bhoreal/bhoreal/software/Processing/bhorealEmulator/data/Wood Black top.jpg

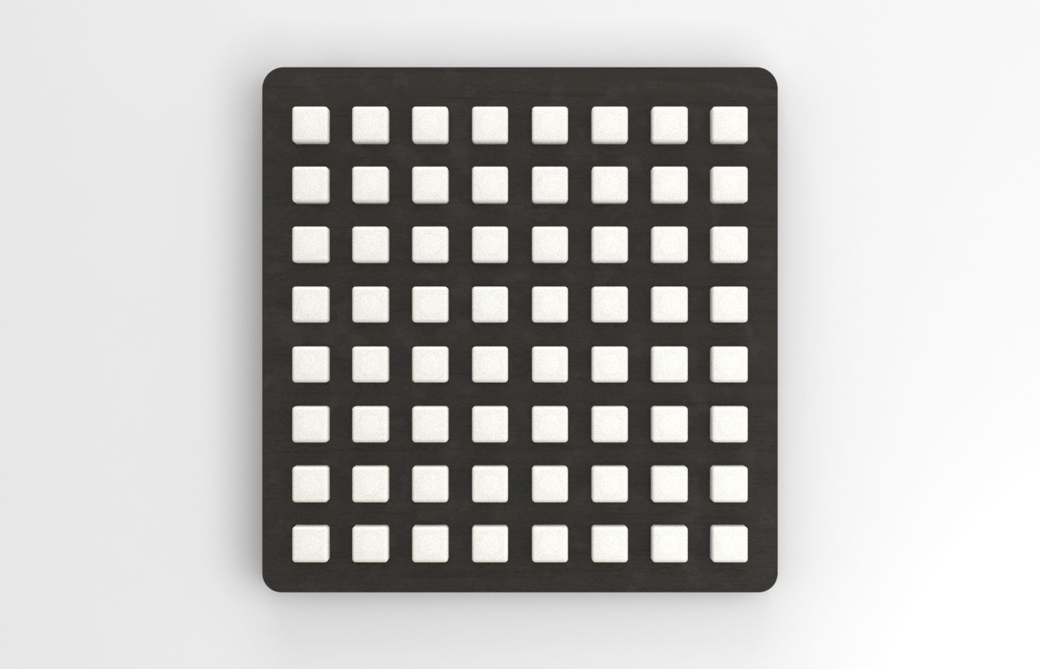
software/Processing/bhorealEmulator/data/Wood Black top.jpg
