bhoreal/bhoreal/software/Processing/bhorealEmulator/data/back_iPad.jpg

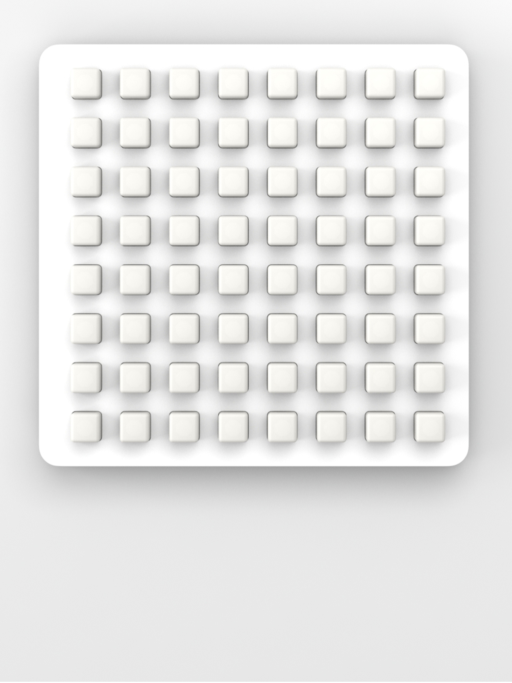
software/Processing/bhorealEmulator/data/back_iPad.jpg
