bhoreal/bhoreal/software/Processing/bhorealEmulator/data/fondo.png

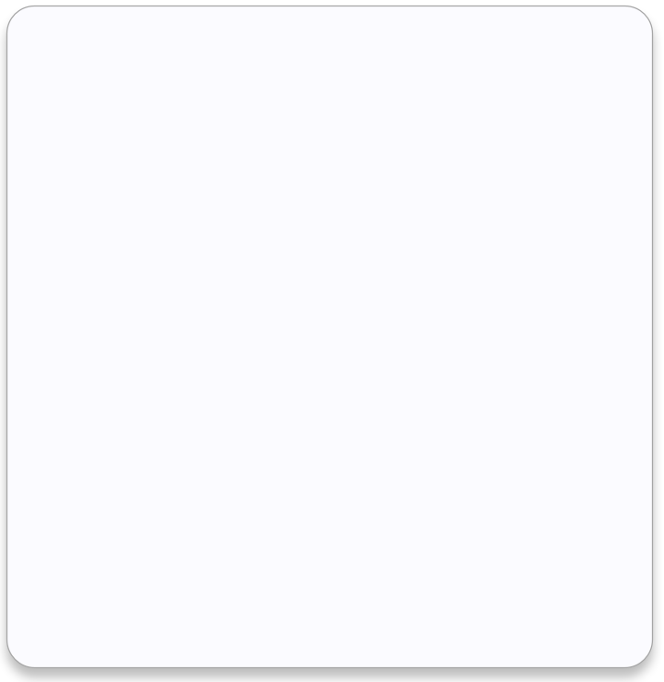
software/Processing/bhorealEmulator/data/fondo.png
