bhoreal/bhoreal/software/Processing/bhorealEmulator/data/fondoBlack.png

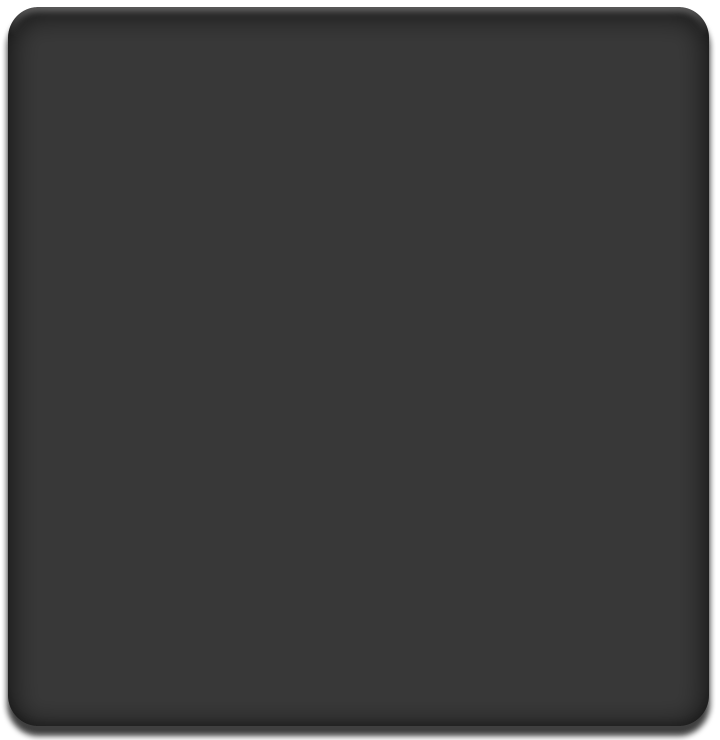
software/Processing/bhorealEmulator/data/fondoBlack.png
