bhoreal/bhoreal/hardware/Bhoreal Mini Slim Schematics/bhoreal_mini_bom.png

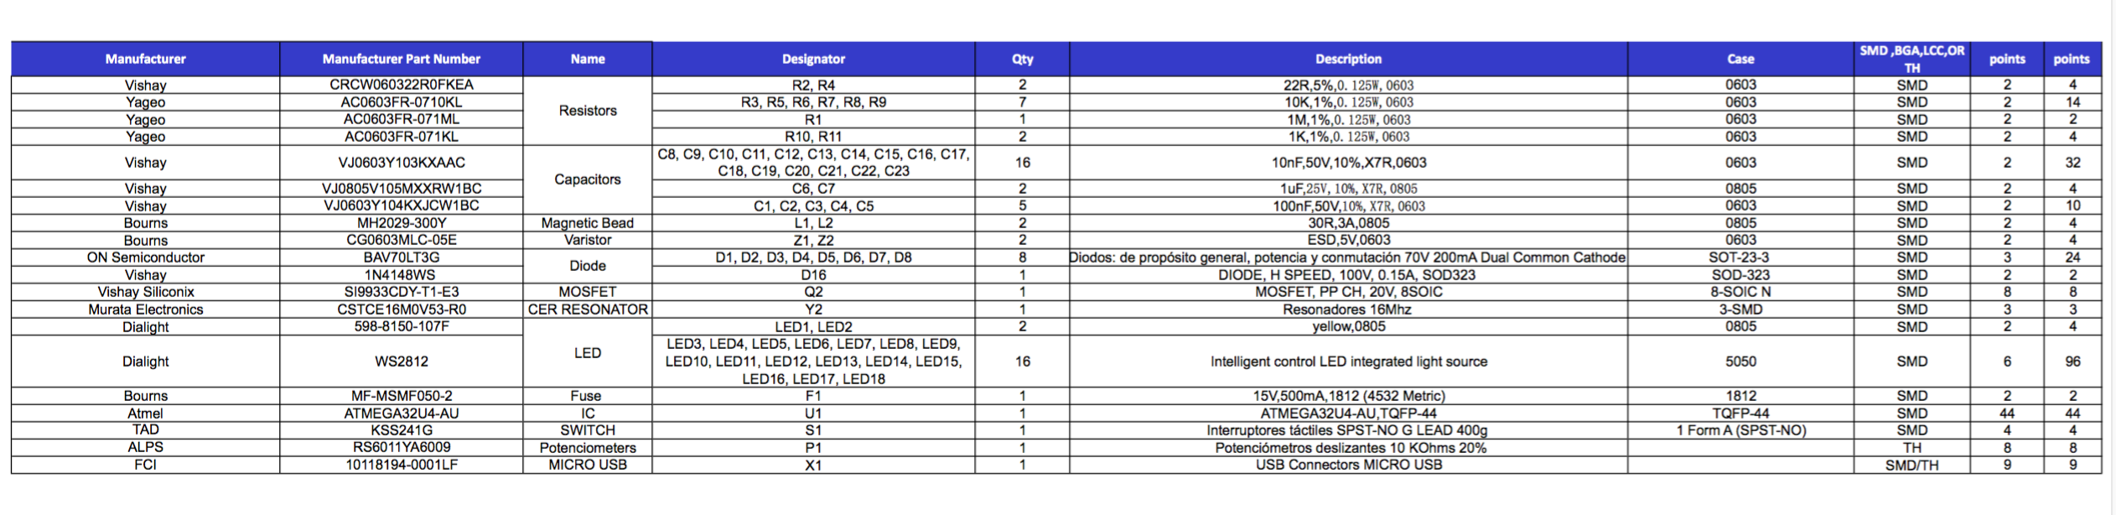
hardware/Bhoreal Mini Slim Schematics/bhoreal_mini_bom.png
