bhoreal/bhoreal/hardware/Bhoreal Slim Pro Schematics/bhoral_slimpro_bom.png

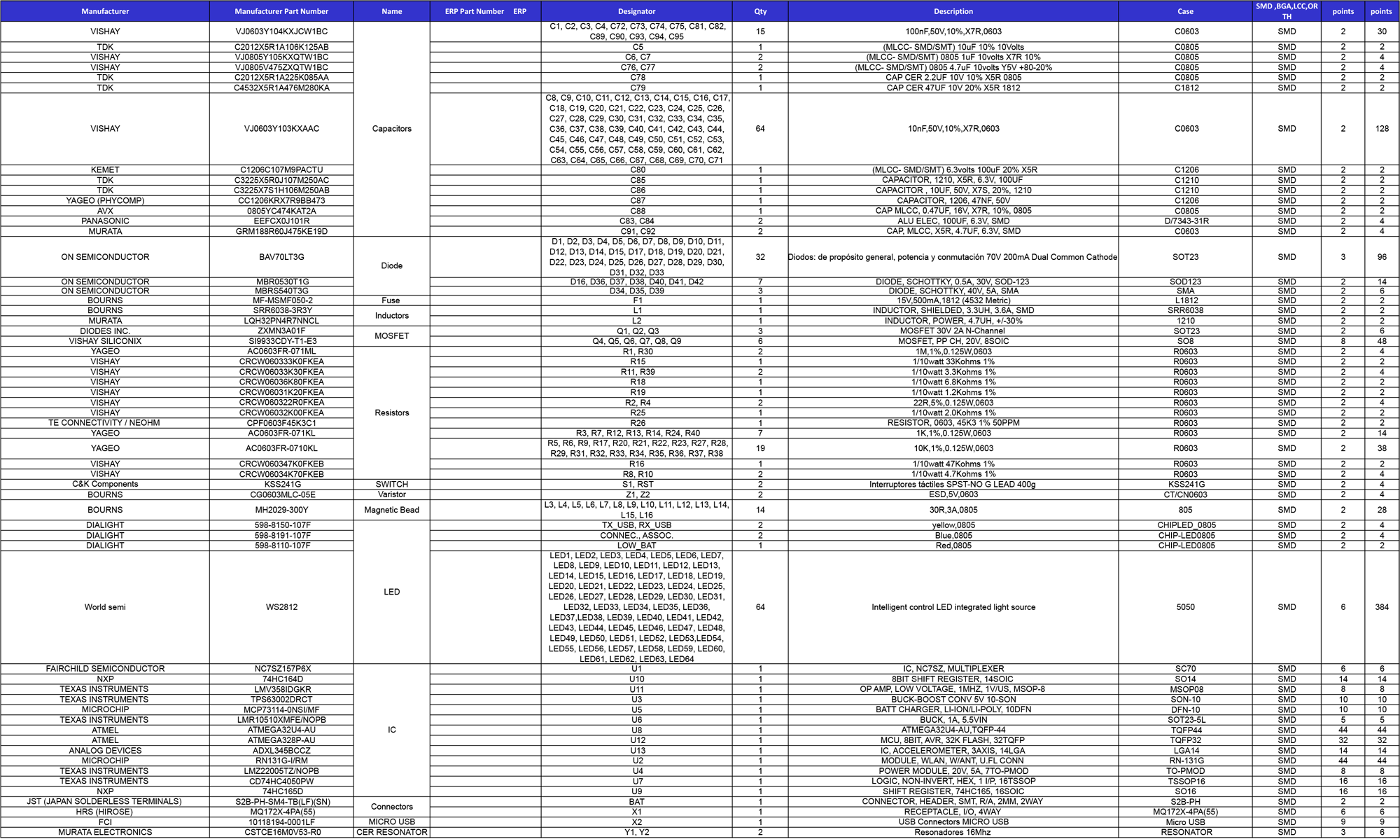
hardware/Bhoreal Slim Pro Schematics/bhoral_slimpro_bom.png
