bhoreal/bhoreal/(threads)

Thread 1 (2016-10-19):

Case-layout

bennigraf, 2016-10-19:
Hey guys,

not sure if there's still some life in here, but I'll give it a try:

I backed the original non-slim bhoreal without a case back then. Is there some basic layout file for a laser-cut case for this available?

Thanks,
Benni.

makegeneve, 2018-02-23:
The original promise for this included hardware design files for the casing.  I'll start drawing up one soon, but if you guys have them lying around and could post them it would save a bunch of music-making time...

bennigraf, 2018-02-23:
@makegeneve Back then, I started to create my own simple laser-cut-case. I never actually finished it, but maybe you could use it as a starting point :-). I just uploaded it here: https://github.com/bennigraf/bhoreal-case

Also let me know if you come up with something, as my bhoreal is still laying around naked ;-).
