bhoreal/bhoreal/hardware/Bhoreal Slim Pro Schematics/Bhoreal Slimpro.pdf

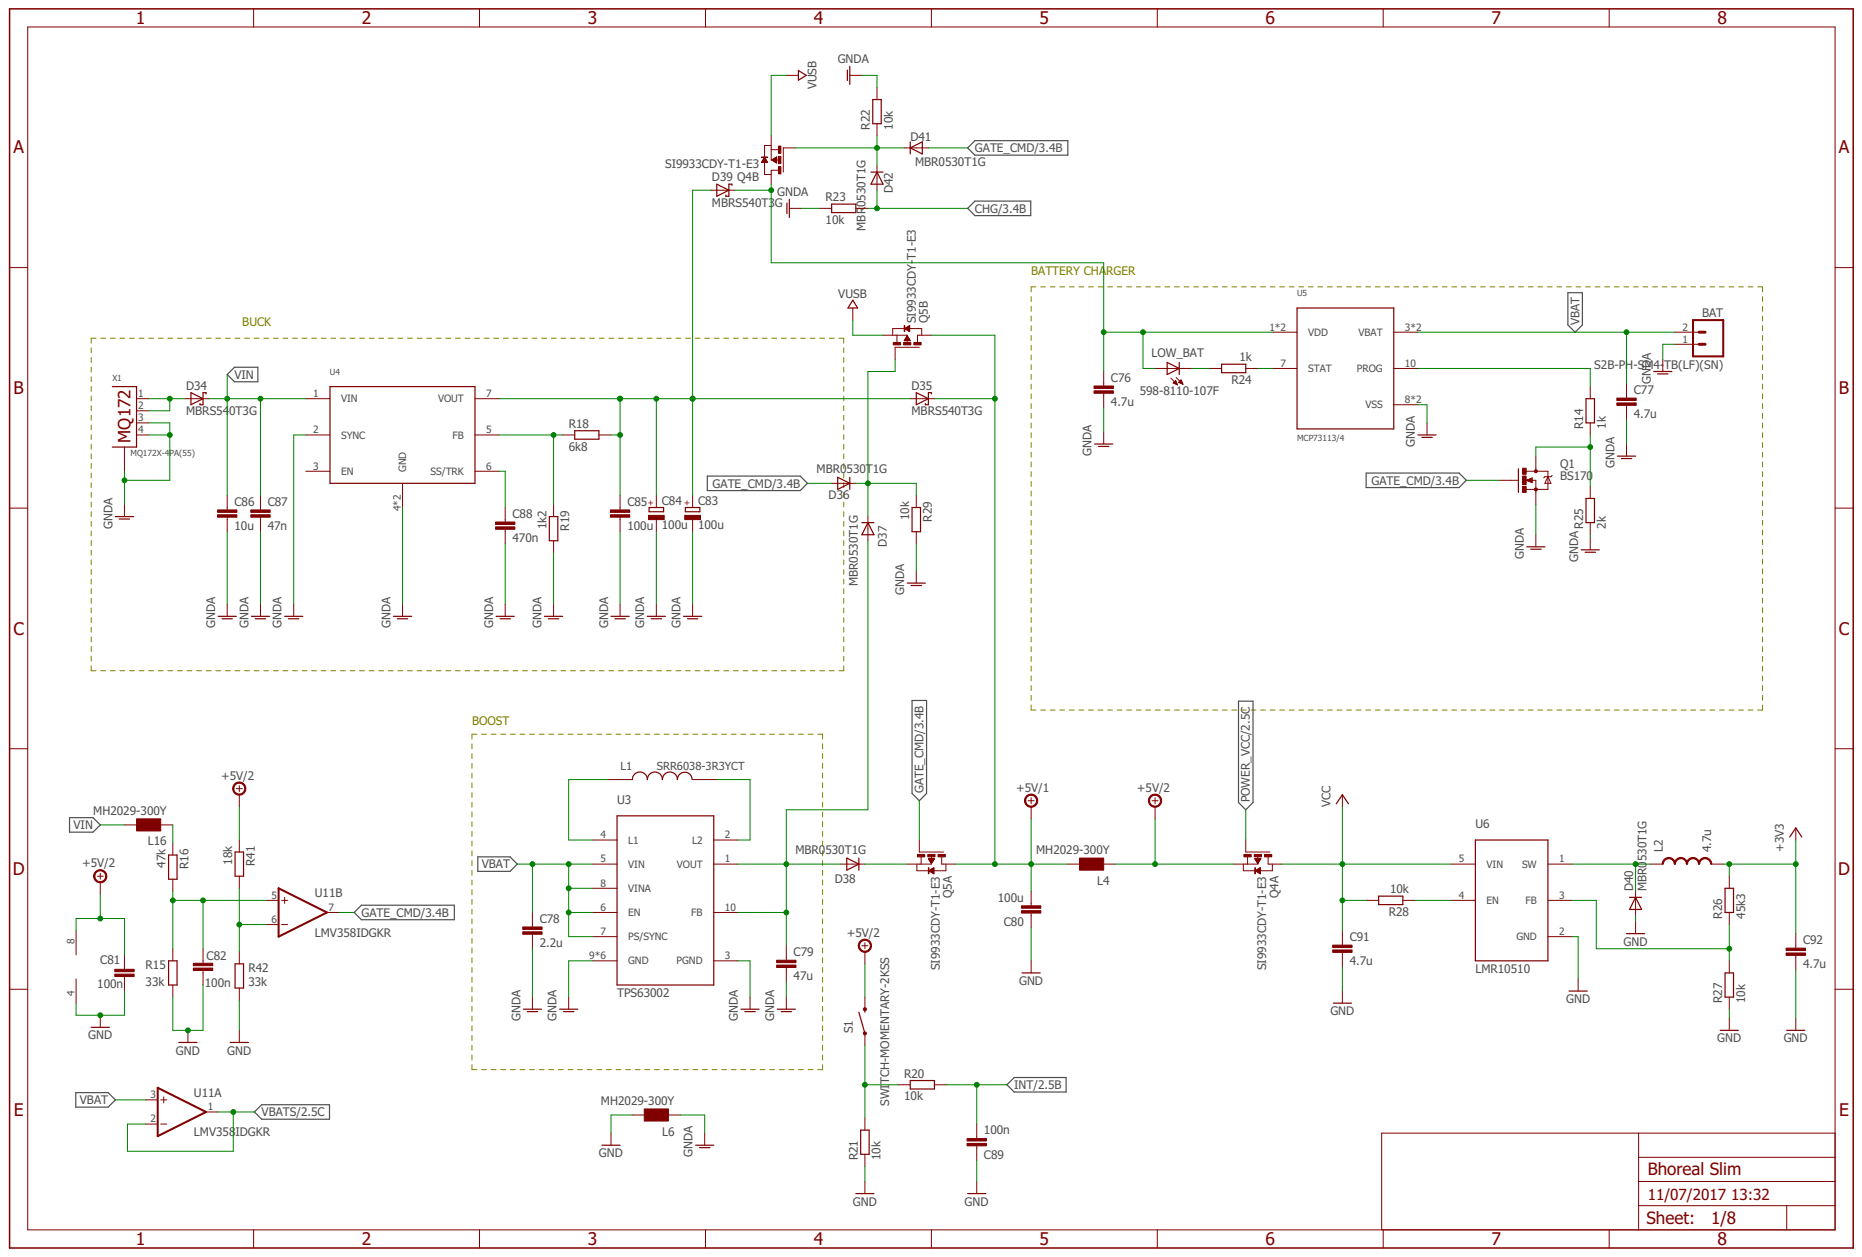
[picture p7: page 1]

GNDA GNDA

GNDA GNDA GNDA GNDA GNDA

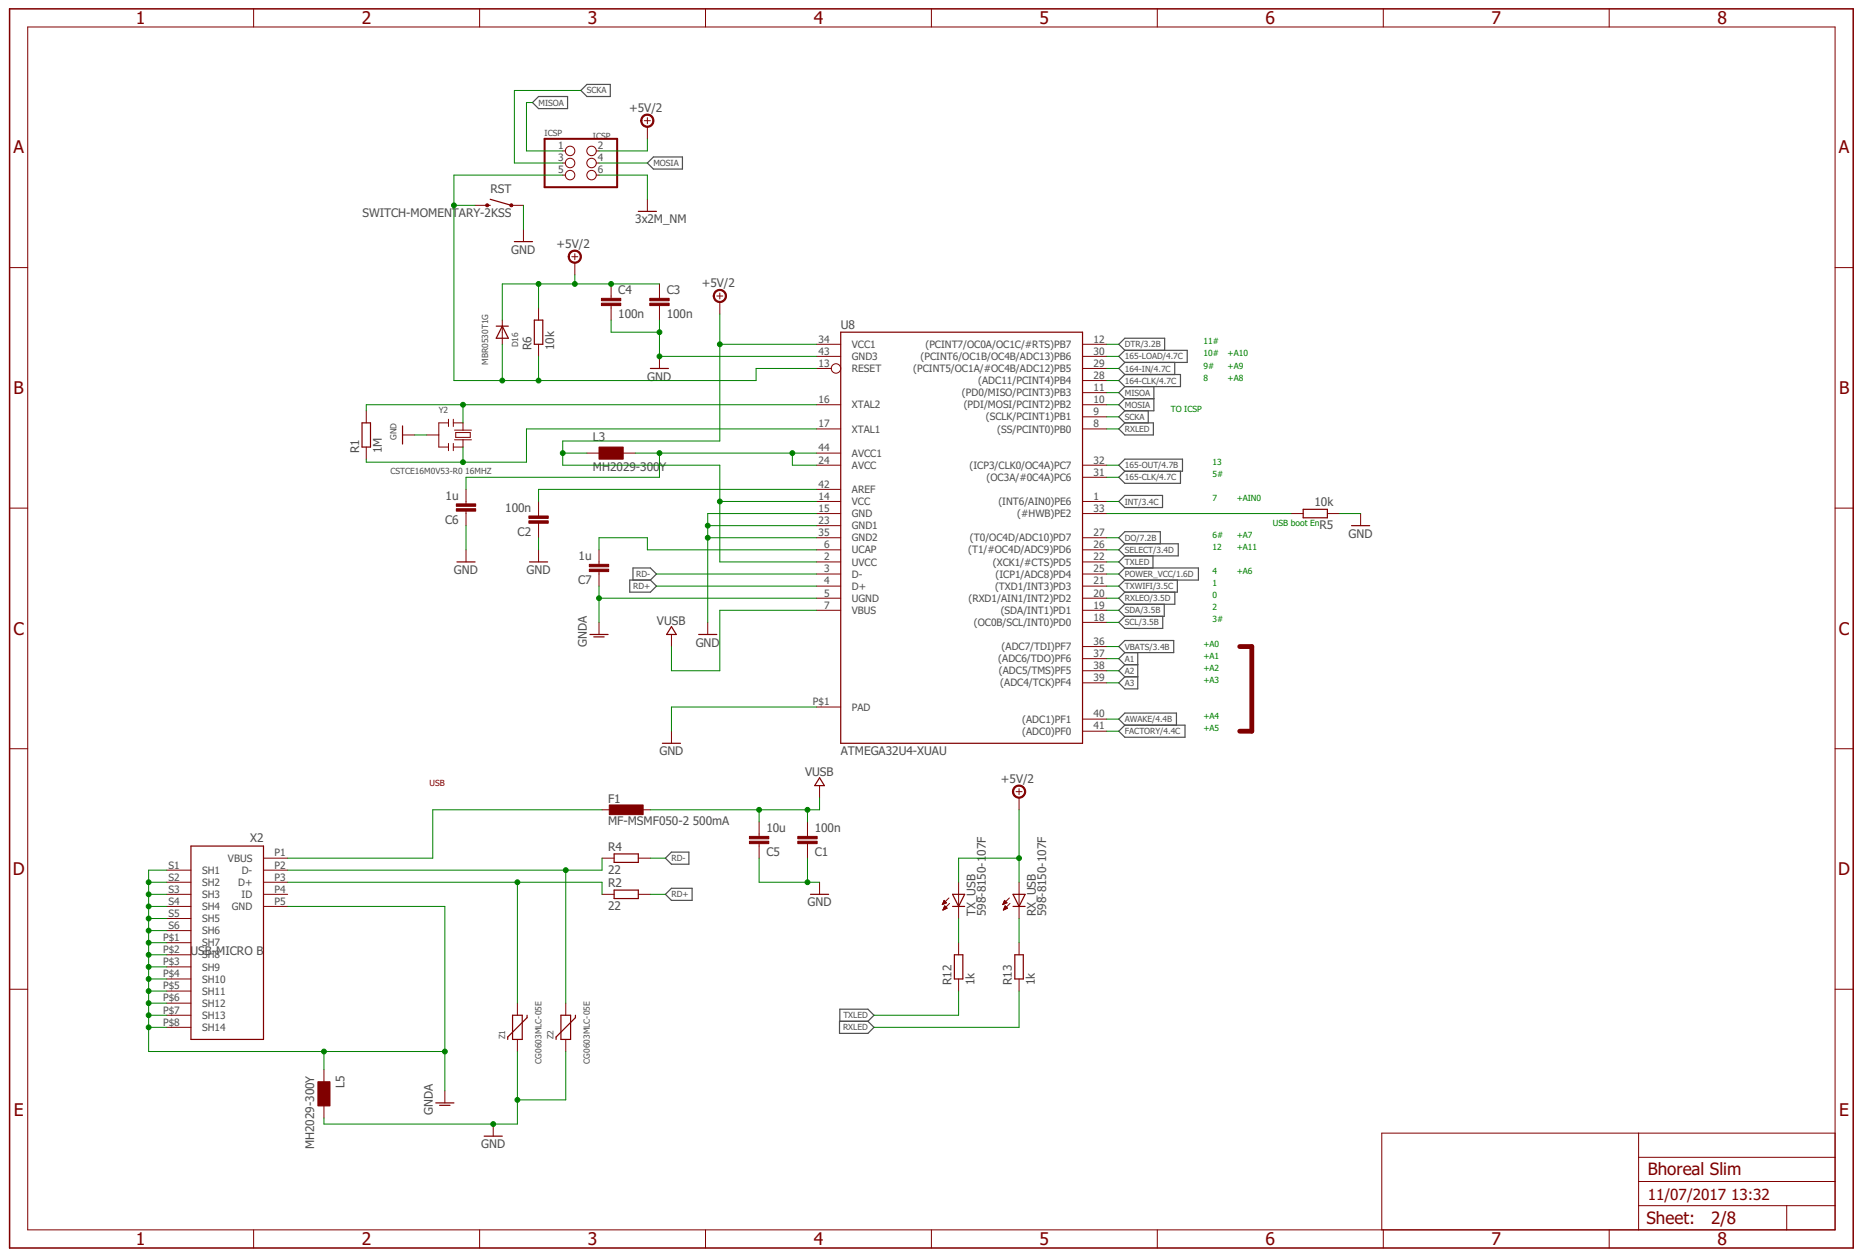
[picture p8: page 2]

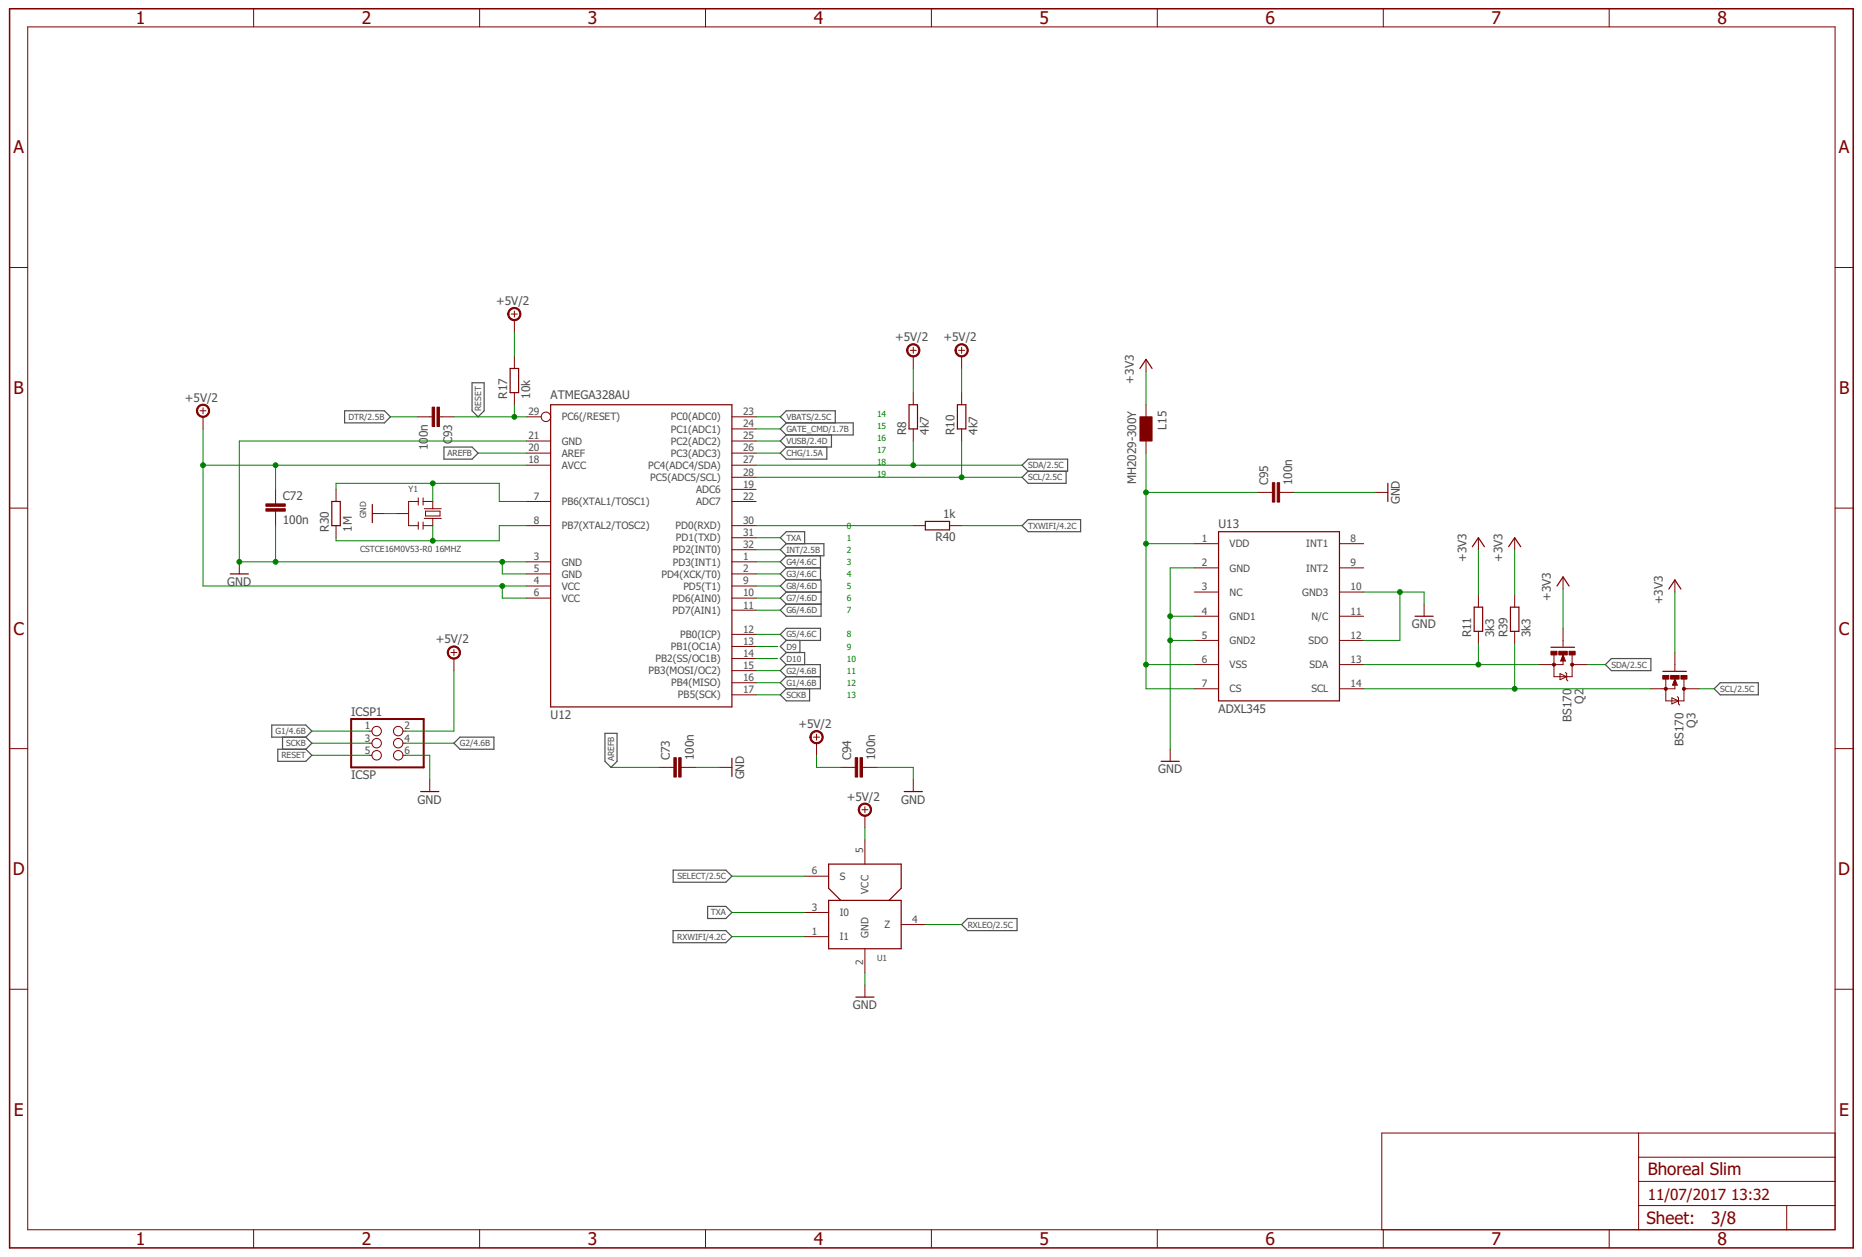
[picture p9: page 3]

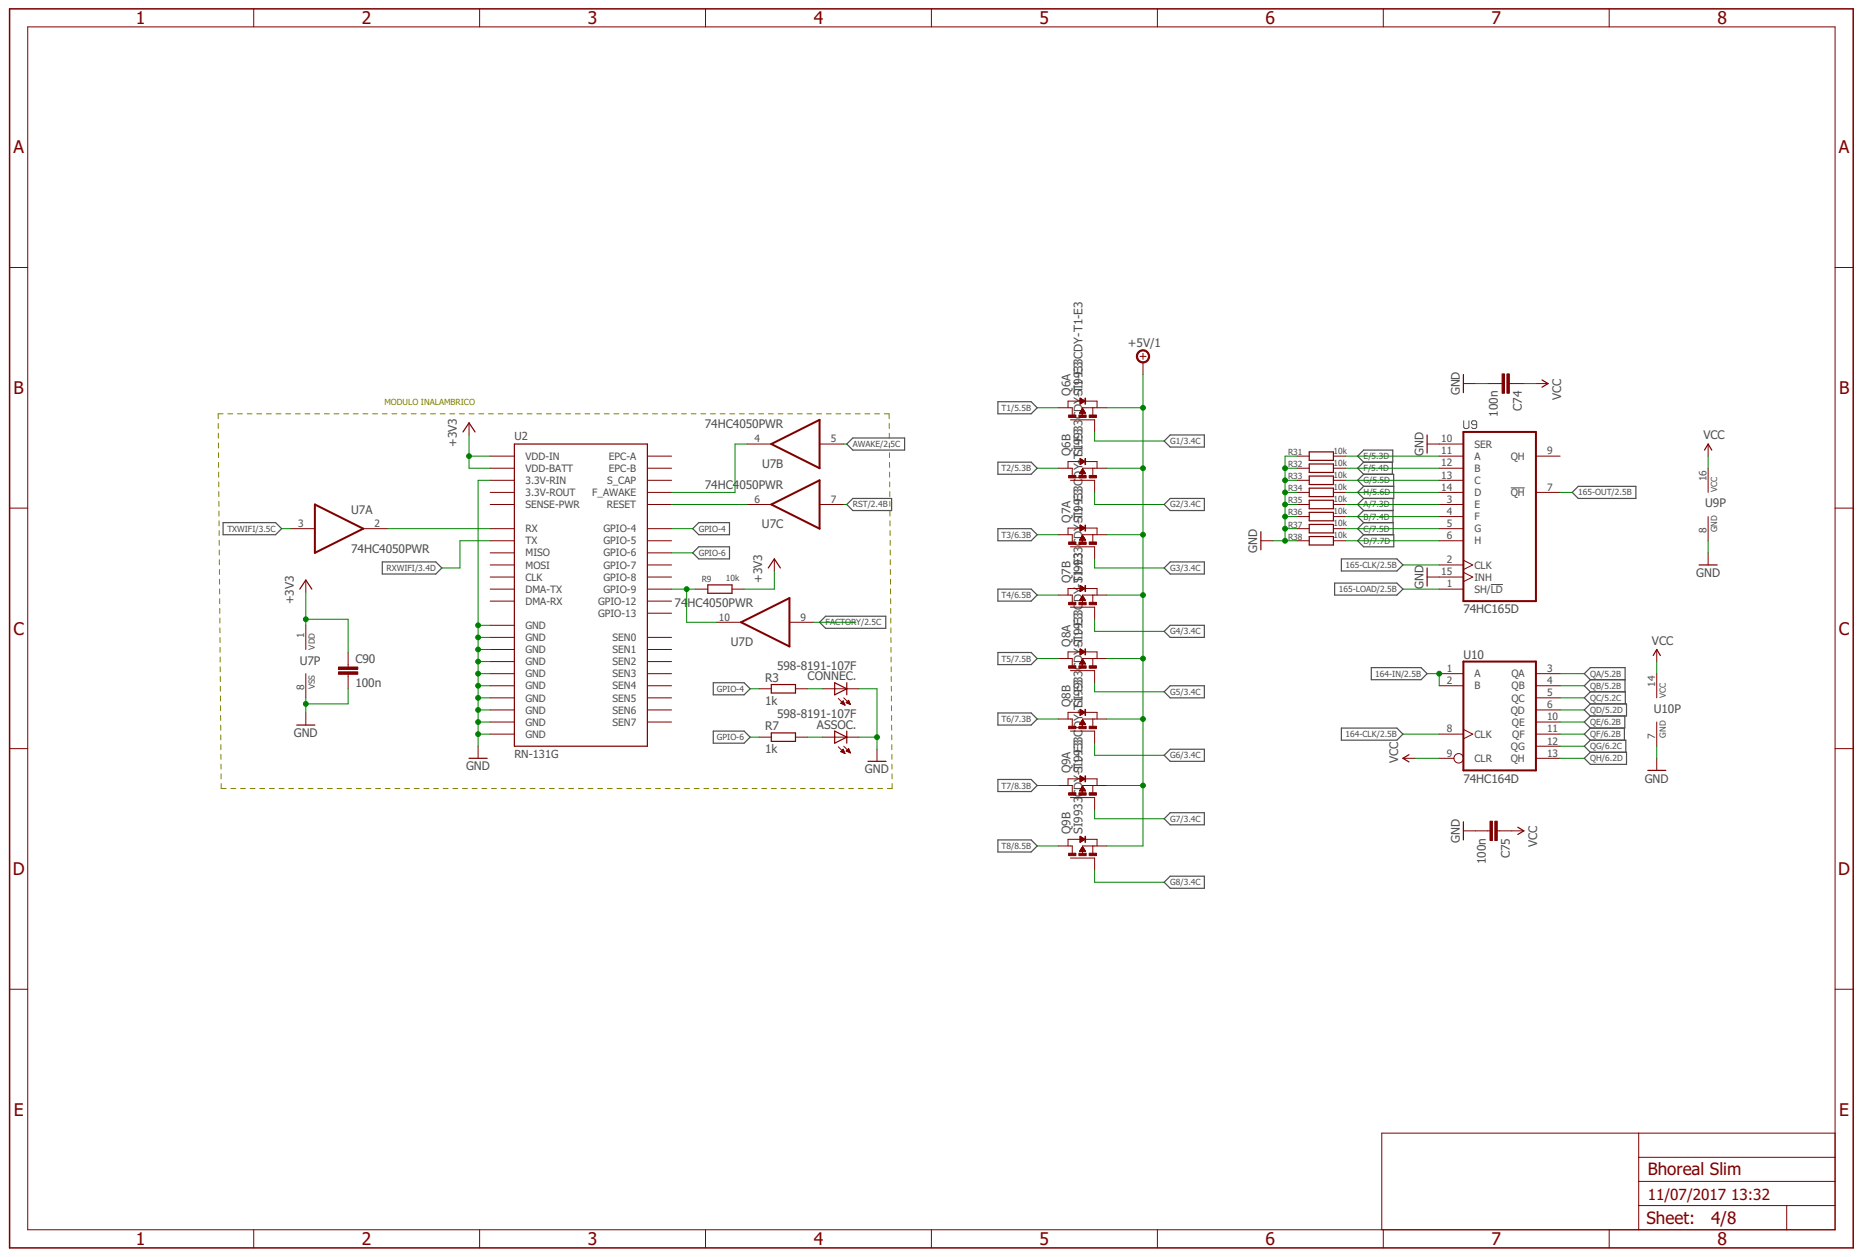
[picture p10: page 4]

VDD-BATT VDD-IN

VCC

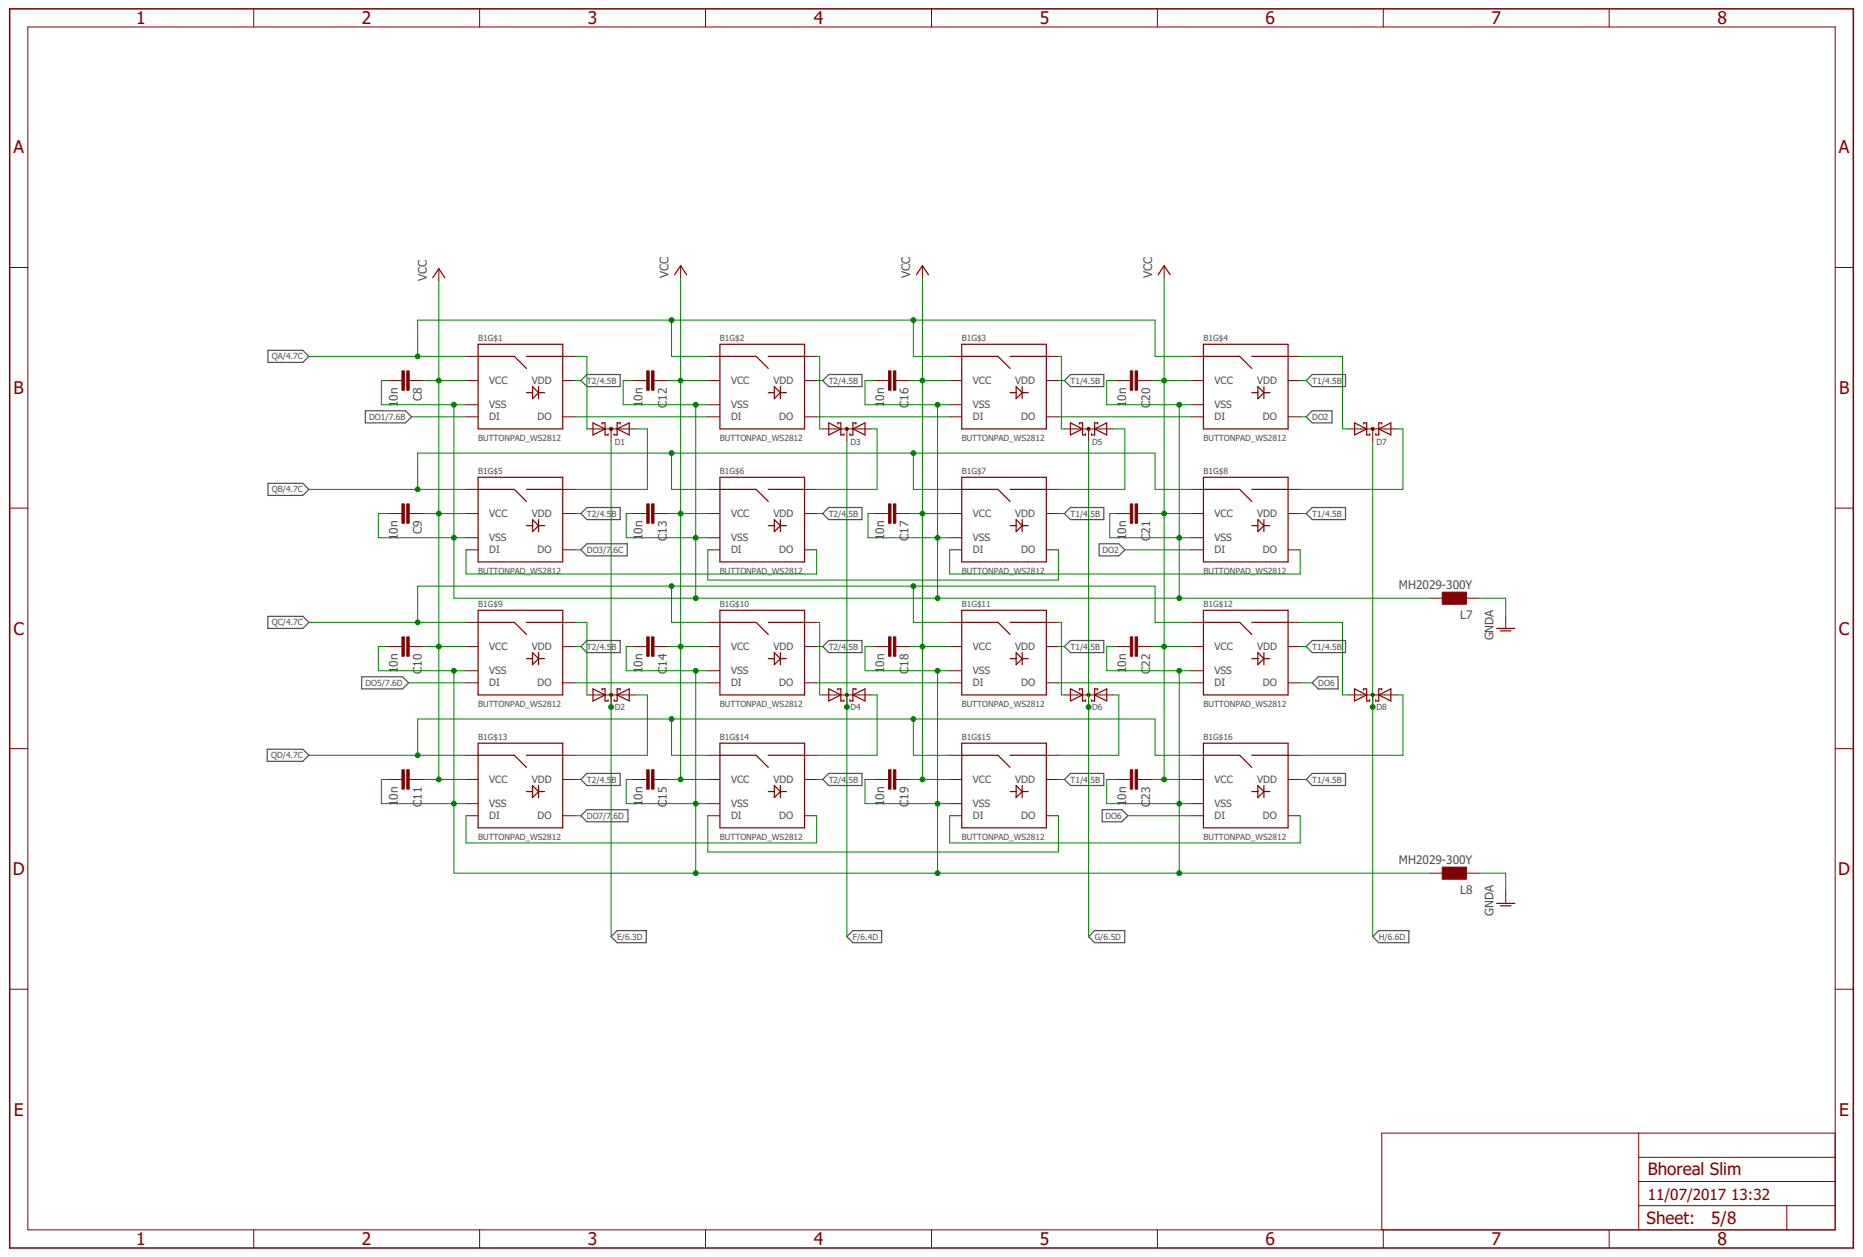
[picture p11: page 5]

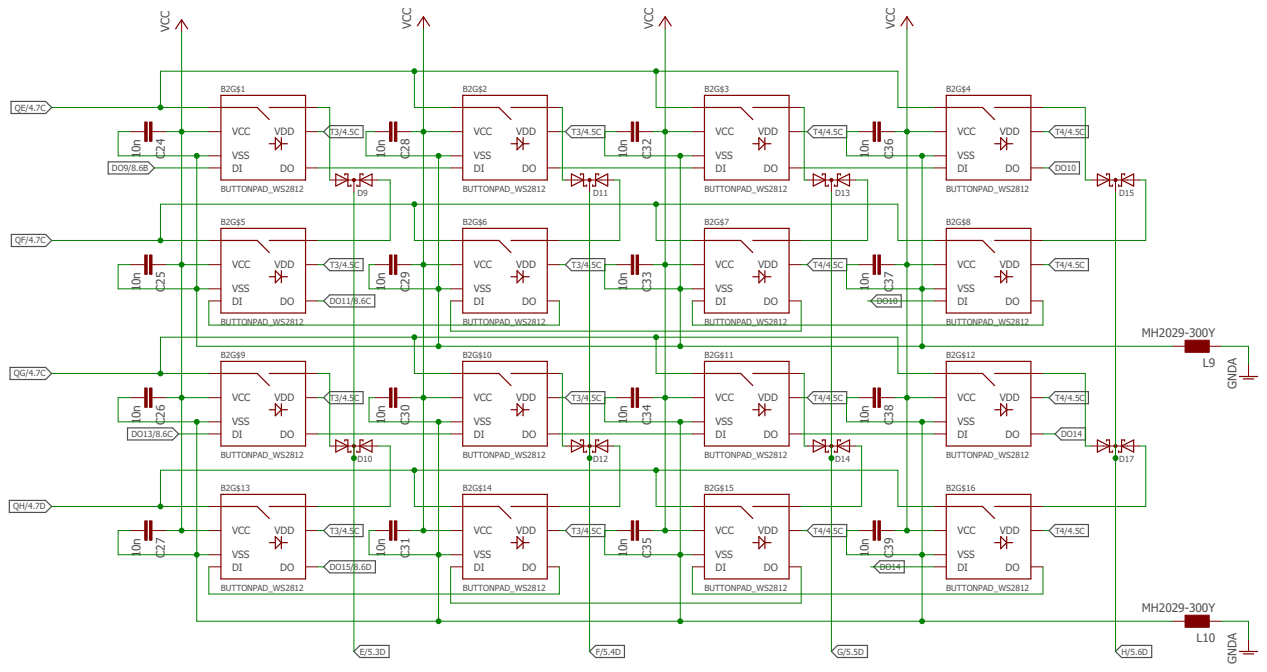
[picture p12: page 6]

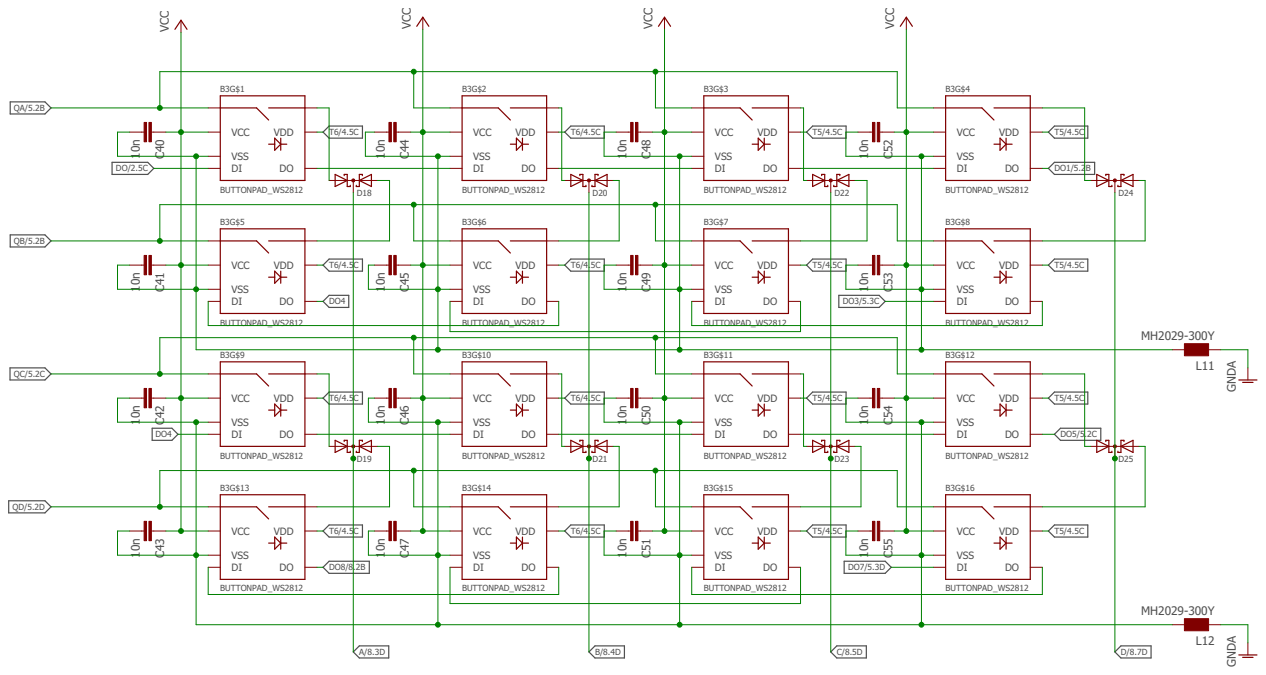
[picture p13: page 7]

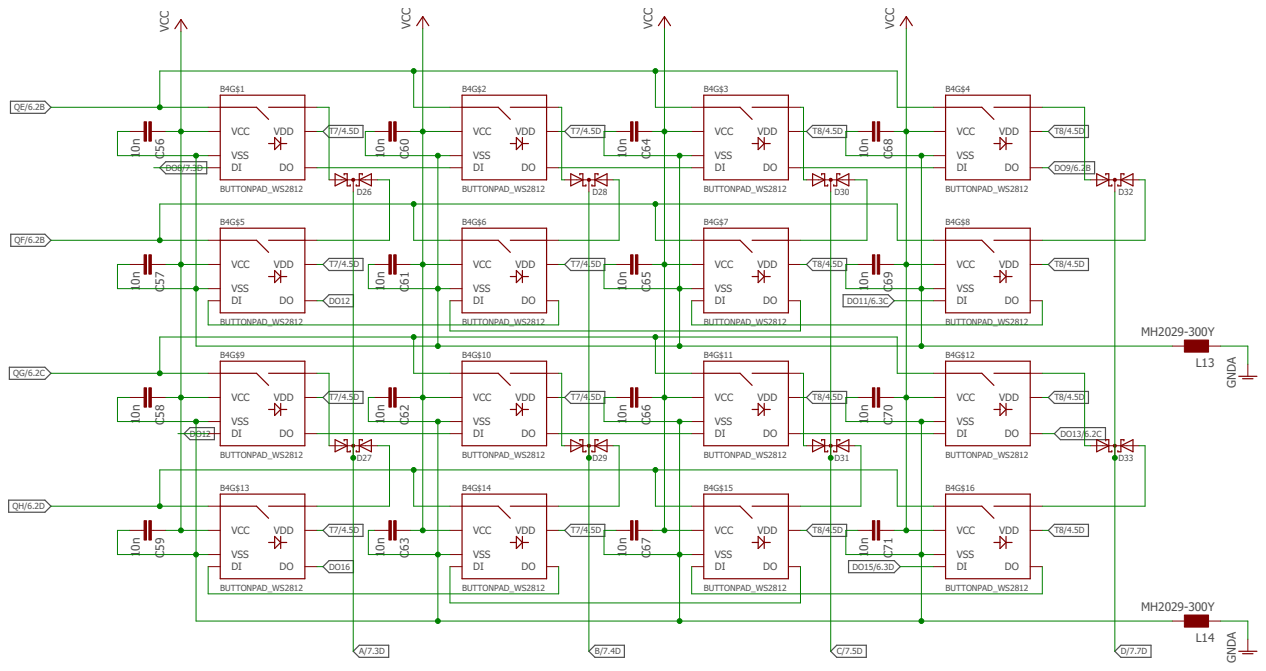
[picture p14: page 8]
