bhoreal/bhoreal/hardware/Bhoreal Mini Slim Schematics/Bhoreal mini.pdf

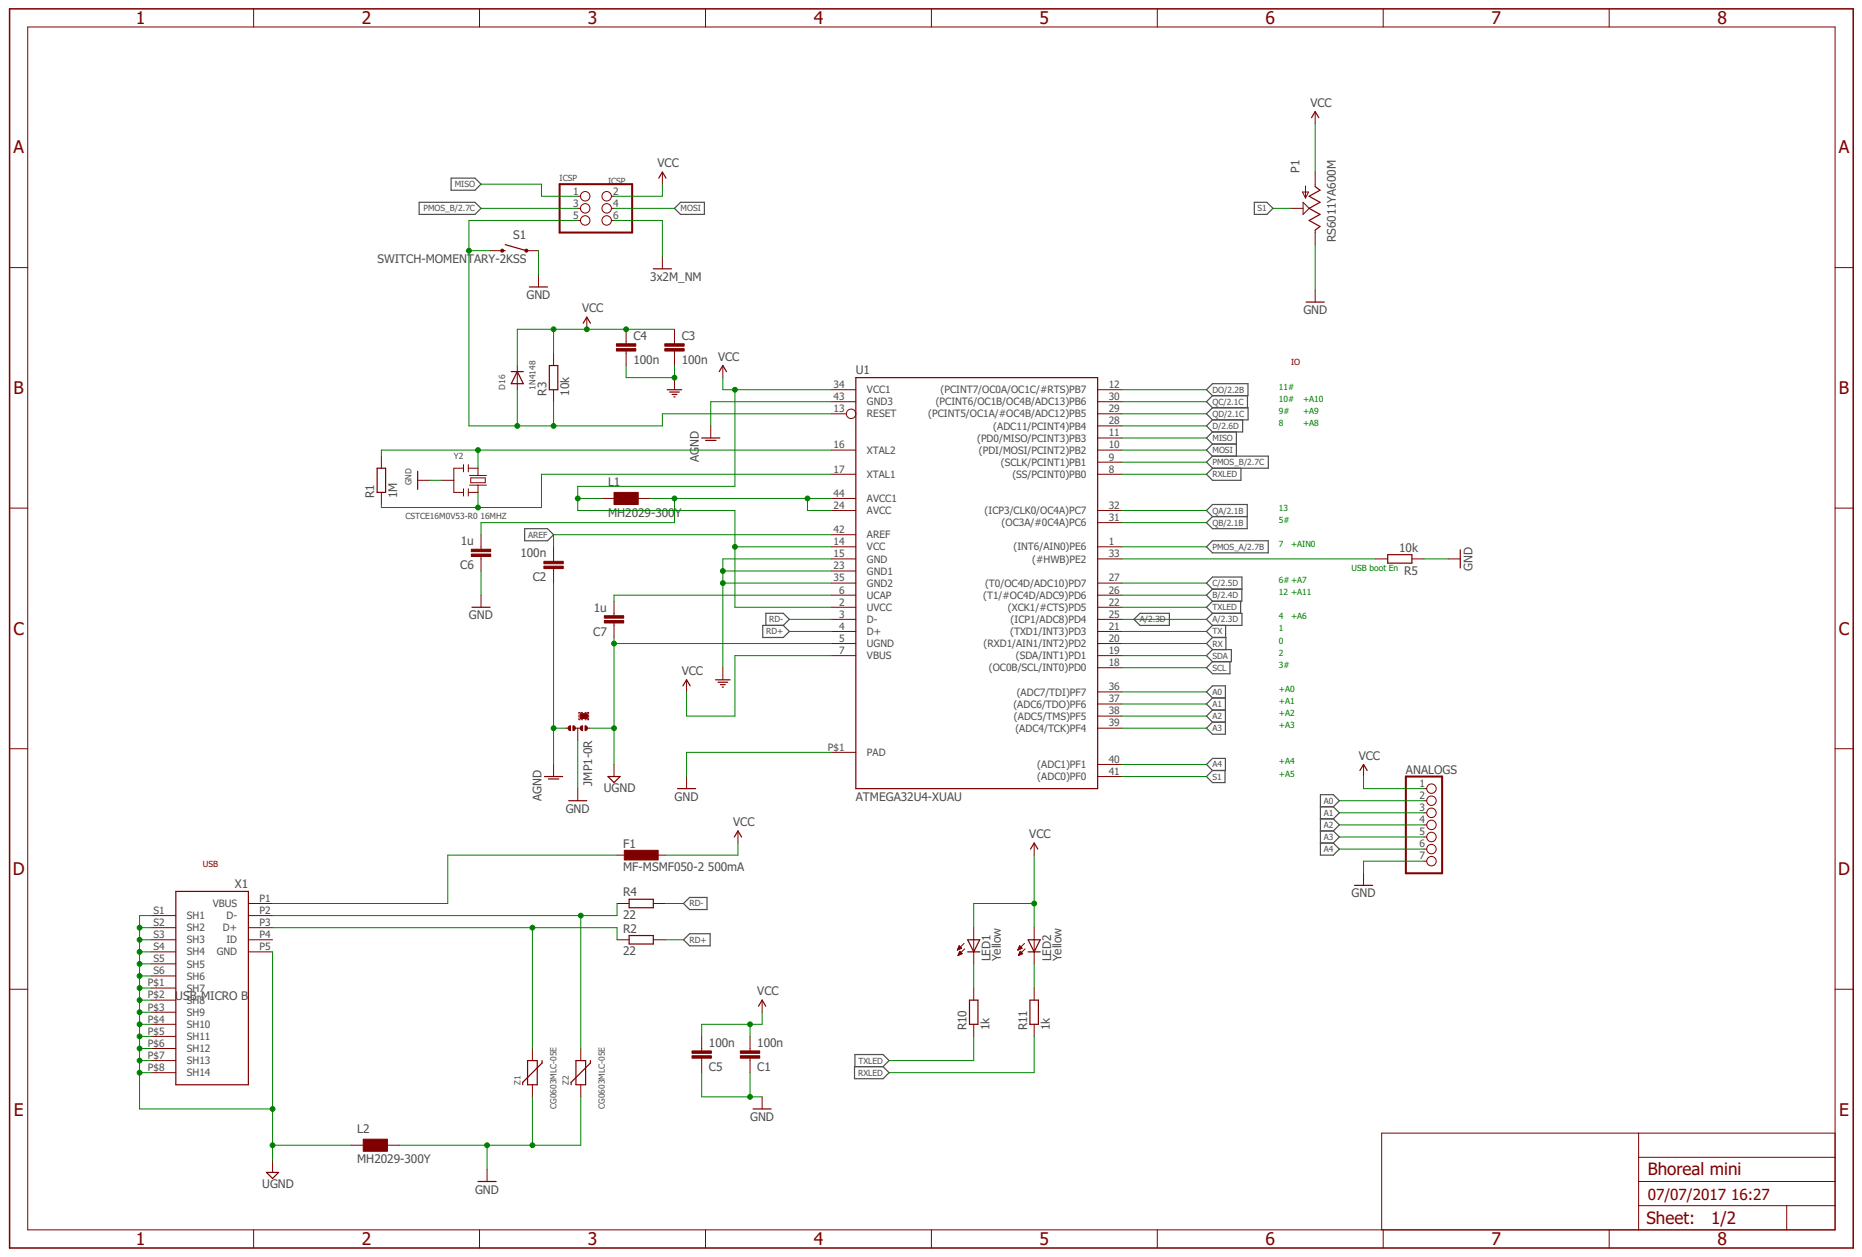
[picture p15: page 1]

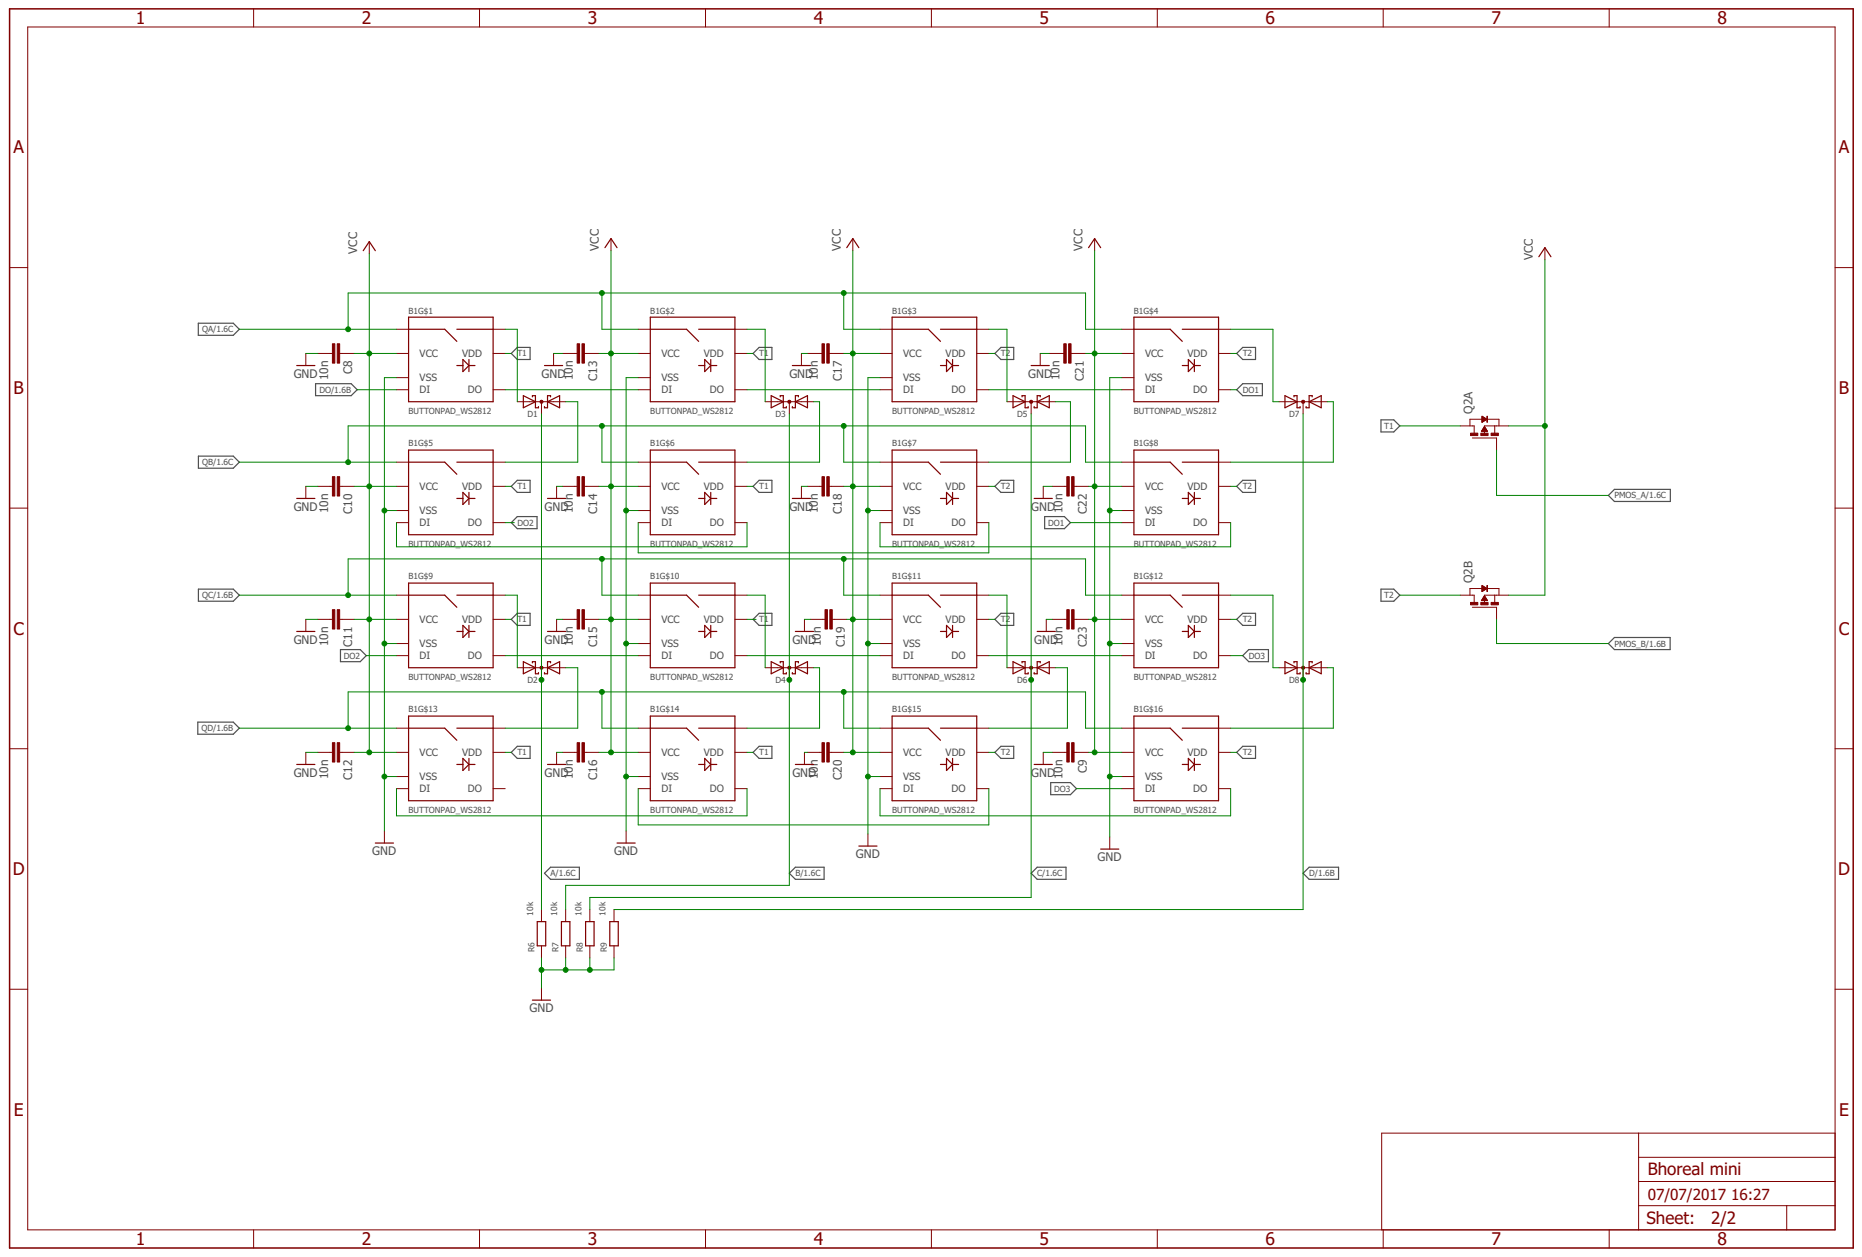
[picture p16: page 2]

B1G$9 | B1G$10 | GND | B1G$11
