bhoreal/bhoreal/hardware/Bhoreal Slim Pro Schematics/Bhoreal Slimpro.brd

## EAGLE design hardware/Bhoreal Slim Pro Schematics/Bhoreal Slimpro.brd (2017-07-11)

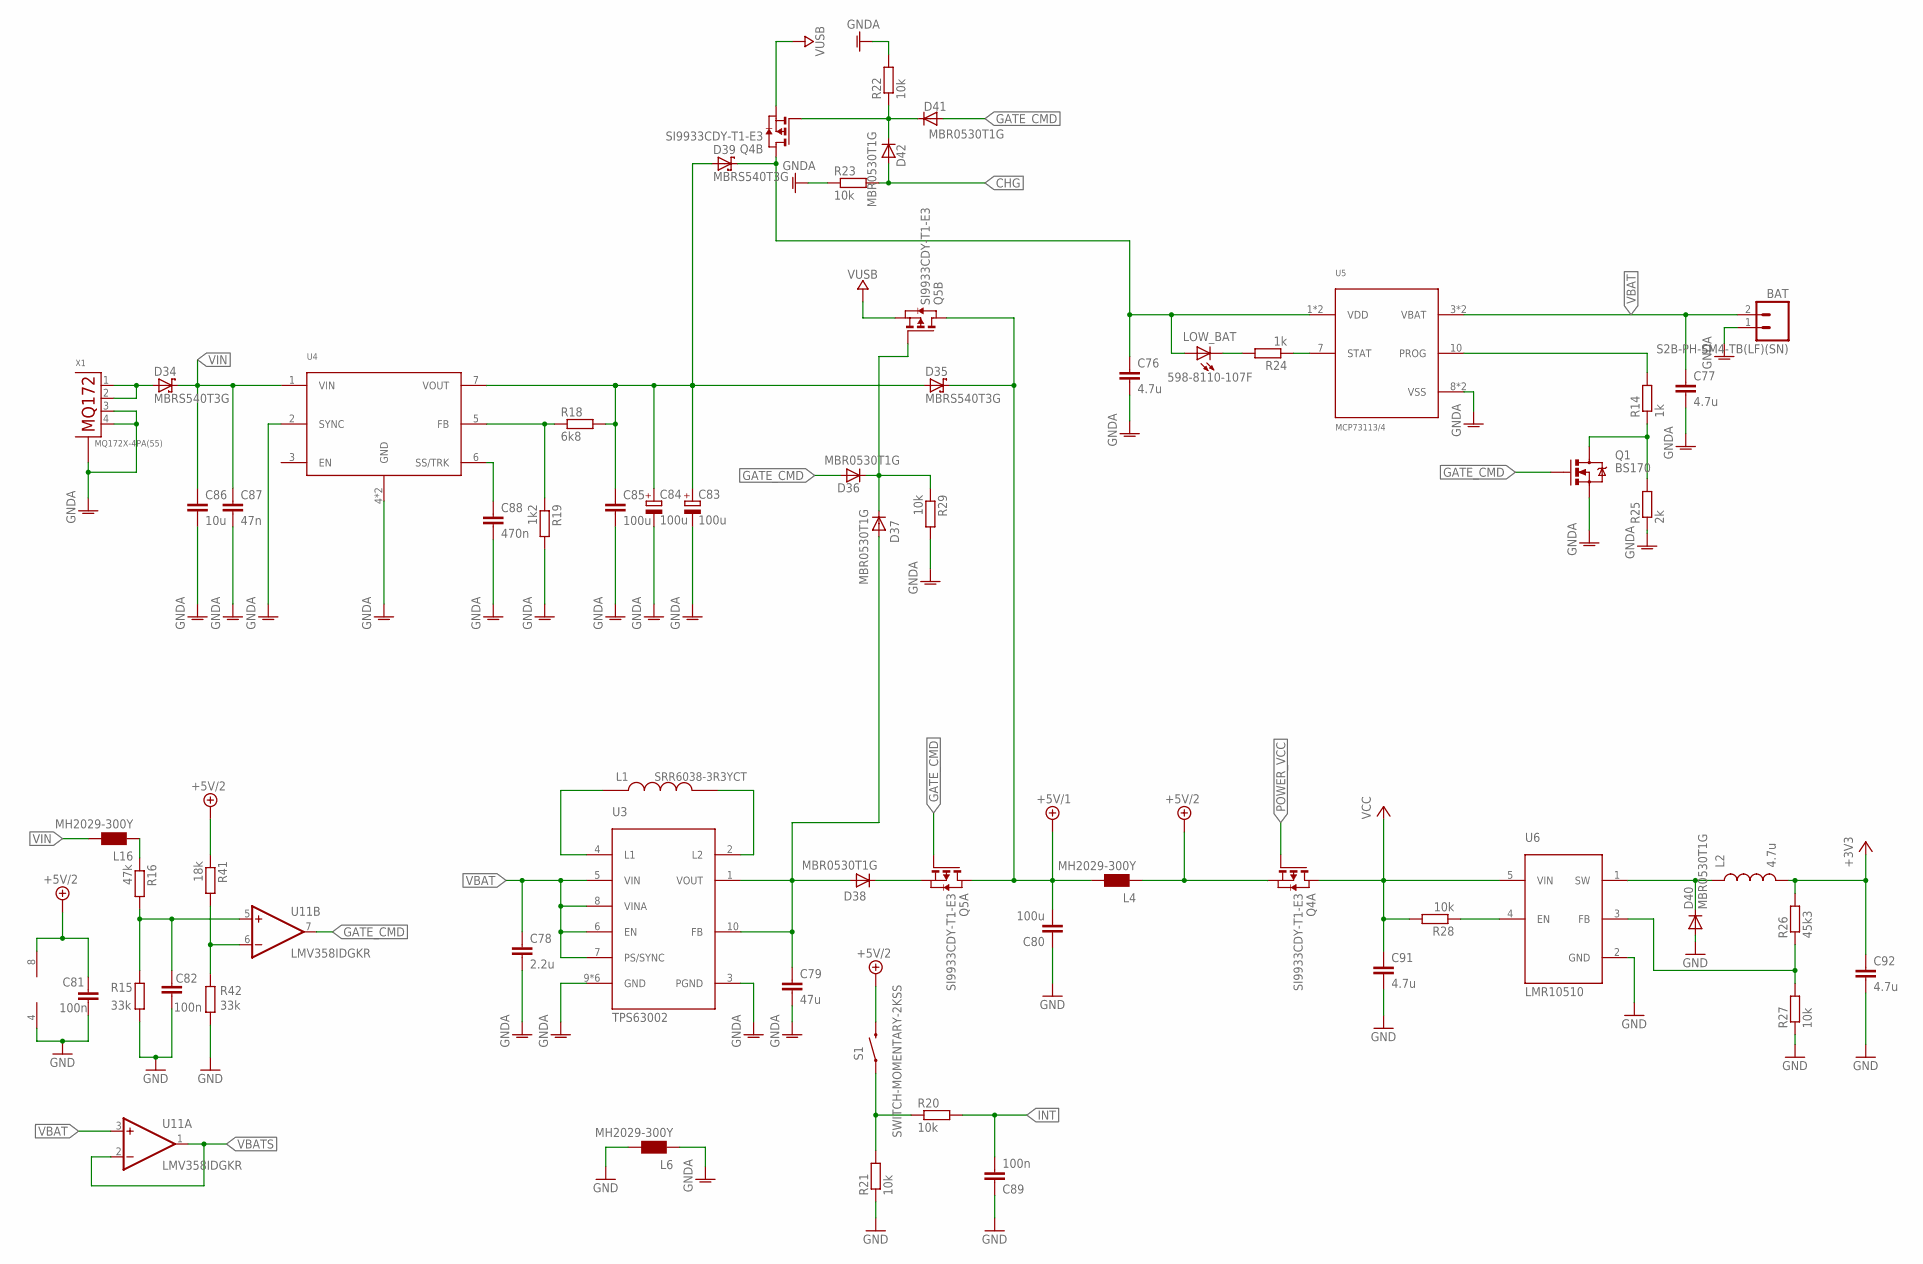
[picture p17: schematic Bhoreal Slimpro.sch, sheet 1]

Parts:
BAT: S2B-PH-SM4-TB(LF)(SN); S2B-PH
C76, C77: 4.7u; C0805
C78: 2.2u; C0805
C79: 47u; C1812
C80: 100u; C1206
C81, C82, C89: 100n; C0603
C83, C84: 100u; D/7343-31R
C85: 100u; C1210
C86: 10u; C1210
C87: 47n; C1206
C88: 470n; C0805
C91, C92: 4.7u; C0603
D34, D35, D39: MBRS540T3G; SMC
D36, D37, D38, D40, D41, D42: MBR0530T1G; SOD123
L1: SRR6038-3R3YCT; SRR6038
L2: 4.7u; 1210
L4, L6, L16: MH2029-300Y; 0805
LOW_BAT: 598-8110-107F; CHIP-LED0805
Q1: BS170; SOT23
Q4, Q5: SI9933CDY-T1-E3; SO8
R14, R24: 1k; R0603
R15, R42: 33k; R0603
R16: 47k; R0603
R18: 6k8; R0603
R19: 1k2; R0603
R20, R21, R22, R23, R27, R28, R29: 10k; R0603
R25: 2k; R0603
R26: 45k3; R0603
R41: 18k; R0603
S1: SWITCH-MOMENTARY-2KSS; KSS241G
U3: TPS63002; QFN-10_PAD
U4: LMZ2200X; TO-PMOD
U5: MCP73113/4; DFN-10
U6: LMR10510; SOT23-5L
U11: LMV358IDGKR; MSOP08
X1: MQ172X-4PA(55)

Connections:
+3V3: C92.1, L2.2, R26.2; also elsewhere on the board
+5V/1: C80.2, D35.C, L4.2, Q5.5 (D), Q5.6 (D), Q5.7 (D), Q5.8 (D); also elsewhere on the board
+5V/2: C81.1, L4.1, Q4.1 (S), R41.1, S1.2, U11.8 (V+); also elsewhere on the board
CHG: D42.A, R23.2; also elsewhere on the board
CMP: C82.2, R15.1, R16.2, U11.5 (+IN)
GATE_CMD: D36.A, D41.A, Q1.1 (G), Q5.2 (G), U11.7 (OUT); also elsewhere on the board
GND: C80.1, C81.2, C82.1, C89.1, C91.2, C92.2, D40.A, L6.2, R15.2, R21.1, R27.1, R42.2, U6.2 (GND), U11.4 (V-); also elsewhere on the board
GNDA: BAT.1, C76.2, C77.2, C78.2, C79.2, C83.-, C84.-, C85.2, C86.2, C87.2, C88.2, L6.1, Q1.2 (S), R19.2, R22.2, R23.1, R25.1, R29.2, U3.3 (PGND), U3.9 (GND), U3.11 (GND), U3.12 (GND), U3.13 (GND), U3.14 (GND), U3.15 (GND), U4.2 (SYNC), U4.4 (GND), U4.8 (GND), U5.8 (VSS), U5.9 (VSS), X1.3, X1.4, X1.P$1, X1.P$2; also elsewhere on the board
INT: C89.2, R20.2; also elsewhere on the board
unnamed: R41.2, R42.1, U11.6 (-IN)
unnamed: D41.C, D42.C, Q4.4 (G), R22.1
unnamed: R14.2, U5.10 (PROG)
unnamed: L1.P$1 (1), U3.4 (L1)
unnamed: L1.P$2 (2), U3.2 (L2)
unnamed: D34.A, X1.1, X1.2
unnamed: C79.1, D37.A, D38.A, U3.1 (VOUT), U3.10 (FB)
unnamed: C76.1, D39.C, LOW_BAT.A, Q4.5 (D), Q4.6 (D), U5.1 (VDD), U5.2 (VDD)
unnamed: C83.+, C84.+, C85.1, D35.A, D39.A, R18.2, U4.7 (VOUT)
unnamed: R18.1, R19.1, U4.5 (FB)
unnamed: C88.1, U4.6 (SS/TRK)
unnamed: R20.1, R21.2, S1.1
unnamed: D36.C, D37.C, Q5.4 (G), R29.1
unnamed: LOW_BAT.C, R24.2
unnamed: R24.1, U5.7 (STAT)
unnamed: Q1.3 (D), R14.1, R25.2
unnamed: D40.C, L2.1, U6.1 (SW)
unnamed: R28.1, U6.4 (EN)
unnamed: R26.1, R27.2, U6.3 (FB)
unnamed: D38.C, Q5.1 (S)
unnamed: L16.1, R16.1
POWER_VCC: Q4.2 (G); also elsewhere on the board
VBAT: BAT.2, C77.1, C78.1, U3.5 (VIN), U3.6 (EN), U3.7 (PS/SYNC), U3.8 (VINA), U5.3 (VBAT), U5.4 (VBAT), U11.3 (+IN)
VBATS: U11.1 (OUT), U11.2 (-IN); also elsewhere on the board
VCC: C91.1, Q4.7 (D), Q4.8 (D), R28.2, U6.5 (VIN); also elsewhere on the board
VIN: C86.1, C87.1, D34.C, L16.2, U4.1 (VIN)
VUSB: Q4.3 (S), Q5.3 (S); also elsewhere on the board

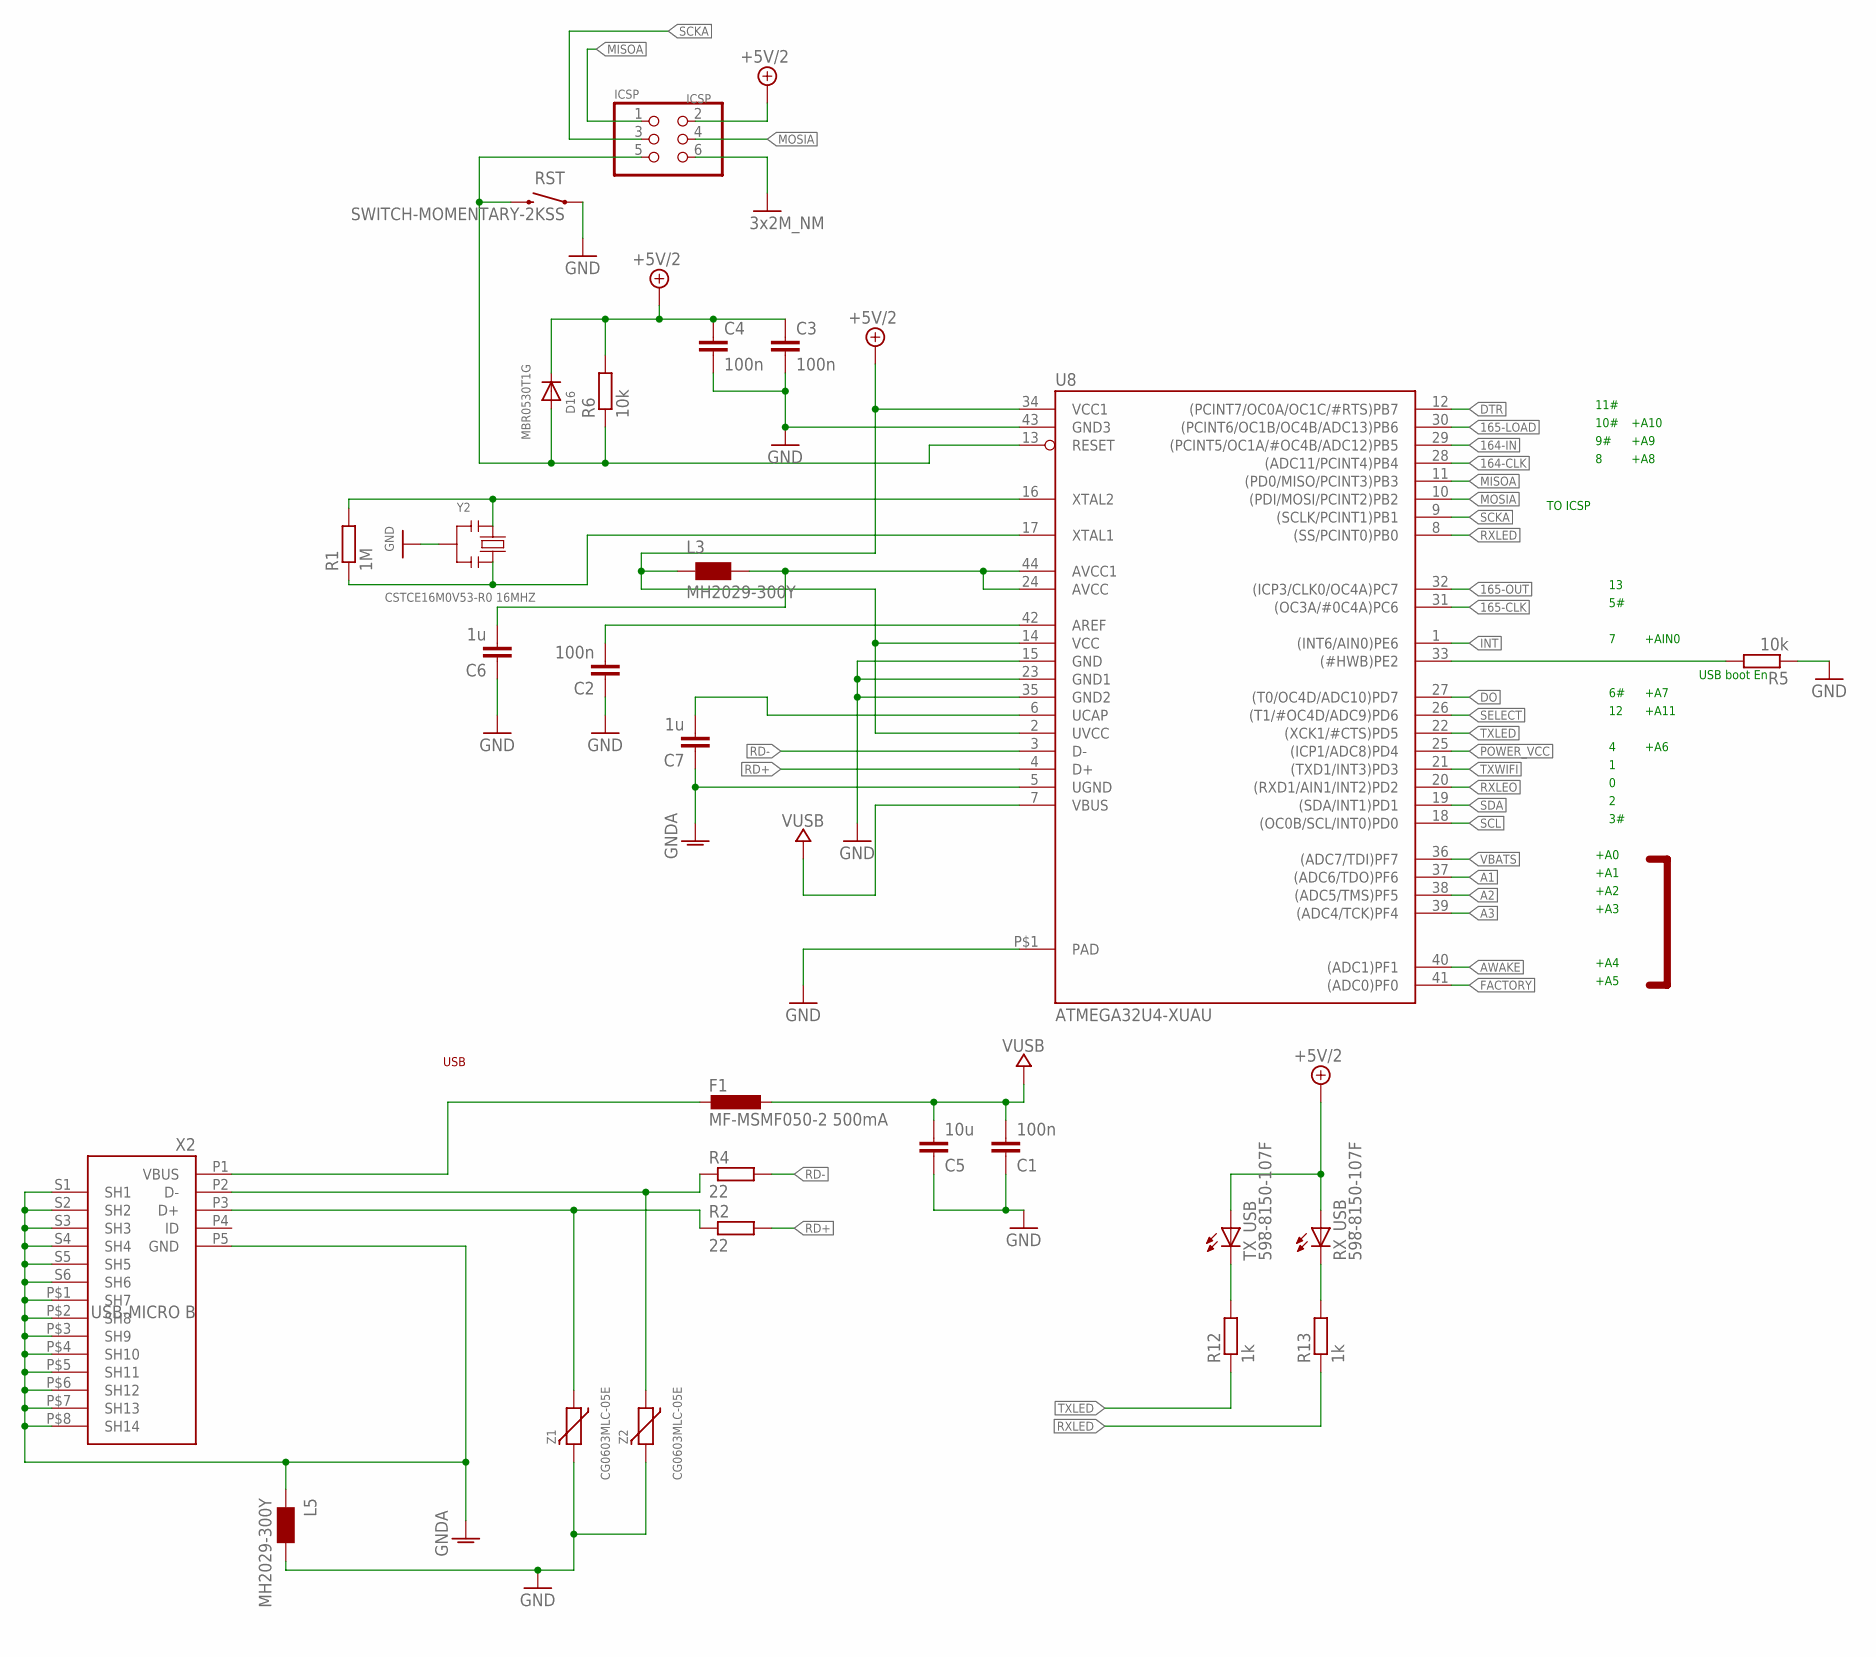
[picture p18: schematic Bhoreal Slimpro.sch, sheet 2]

Parts:
C1, C2, C3, C4: 100n; C0603
C5: 10u; C0805
C6, C7: 1u; C0805
D16: MBR0530T1G; SOD123
F1: MF-MSMF050-2 500mA; L1812
ICSP: ICSP; 2X03
L3, L5: MH2029-300Y; 0805
R1: 1M; R0603
R2, R4: 22; R0603
R5, R6: 10k; R0603
R12, R13: 1k; R0603
RST: SWITCH-MOMENTARY-2KSS; KSS241G
RX_USB: 598-8150-107F; CHIPLED_0805
TX_USB: 598-8150-107F; CHIPLED_0805
U8: ATMEGA32U4-XUAU; TQFP44-PAD
X2: USB-MICRO B; CON2_USB_MICRO_B_AT
Y2: CSTCE16M0V53-R0 16MHZ; RESONATOR
Z1, Z2: CG0603MLC-05E; CT/CN0603

Connections:
164-CLK: U8.28 ((ADC11/PCINT4)PB4); also elsewhere on the board
164-IN: U8.29 ((PCINT5/OC1A/#OC4B/ADC12)PB5); also elsewhere on the board
165-CLK: U8.31 ((OC3A/#0C4A)PC6); also elsewhere on the board
165-LOAD: U8.30 ((PCINT6/OC1B/OC4B/ADC13)PB6); also elsewhere on the board
165-OUT: U8.32 ((ICP3/CLK0/OC4A)PC7); also elsewhere on the board
+5V/2: C3.1, C4.1, D16.C, ICSP.2, L3.1, R6.2, RX_USB.A, TX_USB.A, U8.2 (UVCC), U8.14 (VCC), U8.34 (VCC1); also elsewhere on the board
A1: U8.37 ((ADC6/TDO)PF6)
A2: U8.38 ((ADC5/TMS)PF5)
A3: U8.39 ((ADC4/TCK)PF4)
AREF: C2.2, U8.42 (AREF)
AVCC: C6.2, L3.2, U8.24 (AVCC), U8.44 (AVCC1)
AWAKE: U8.40 ((ADC1)PF1); also elsewhere on the board
D+: R2.1, X2.P3 (D+), Z1.1
D-: R4.1, X2.P2 (D-), Z2.1
DO: U8.27 ((T0/OC4D/ADC10)PD7); also elsewhere on the board
DTR: U8.12 ((PCINT7/OC0A/OC1C/#RTS)PB7); also elsewhere on the board
FACTORY: U8.41 ((ADC0)PF0); also elsewhere on the board
GND: C1.1, C2.1, C3.2, C4.2, C5.1, C6.1, ICSP.6, L5.2, R5.1, RST.1, U8.15 (GND), U8.23 (GND1), U8.35 (GND2), U8.43 (GND3), U8.P$1 (PAD), Y2.2, Z1.2, Z2.2; also elsewhere on the board
GNDA: C7.1, L5.1, U8.5 (UGND), X2.P5 (GND), X2.P$1 (SH7), X2.P$2 (SH8), X2.P$3 (SH9), X2.P$4 (SH10), X2.P$5 (SH11), X2.P$6 (SH12), X2.P$7 (SH13), X2.P$8 (SH14), X2.S1 (SH1), X2.S2 (SH2), X2.S3 (SH3), X2.S4 (SH4), X2.S5 (SH5), X2.S6 (SH6); also elsewhere on the board
HWB: R5.2, U8.33 ((#HWB)PE2)
INT: U8.1 ((INT6/AIN0)PE6); also elsewhere on the board
MISOA: ICSP.1, U8.11 ((PD0/MISO/PCINT3)PB3)
MOSIA: ICSP.4, U8.10 ((PDI/MOSI/PCINT2)PB2)
unnamed: R12.2, TX_USB.C
unnamed: R13.2, RX_USB.C
POWER_VCC: U8.25 ((ICP1/ADC8)PD4); also elsewhere on the board
RD+: R2.2, U8.4 (D+)
RD-: R4.2, U8.3 (D-)
RST: D16.A, ICSP.5, R6.1, RST.2, U8.13 (RESET); also elsewhere on the board
RXLED: R13.1, U8.8 ((SS/PCINT0)PB0)
RXLEO: U8.20 ((RXD1/AIN1/INT2)PD2); also elsewhere on the board
SCKA: ICSP.3, U8.9 ((SCLK/PCINT1)PB1)
SCL: U8.18 ((OC0B/SCL/INT0)PD0); also elsewhere on the board
SDA: U8.19 ((SDA/INT1)PD1); also elsewhere on the board
SELECT: U8.26 ((T1/#OC4D/ADC9)PD6); also elsewhere on the board
TXLED: R12.1, U8.22 ((XCK1/#CTS)PD5)
TXWIFI: U8.21 ((TXD1/INT3)PD3); also elsewhere on the board
UCAP: C7.2, U8.6 (UCAP)
VBATS: U8.36 ((ADC7/TDI)PF7); also elsewhere on the board
VUSB: C1.2, C5.2, F1.1, U8.7 (VBUS); also elsewhere on the board
XTAL3: R1.2, U8.16 (XTAL2), Y2.1
XTAL4: R1.1, U8.17 (XTAL1), Y2.3
XUSB: F1.2, X2.P1 (VBUS)

Notes on the sheet:
USB boot En
USB
TO ICSP
10#
11#
+A6
+A11
+A10
+A9
+A7
+A8
+AIN0
+A0
+A1
+A2
+A3
+A4
+A5

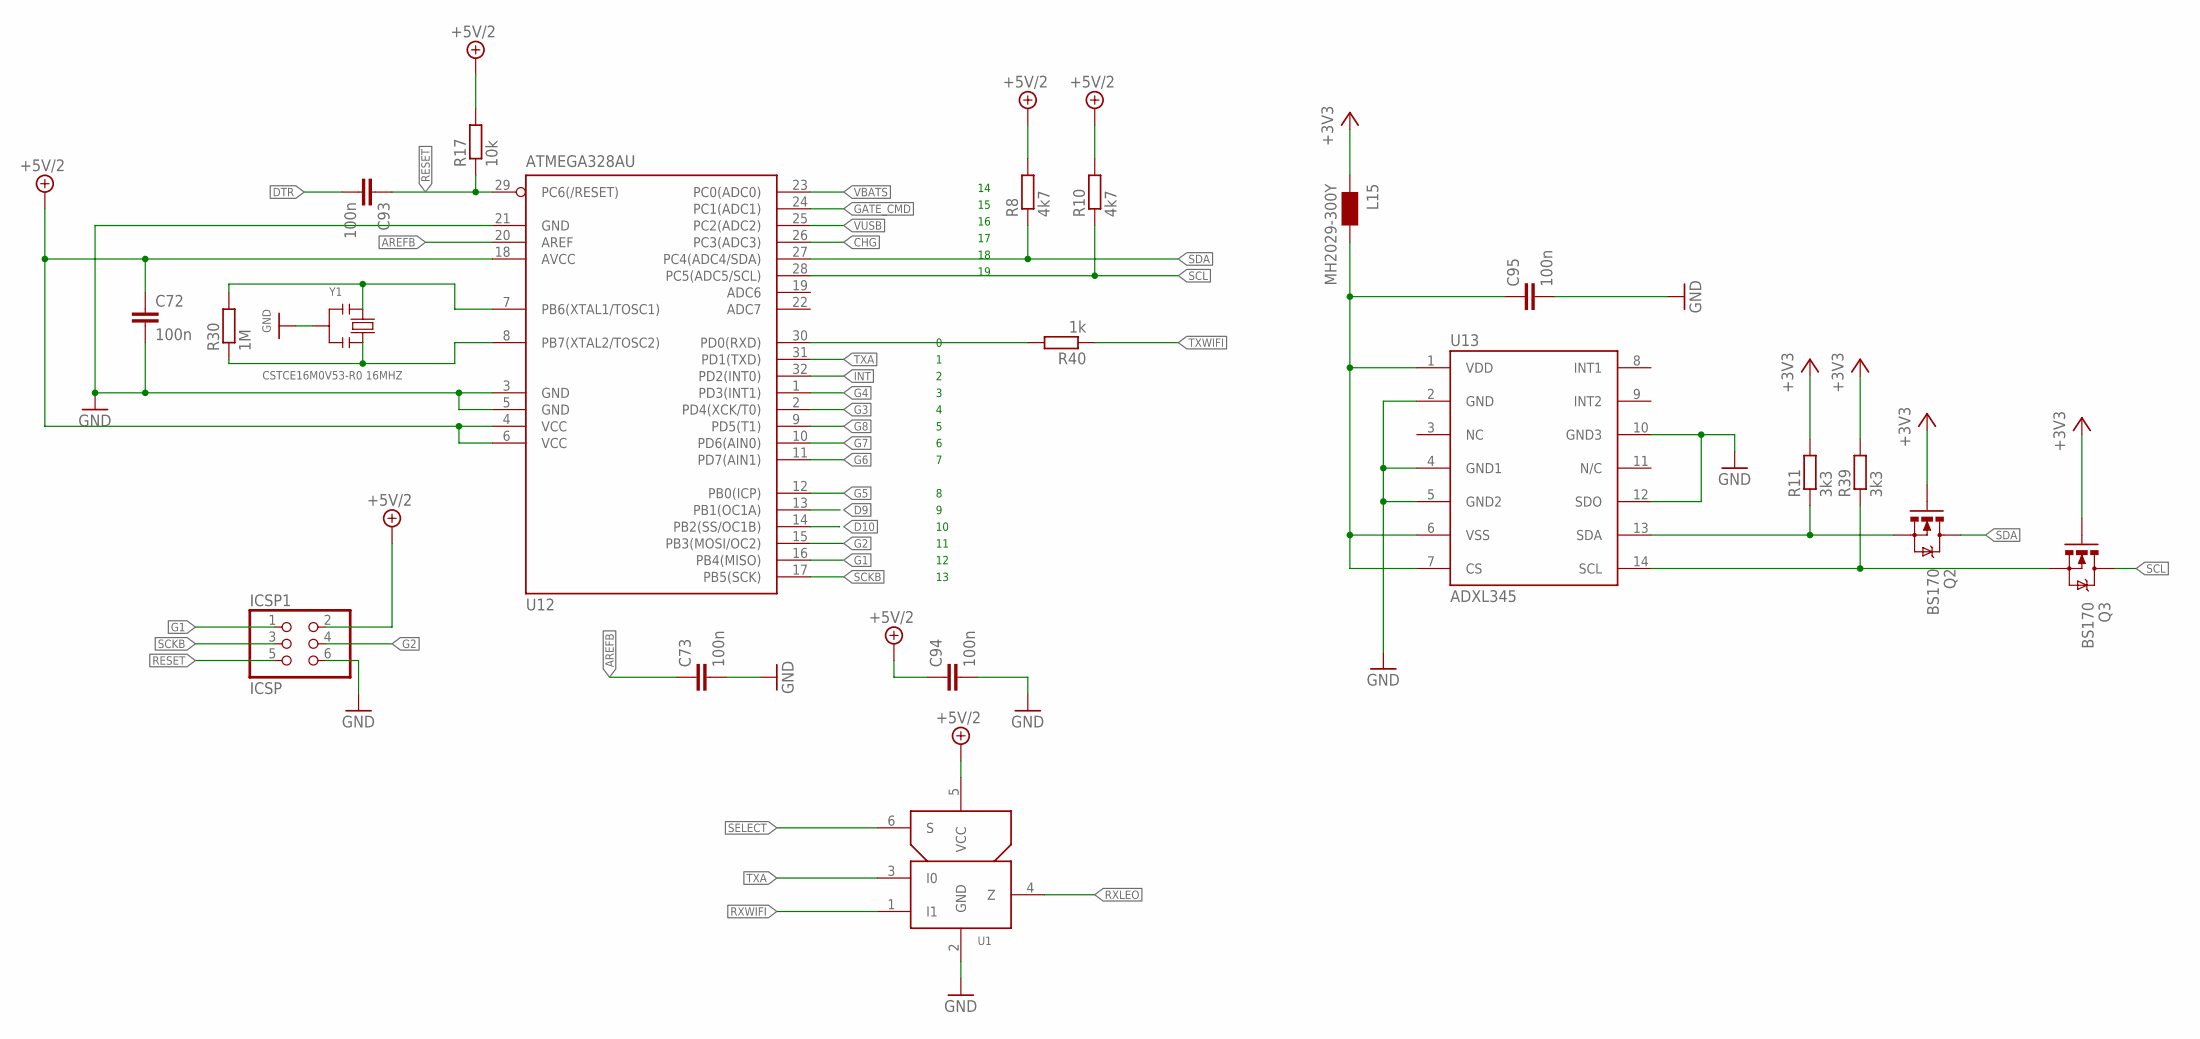
[picture p19: schematic Bhoreal Slimpro.sch, sheet 3]

Parts:
C72, C73, C93, C94, C95: 100n; C0603
ICSP1: ICSP; 2X03
L15: MH2029-300Y; 0805
Q2, Q3: BS170; SOT23
R8, R10: 4k7; R0603
R11, R39: 3k3; R0603
R17: 10k; R0603
R30: 1M; R0603
R40: 1k; R0603
U1: NC7SZ157P6X; SC70
U12: ATMEGA328AU; TQFP32-08
U13: ADXL345; LGA14
Y1: CSTCE16M0V53-R0 16MHZ; RESONATOR

Connections:
+3V3: L15.1, Q2.1 (G), Q3.1 (G), R11.2, R39.2; also elsewhere on the board
+5V/2: C72.1, C94.1, ICSP1.2, R8.2, R10.2, R17.2, U1.5 (VCC), U12.4 (VCC), U12.6 (VCC), U12.18 (AVCC); also elsewhere on the board
AREFB: C73.1, U12.20 (AREF)
CHG: U12.26 (PC3(ADC3)); also elsewhere on the board
D9: U12.13 (PB1(OC1A))
D10: U12.14 (PB2(SS/OC1B))
DTR: C93.2; also elsewhere on the board
G1: ICSP1.1, U12.16 (PB4(MISO)); also elsewhere on the board
G2: ICSP1.4, U12.15 (PB3(MOSI/OC2)); also elsewhere on the board
G3: U12.2 (PD4(XCK/T0)); also elsewhere on the board
G4: U12.1 (PD3(INT1)); also elsewhere on the board
G5: U12.12 (PB0(ICP)); also elsewhere on the board
G6: U12.11 (PD7(AIN1)); also elsewhere on the board
G7: U12.10 (PD6(AIN0)); also elsewhere on the board
G8: U12.9 (PD5(T1)); also elsewhere on the board
GATE_CMD: U12.24 (PC1(ADC1)); also elsewhere on the board
GND: C72.2, C73.2, C94.2, C95.2, ICSP1.6, U1.2 (GND), U12.3 (GND), U12.5 (GND), U12.21 (GND), U13.2 (GND), U13.4 (GND1), U13.5 (GND2), U13.10 (GND3), U13.12 (SDO), Y1.2; also elsewhere on the board
INT: U12.32 (PD2(INT0)); also elsewhere on the board
unnamed: C95.1, L15.2, U13.1 (VDD), U13.6 (VSS), U13.7 (CS)
unnamed: Q2.2 (S), R11.1, U13.13 (SDA)
unnamed: Q3.2 (S), R39.1, U13.14 (SCL)
RESET: C93.1, ICSP1.5, R17.1, U12.29 (PC6(/RESET))
RXA: R40.2, U12.30 (PD0(RXD))
RXLEO: U1.4 (Z); also elsewhere on the board
RXWIFI: U1.1 (I1); also elsewhere on the board
SCKB: ICSP1.3, U12.17 (PB5(SCK))
SCL: Q3.3 (D), R10.1, U12.28 (PC5(ADC5/SCL)); also elsewhere on the board
SDA: Q2.3 (D), R8.1, U12.27 (PC4(ADC4/SDA)); also elsewhere on the board
SELECT: U1.6 (S); also elsewhere on the board
TXA: U1.3 (I0), U12.31 (PD1(TXD))
TXWIFI: R40.1; also elsewhere on the board
VBATS: U12.23 (PC0(ADC0)); also elsewhere on the board
VUSB: U12.25 (PC2(ADC2)); also elsewhere on the board
XTAL1: R30.2, U12.7 (PB6(XTAL1/TOSC1)), Y1.1
XTAL2: R30.1, U12.8 (PB7(XTAL2/TOSC2)), Y1.3

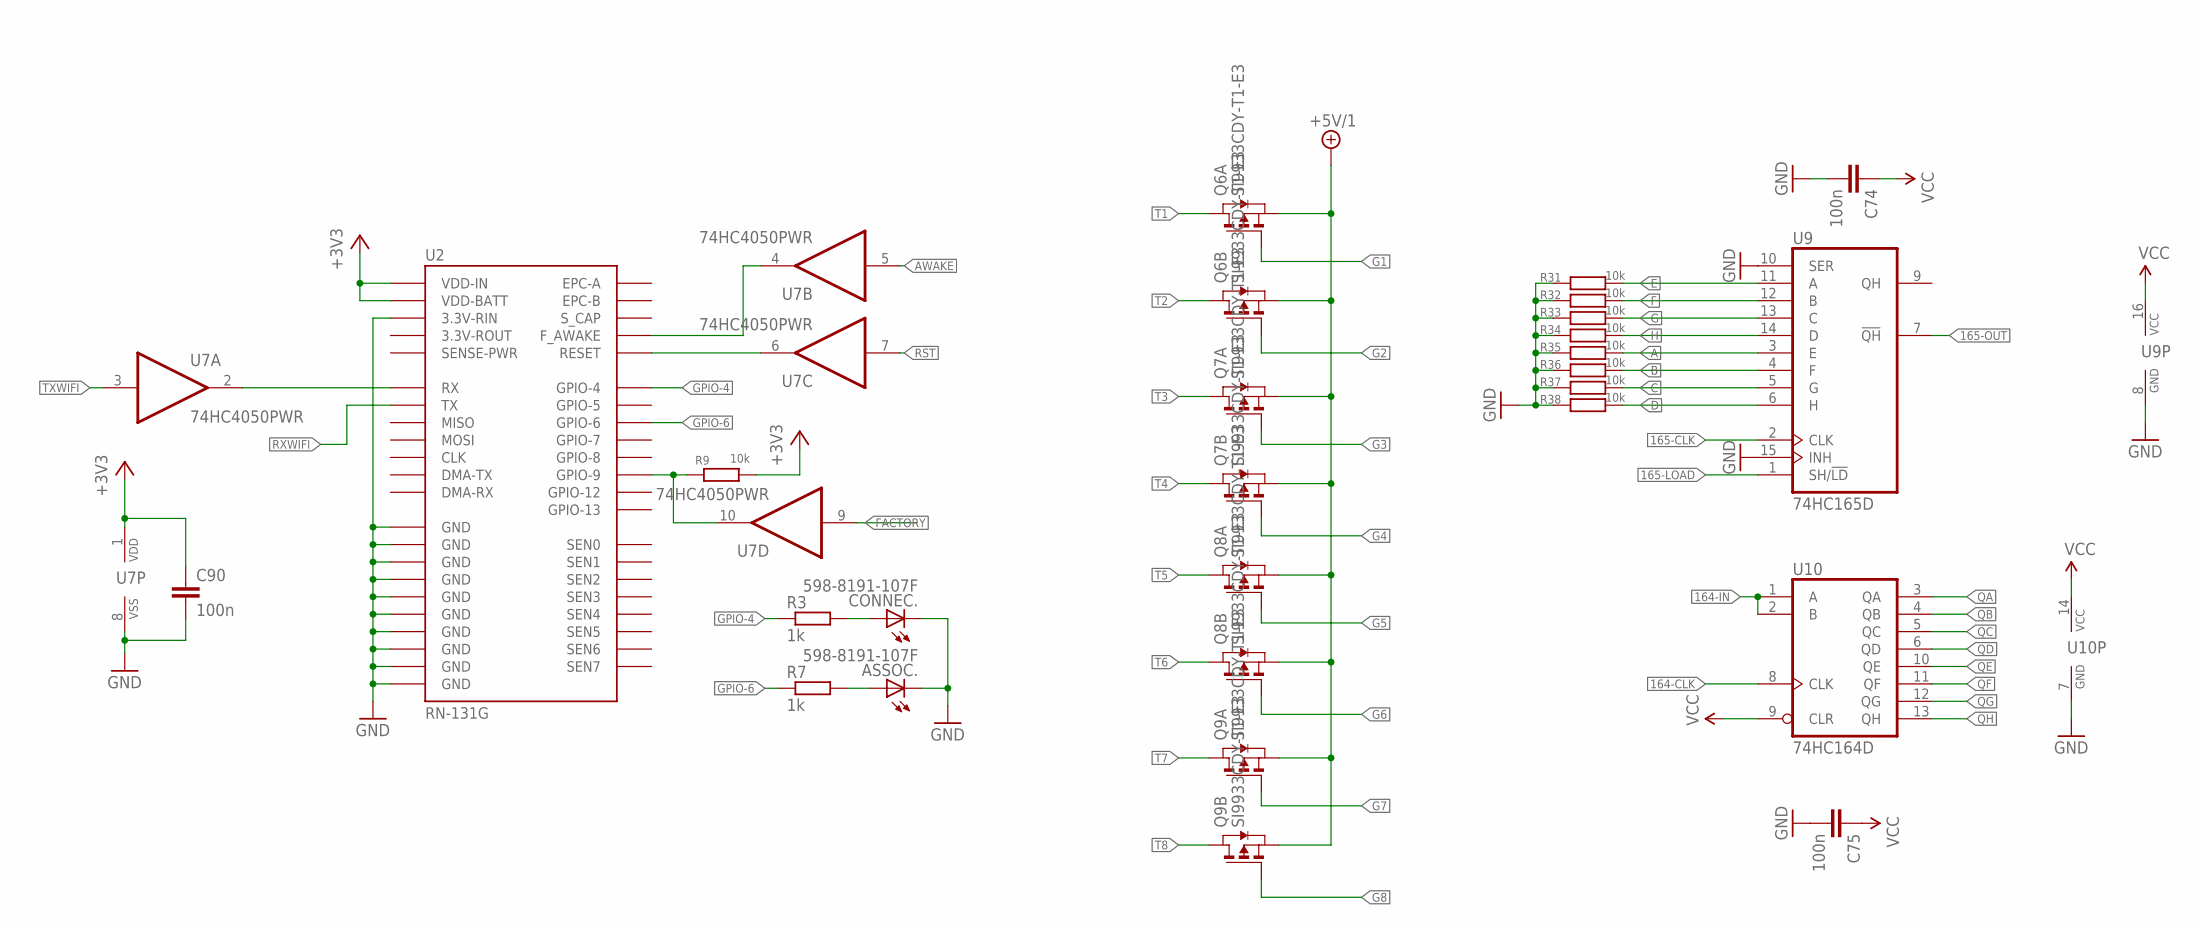
[picture p20: schematic Bhoreal Slimpro.sch, sheet 4]

Parts:
ASSOC.: 598-8191-107F; CHIP-LED0805
C74, C75, C90: 100n; C0603
CONNEC.: 598-8191-107F; CHIP-LED0805
Q6, Q7, Q8, Q9: SI9933CDY-T1-E3; SO8
R3, R7: 1k; R0603
R9, R31, R32, R33, R34, R35, R36, R37, R38: 10k; R0603
U2: RN-131G
U7: 74HC4050PWR; TSSOP16
U9: 74HC165D; SO16
U10: 74HC164D; SO14

Connections:
164-CLK: U10.8 (CLK); also elsewhere on the board
164-IN: U10.1 (A), U10.2 (B); also elsewhere on the board
165-CLK: U9.2 (CLK); also elsewhere on the board
165-LOAD: U9.1 (SH/!LD); also elsewhere on the board
165-OUT: U9.7 (!QH); also elsewhere on the board
+3V3: C90.1, R9.2, U2.P$20 (VDD-BATT), U2.P$21 (VDD-IN), U7.1 (VDD); also elsewhere on the board
+5V/1: Q6.1 (S), Q6.3 (S), Q7.1 (S), Q7.3 (S), Q8.1 (S), Q8.3 (S), Q9.1 (S), Q9.3 (S); also elsewhere on the board
A: R35.2, U9.3 (E); also elsewhere on the board
AWAKE: U7.5 (I); also elsewhere on the board
B: R36.2, U9.4 (F); also elsewhere on the board
C: R37.2, U9.5 (G); also elsewhere on the board
D: R38.2, U9.6 (H); also elsewhere on the board
E: R31.2, U9.11 (A); also elsewhere on the board
F: R32.2, U9.12 (B); also elsewhere on the board
FACTORY: U7.9 (I); also elsewhere on the board
G: R33.2, U9.13 (C); also elsewhere on the board
G1: Q6.2 (G); also elsewhere on the board
G2: Q6.4 (G); also elsewhere on the board
G3: Q7.2 (G); also elsewhere on the board
G4: Q7.4 (G); also elsewhere on the board
G5: Q8.2 (G); also elsewhere on the board
G6: Q8.4 (G); also elsewhere on the board
G7: Q9.2 (G); also elsewhere on the board
G8: Q9.4 (G); also elsewhere on the board
GND: ASSOC..C, C74.2, C75.2, C90.2, CONNEC..C, R31.1, R32.1, R33.1, R34.1, R35.1, R36.1, R37.1, R38.1, U2.P$18 (3.3V-RIN), U2.P$19 (GND), U2.P$36 (GND), U2.P$37 (GND), U2.P$38 (GND), U2.P$39 (GND), U2.P$40 (GND), U2.P$41 (GND), U2.P$42 (GND), U2.P$43 (GND), U2.P$44 (GND), U7.8 (VSS), U9.8 (GND), U9.10 (SER), U9.15 (INH), U10.7 (GND); also elsewhere on the board
GPIO-4: R3.1, U2.P$29 (GPIO-4)
GPIO-6: R7.1, U2.P$27 (GPIO-6)
H: R34.2, U9.14 (D); also elsewhere on the board
unnamed: CONNEC..A, R3.2
unnamed: ASSOC..A, R7.2
unnamed: U2.P$12 (RX), U7.2 (O)
unnamed: R9.1, U2.P$24 (GPIO-9), U7.10 (O)
unnamed: U2.P$9 (F_AWAKE), U7.4 (O)
unnamed: U2.P$5 (RESET), U7.6 (O)
QA: U10.3 (QA); also elsewhere on the board
QB: U10.4 (QB); also elsewhere on the board
QC: U10.5 (QC); also elsewhere on the board
QD: U10.6 (QD); also elsewhere on the board
QE: U10.10 (QE); also elsewhere on the board
QF: U10.11 (QF); also elsewhere on the board
QG: U10.12 (QG); also elsewhere on the board
QH: U10.13 (QH); also elsewhere on the board
RST: U7.7 (I); also elsewhere on the board
RXWIFI: U2.P$13 (TX); also elsewhere on the board
T1: Q6.7 (D), Q6.8 (D); also elsewhere on the board
T2: Q6.5 (D), Q6.6 (D); also elsewhere on the board
T3: Q7.7 (D), Q7.8 (D); also elsewhere on the board
T4: Q7.5 (D), Q7.6 (D); also elsewhere on the board
T5: Q8.7 (D), Q8.8 (D); also elsewhere on the board
T6: Q8.5 (D), Q8.6 (D); also elsewhere on the board
T7: Q9.7 (D), Q9.8 (D); also elsewhere on the board
T8: Q9.5 (D), Q9.6 (D); also elsewhere on the board
TXWIFI: U7.3 (I); also elsewhere on the board
VCC: C74.1, C75.1, U9.16 (VCC), U10.9 (CLR), U10.14 (VCC); also elsewhere on the board

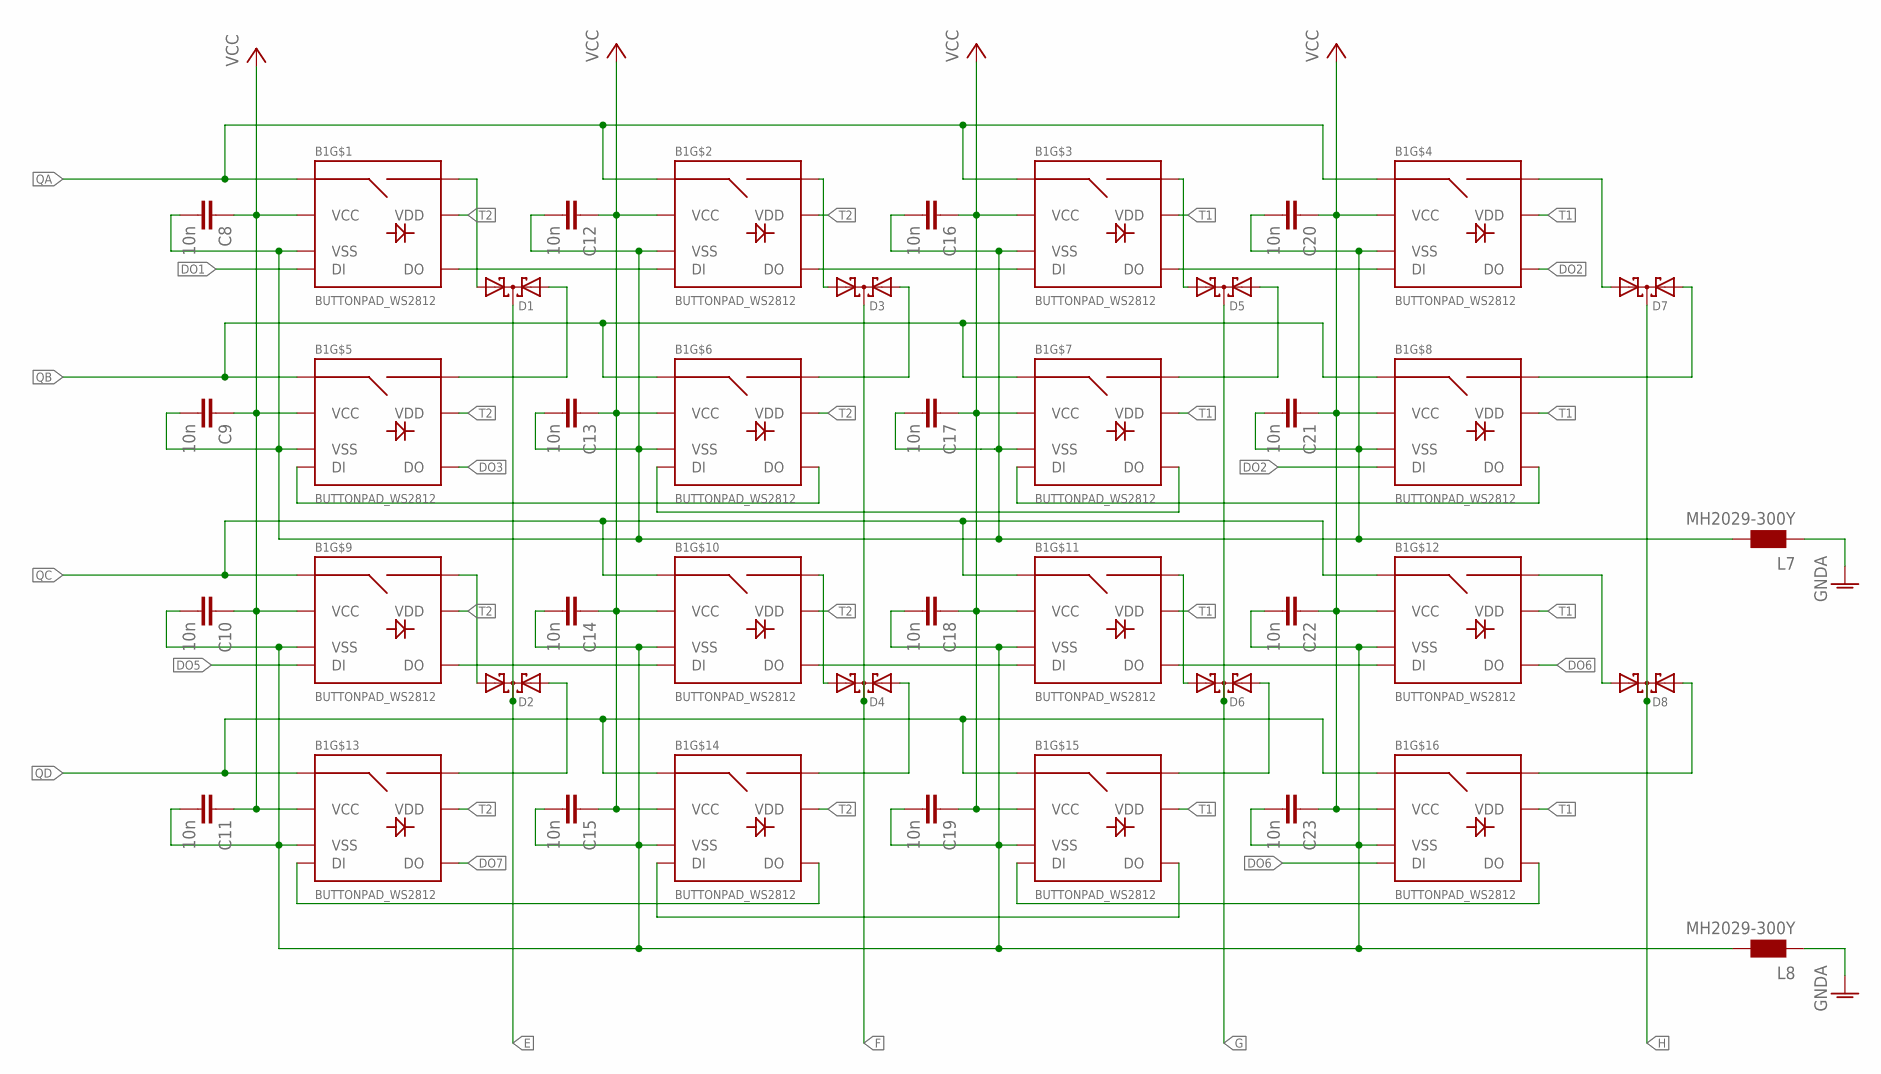
[picture p21: schematic Bhoreal Slimpro.sch, sheet 5]

Parts:
B1: BUTTONPAD_WS2812
C8, C9, C10, C11, C12, C13, C14, C15, C16, C17, C18, C19, C20, C21, C22, C23: 10n; C0603
D1, D2, D3, D4, D5, D6, D7, D8: BAV70LT3G; SOT23
L7, L8: MH2029-300Y; 0805

Connections:
DO1: B1.2A (DI); also elsewhere on the board
DO2: B1.1D (DO), B1.2H (DI)
DO3: B1.1E (DO); also elsewhere on the board
DO5: B1.2I (DI); also elsewhere on the board
DO6: B1.1L (DO), B1.2P (DI)
DO7: B1.1M (DO); also elsewhere on the board
E: D1.3 (C), D2.3 (C); also elsewhere on the board
F: D3.3 (C), D4.3 (C); also elsewhere on the board
G: D5.3 (C), D6.3 (C); also elsewhere on the board
GNDA: L7.1, L8.1; also elsewhere on the board
H: D7.3 (C), D8.3 (C); also elsewhere on the board
unnamed: B1.SIG2A (SIG2), D1.1 (A1)
unnamed: B1.SIG2E (SIG2), D1.2 (A2)
unnamed: B1.SIG2I (SIG2), D2.1 (A1)
unnamed: B1.SIG2M (SIG2), D2.2 (A2)
unnamed: B1.SIG2B (SIG2), D3.1 (A1)
unnamed: B1.SIG2F (SIG2), D3.2 (A2)
unnamed: B1.SIG2J (SIG2), D4.1 (A1)
unnamed: B1.SIG2N (SIG2), D4.2 (A2)
unnamed: B1.SIG2C (SIG2), D5.1 (A1)
unnamed: B1.SIG2G (SIG2), D5.2 (A2)
unnamed: B1.SIG2K (SIG2), D6.1 (A1)
unnamed: B1.SIG2O (SIG2), D6.2 (A2)
unnamed: B1.SIG2L (SIG2), D8.1 (A1)
unnamed: B1.SIG2P (SIG2), D8.2 (A2)
unnamed: B1.SIG2D (SIG2), D7.1 (A1)
unnamed: B1.SIG2H (SIG2), D7.2 (A2)
unnamed: B1.1A (DO), B1.2B (DI)
unnamed: B1.1F (DO), B1.2E (DI)
unnamed: B1.1G (DO), B1.2F (DI)
unnamed: B1.1B (DO), B1.2C (DI)
unnamed: B1.1C (DO), B1.2D (DI)
unnamed: B1.1H (DO), B1.2G (DI)
unnamed: B1.1K (DO), B1.2L (DI)
unnamed: B1.1J (DO), B1.2K (DI)
unnamed: B1.1I (DO), B1.2J (DI)
unnamed: B1.1P (DO), B1.2O (DI)
unnamed: B1.1O (DO), B1.2N (DI)
unnamed: B1.1N (DO), B1.2M (DI)
unnamed: B1.6A (VSS), B1.6B (VSS), B1.6C (VSS), B1.6D (VSS), B1.6E (VSS), B1.6F (VSS), B1.6G (VSS), B1.6H (VSS), C8.2, C9.2, C12.2, C13.2, C16.2, C17.2, C20.2, C21.2, L7.2
unnamed: B1.6I (VSS), B1.6J (VSS), B1.6K (VSS), B1.6L (VSS), B1.6M (VSS), B1.6N (VSS), B1.6O (VSS), B1.6P (VSS), C10.2, C11.2, C14.2, C15.2, C18.2, C19.2, C22.2, C23.2, L8.2
QA: B1.SIG1A (SIG1), B1.SIG1B (SIG1), B1.SIG1C (SIG1), B1.SIG1D (SIG1); also elsewhere on the board
QB: B1.SIG1E (SIG1), B1.SIG1F (SIG1), B1.SIG1G (SIG1), B1.SIG1H (SIG1); also elsewhere on the board
QC: B1.SIG1I (SIG1), B1.SIG1J (SIG1), B1.SIG1K (SIG1), B1.SIG1L (SIG1); also elsewhere on the board
QD: B1.SIG1M (SIG1), B1.SIG1N (SIG1), B1.SIG1O (SIG1), B1.SIG1P (SIG1); also elsewhere on the board
T1: B1.5C (VDD), B1.5D (VDD), B1.5G (VDD), B1.5H (VDD), B1.5K (VDD), B1.5L (VDD), B1.5O (VDD), B1.5P (VDD); also elsewhere on the board
T2: B1.5A (VDD), B1.5B (VDD), B1.5E (VDD), B1.5F (VDD), B1.5I (VDD), B1.5J (VDD), B1.5M (VDD), B1.5N (VDD); also elsewhere on the board
VCC: B1.3A (VCC), B1.3B (VCC), B1.3C (VCC), B1.3D (VCC), B1.3E (VCC), B1.3F (VCC), B1.3G (VCC), B1.3H (VCC), B1.3I (VCC), B1.3J (VCC), B1.3K (VCC), B1.3L (VCC), B1.3M (VCC), B1.3N (VCC), B1.3O (VCC), B1.3P (VCC), C8.1, C9.1, C10.1, C11.1, C12.1, C13.1, C14.1, C15.1, C16.1, C17.1, C18.1, C19.1, C20.1, C21.1, C22.1, C23.1; also elsewhere on the board
