bhoreal/bhoreal/hardware/Bhoreal Slim Pro Schematics/Bhoreal Slimpro.brd

## EAGLE design hardware/Bhoreal Slim Pro Schematics/Bhoreal Slimpro.brd (continued)

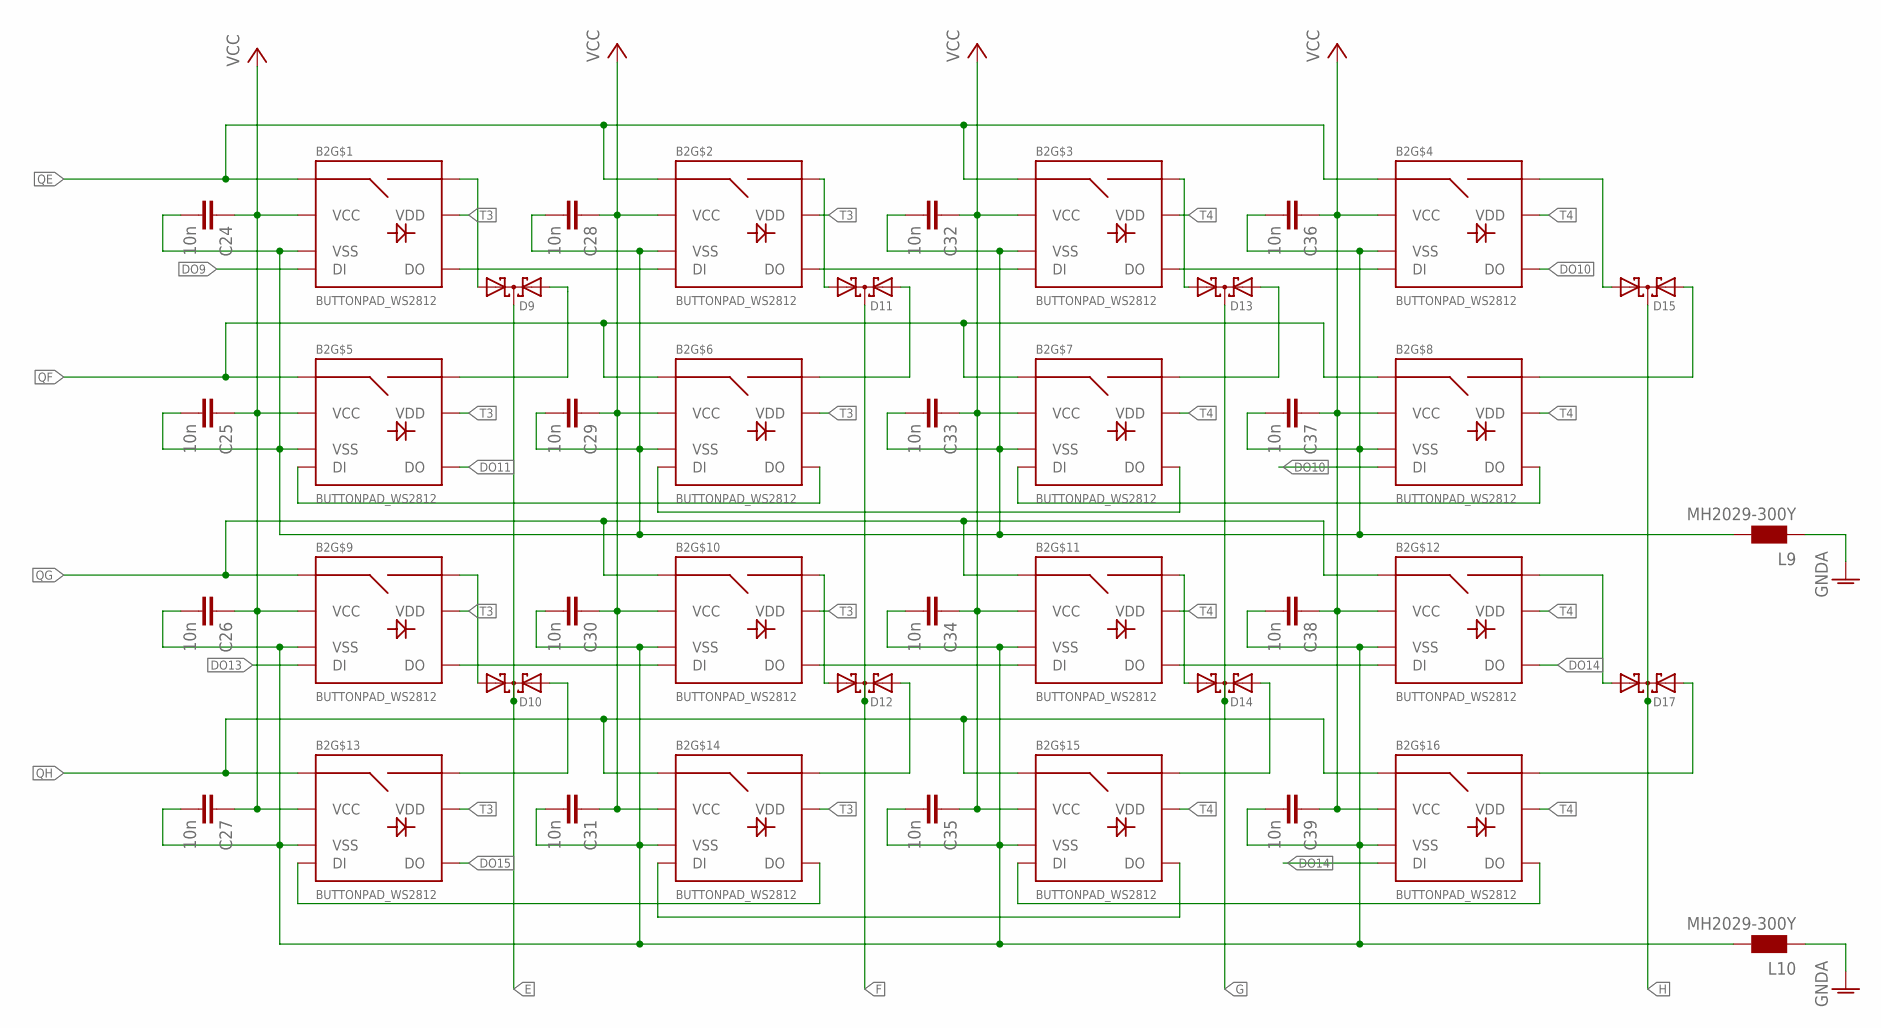
[picture p22: schematic Bhoreal Slimpro.sch, sheet 6]

Parts:
B2: BUTTONPAD_WS2812
C24, C25, C26, C27, C28, C29, C30, C31, C32, C33, C34, C35, C36, C37, C38, C39: 10n; C0603
D9, D10, D11, D12, D13, D14, D15, D17: BAV70LT3G; SOT23
L9, L10: MH2029-300Y; 0805

Connections:
DO9: B2.2A (DI); also elsewhere on the board
DO10: B2.1D (DO), B2.2H (DI)
DO11: B2.1E (DO); also elsewhere on the board
DO13: B2.2I (DI); also elsewhere on the board
DO14: B2.1L (DO), B2.2P (DI)
DO15: B2.1M (DO); also elsewhere on the board
E: D9.3 (C), D10.3 (C); also elsewhere on the board
F: D11.3 (C), D12.3 (C); also elsewhere on the board
G: D13.3 (C), D14.3 (C); also elsewhere on the board
GNDA: L9.1, L10.1; also elsewhere on the board
H: D15.3 (C), D17.3 (C); also elsewhere on the board
unnamed: B2.1A (DO), B2.2B (DI)
unnamed: B2.1B (DO), B2.2C (DI)
unnamed: B2.1C (DO), B2.2D (DI)
unnamed: B2.1K (DO), B2.2L (DI)
unnamed: B2.1J (DO), B2.2K (DI)
unnamed: B2.1I (DO), B2.2J (DI)
unnamed: B2.1F (DO), B2.2E (DI)
unnamed: B2.1G (DO), B2.2F (DI)
unnamed: B2.1H (DO), B2.2G (DI)
unnamed: B2.1P (DO), B2.2O (DI)
unnamed: B2.1O (DO), B2.2N (DI)
unnamed: B2.1N (DO), B2.2M (DI)
unnamed: B2.SIG2A (SIG2), D9.1 (A1)
unnamed: B2.SIG2E (SIG2), D9.2 (A2)
unnamed: B2.SIG2I (SIG2), D10.1 (A1)
unnamed: B2.SIG2M (SIG2), D10.2 (A2)
unnamed: B2.SIG2B (SIG2), D11.1 (A1)
unnamed: B2.SIG2F (SIG2), D11.2 (A2)
unnamed: B2.SIG2J (SIG2), D12.1 (A1)
unnamed: B2.SIG2N (SIG2), D12.2 (A2)
unnamed: B2.SIG2C (SIG2), D13.1 (A1)
unnamed: B2.SIG2G (SIG2), D13.2 (A2)
unnamed: B2.SIG2K (SIG2), D14.1 (A1)
unnamed: B2.SIG2O (SIG2), D14.2 (A2)
unnamed: B2.SIG2L (SIG2), D17.1 (A1)
unnamed: B2.SIG2P (SIG2), D17.2 (A2)
unnamed: B2.SIG2D (SIG2), D15.1 (A1)
unnamed: B2.SIG2H (SIG2), D15.2 (A2)
unnamed: B2.6I (VSS), B2.6J (VSS), B2.6K (VSS), B2.6L (VSS), B2.6M (VSS), B2.6N (VSS), B2.6O (VSS), B2.6P (VSS), C26.2, C27.2, C30.2, C31.2, C34.2, C35.2, C38.2, C39.2, L10.2
unnamed: B2.6A (VSS), B2.6B (VSS), B2.6C (VSS), B2.6D (VSS), B2.6E (VSS), B2.6F (VSS), B2.6G (VSS), B2.6H (VSS), C24.2, C25.2, C28.2, C29.2, C32.2, C33.2, C36.2, C37.2, L9.2
QE: B2.SIG1A (SIG1), B2.SIG1B (SIG1), B2.SIG1C (SIG1), B2.SIG1D (SIG1); also elsewhere on the board
QF: B2.SIG1E (SIG1), B2.SIG1F (SIG1), B2.SIG1G (SIG1), B2.SIG1H (SIG1); also elsewhere on the board
QG: B2.SIG1I (SIG1), B2.SIG1J (SIG1), B2.SIG1K (SIG1), B2.SIG1L (SIG1); also elsewhere on the board
QH: B2.SIG1M (SIG1), B2.SIG1N (SIG1), B2.SIG1O (SIG1), B2.SIG1P (SIG1); also elsewhere on the board
T3: B2.5A (VDD), B2.5B (VDD), B2.5E (VDD), B2.5F (VDD), B2.5I (VDD), B2.5J (VDD), B2.5M (VDD), B2.5N (VDD); also elsewhere on the board
T4: B2.5C (VDD), B2.5D (VDD), B2.5G (VDD), B2.5H (VDD), B2.5K (VDD), B2.5L (VDD), B2.5O (VDD), B2.5P (VDD); also elsewhere on the board
VCC: B2.3A (VCC), B2.3B (VCC), B2.3C (VCC), B2.3D (VCC), B2.3E (VCC), B2.3F (VCC), B2.3G (VCC), B2.3H (VCC), B2.3I (VCC), B2.3J (VCC), B2.3K (VCC), B2.3L (VCC), B2.3M (VCC), B2.3N (VCC), B2.3O (VCC), B2.3P (VCC), C24.1, C25.1, C26.1, C27.1, C28.1, C29.1, C30.1, C31.1, C32.1, C33.1, C34.1, C35.1, C36.1, C37.1, C38.1, C39.1; also elsewhere on the board

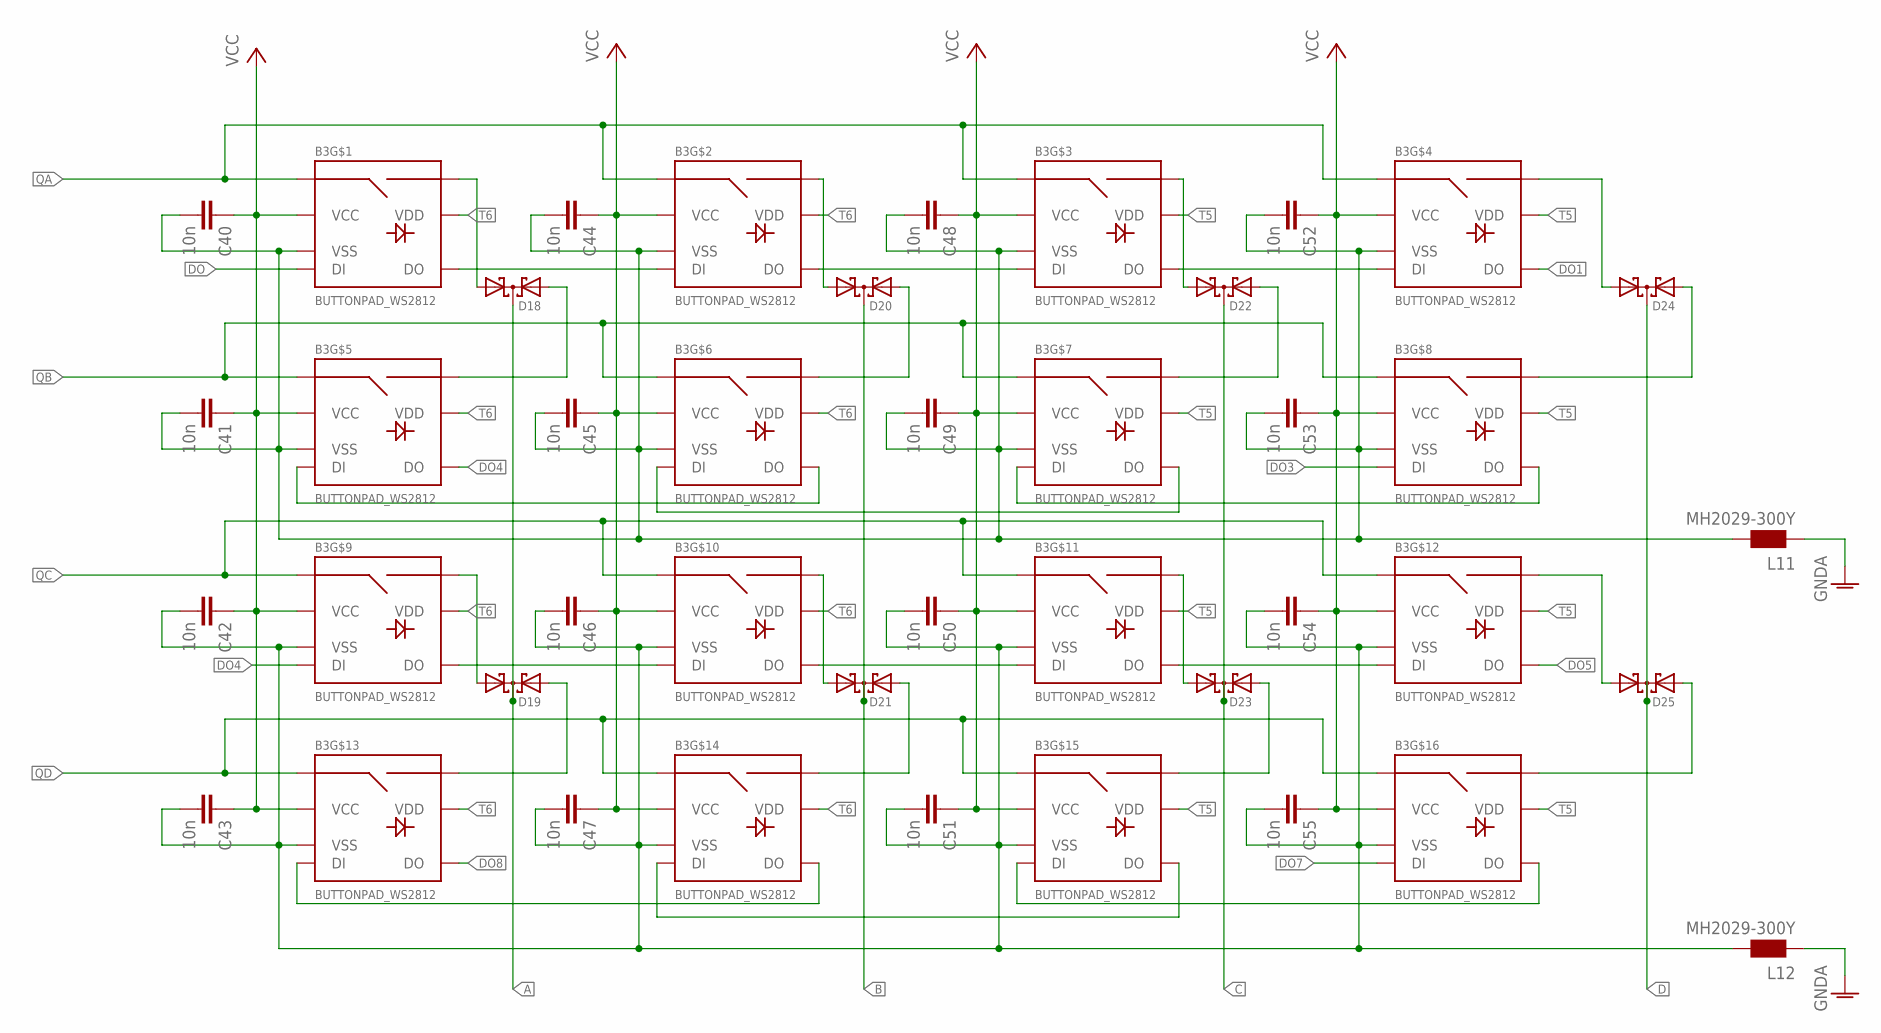
[picture p23: schematic Bhoreal Slimpro.sch, sheet 7]

Parts:
B3: BUTTONPAD_WS2812
C40, C41, C42, C43, C44, C45, C46, C47, C48, C49, C50, C51, C52, C53, C54, C55: 10n; C0603
D18, D19, D20, D21, D22, D23, D24, D25: BAV70LT3G; SOT23
L11, L12: MH2029-300Y; 0805

Connections:
A: D18.3 (C), D19.3 (C); also elsewhere on the board
B: D20.3 (C), D21.3 (C); also elsewhere on the board
C: D22.3 (C), D23.3 (C); also elsewhere on the board
D: D24.3 (C), D25.3 (C); also elsewhere on the board
DO: B3.2A (DI); also elsewhere on the board
DO1: B3.1D (DO); also elsewhere on the board
DO3: B3.2H (DI); also elsewhere on the board
DO4: B3.1E (DO), B3.2I (DI)
DO5: B3.1L (DO); also elsewhere on the board
DO7: B3.2P (DI); also elsewhere on the board
DO8: B3.1M (DO); also elsewhere on the board
GNDA: L11.1, L12.1; also elsewhere on the board
unnamed: B3.1A (DO), B3.2B (DI)
unnamed: B3.1B (DO), B3.2C (DI)
unnamed: B3.1C (DO), B3.2D (DI)
unnamed: B3.1K (DO), B3.2L (DI)
unnamed: B3.1J (DO), B3.2K (DI)
unnamed: B3.1I (DO), B3.2J (DI)
unnamed: B3.1F (DO), B3.2E (DI)
unnamed: B3.1G (DO), B3.2F (DI)
unnamed: B3.1H (DO), B3.2G (DI)
unnamed: B3.1P (DO), B3.2O (DI)
unnamed: B3.1O (DO), B3.2N (DI)
unnamed: B3.1N (DO), B3.2M (DI)
unnamed: B3.SIG2A (SIG2), D18.1 (A1)
unnamed: B3.SIG2E (SIG2), D18.2 (A2)
unnamed: B3.SIG2I (SIG2), D19.1 (A1)
unnamed: B3.SIG2M (SIG2), D19.2 (A2)
unnamed: B3.SIG2B (SIG2), D20.1 (A1)
unnamed: B3.SIG2F (SIG2), D20.2 (A2)
unnamed: B3.SIG2J (SIG2), D21.1 (A1)
unnamed: B3.SIG2N (SIG2), D21.2 (A2)
unnamed: B3.SIG2C (SIG2), D22.1 (A1)
unnamed: B3.SIG2G (SIG2), D22.2 (A2)
unnamed: B3.SIG2K (SIG2), D23.1 (A1)
unnamed: B3.SIG2O (SIG2), D23.2 (A2)
unnamed: B3.SIG2L (SIG2), D25.1 (A1)
unnamed: B3.SIG2P (SIG2), D25.2 (A2)
unnamed: B3.SIG2D (SIG2), D24.1 (A1)
unnamed: B3.SIG2H (SIG2), D24.2 (A2)
unnamed: B3.6A (VSS), B3.6B (VSS), B3.6C (VSS), B3.6D (VSS), B3.6E (VSS), B3.6F (VSS), B3.6G (VSS), B3.6H (VSS), C40.2, C41.2, C44.2, C45.2, C48.2, C49.2, C52.2, C53.2, L11.2
unnamed: B3.6I (VSS), B3.6J (VSS), B3.6K (VSS), B3.6L (VSS), B3.6M (VSS), B3.6N (VSS), B3.6O (VSS), B3.6P (VSS), C42.2, C43.2, C46.2, C47.2, C50.2, C51.2, C54.2, C55.2, L12.2
QA: B3.SIG1A (SIG1), B3.SIG1B (SIG1), B3.SIG1C (SIG1), B3.SIG1D (SIG1); also elsewhere on the board
QB: B3.SIG1E (SIG1), B3.SIG1F (SIG1), B3.SIG1G (SIG1), B3.SIG1H (SIG1); also elsewhere on the board
QC: B3.SIG1I (SIG1), B3.SIG1J (SIG1), B3.SIG1K (SIG1), B3.SIG1L (SIG1); also elsewhere on the board
QD: B3.SIG1M (SIG1), B3.SIG1N (SIG1), B3.SIG1O (SIG1), B3.SIG1P (SIG1); also elsewhere on the board
T5: B3.5C (VDD), B3.5D (VDD), B3.5G (VDD), B3.5H (VDD), B3.5K (VDD), B3.5L (VDD), B3.5O (VDD), B3.5P (VDD); also elsewhere on the board
T6: B3.5A (VDD), B3.5B (VDD), B3.5E (VDD), B3.5F (VDD), B3.5I (VDD), B3.5J (VDD), B3.5M (VDD), B3.5N (VDD); also elsewhere on the board
VCC: B3.3A (VCC), B3.3B (VCC), B3.3C (VCC), B3.3D (VCC), B3.3E (VCC), B3.3F (VCC), B3.3G (VCC), B3.3H (VCC), B3.3I (VCC), B3.3J (VCC), B3.3K (VCC), B3.3L (VCC), B3.3M (VCC), B3.3N (VCC), B3.3O (VCC), B3.3P (VCC), C40.1, C41.1, C42.1, C43.1, C44.1, C45.1, C46.1, C47.1, C48.1, C49.1, C50.1, C51.1, C52.1, C53.1, C54.1, C55.1; also elsewhere on the board

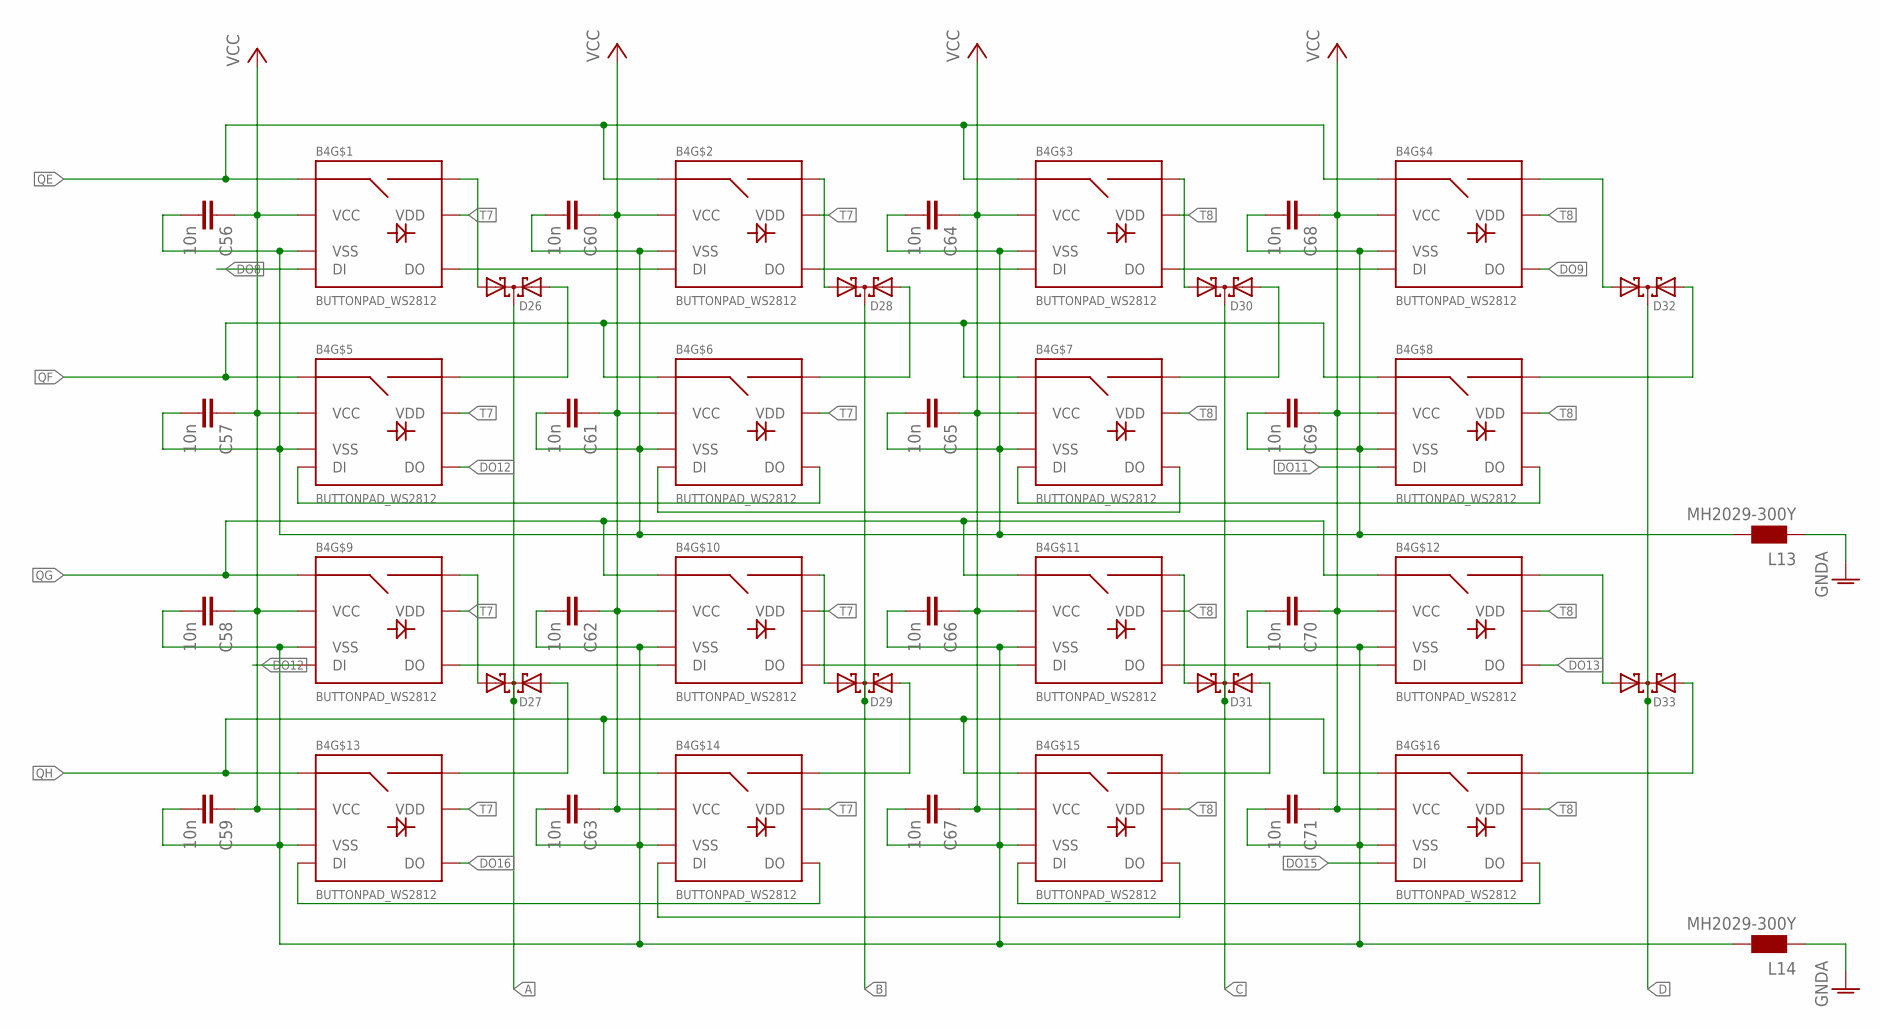
[picture p24: schematic Bhoreal Slimpro.sch, sheet 8]

Parts:
B4: BUTTONPAD_WS2812
C56, C57, C58, C59, C60, C61, C62, C63, C64, C65, C66, C67, C68, C69, C70, C71: 10n; C0603
D26, D27, D28, D29, D30, D31, D32, D33: BAV70LT3G; SOT23
L13, L14: MH2029-300Y; 0805

Connections:
A: D26.3 (C), D27.3 (C); also elsewhere on the board
B: D28.3 (C), D29.3 (C); also elsewhere on the board
C: D30.3 (C), D31.3 (C); also elsewhere on the board
D: D32.3 (C), D33.3 (C); also elsewhere on the board
DO8: B4.2A (DI); also elsewhere on the board
DO9: B4.1D (DO); also elsewhere on the board
DO11: B4.2H (DI); also elsewhere on the board
DO12: B4.1E (DO), B4.2I (DI)
DO13: B4.1L (DO); also elsewhere on the board
DO15: B4.2P (DI); also elsewhere on the board
DO16: B4.1M (DO)
GNDA: L13.1, L14.1; also elsewhere on the board
unnamed: B4.1A (DO), B4.2B (DI)
unnamed: B4.1B (DO), B4.2C (DI)
unnamed: B4.1C (DO), B4.2D (DI)
unnamed: B4.1K (DO), B4.2L (DI)
unnamed: B4.1J (DO), B4.2K (DI)
unnamed: B4.1I (DO), B4.2J (DI)
unnamed: B4.1F (DO), B4.2E (DI)
unnamed: B4.1G (DO), B4.2F (DI)
unnamed: B4.1H (DO), B4.2G (DI)
unnamed: B4.1P (DO), B4.2O (DI)
unnamed: B4.1O (DO), B4.2N (DI)
unnamed: B4.1N (DO), B4.2M (DI)
unnamed: B4.SIG2A (SIG2), D26.1 (A1)
unnamed: B4.SIG2E (SIG2), D26.2 (A2)
unnamed: B4.SIG2I (SIG2), D27.1 (A1)
unnamed: B4.SIG2M (SIG2), D27.2 (A2)
unnamed: B4.SIG2B (SIG2), D28.1 (A1)
unnamed: B4.SIG2F (SIG2), D28.2 (A2)
unnamed: B4.SIG2J (SIG2), D29.1 (A1)
unnamed: B4.SIG2N (SIG2), D29.2 (A2)
unnamed: B4.SIG2C (SIG2), D30.1 (A1)
unnamed: B4.SIG2G (SIG2), D30.2 (A2)
unnamed: B4.SIG2K (SIG2), D31.1 (A1)
unnamed: B4.SIG2O (SIG2), D31.2 (A2)
unnamed: B4.SIG2L (SIG2), D33.1 (A1)
unnamed: B4.SIG2P (SIG2), D33.2 (A2)
unnamed: B4.SIG2D (SIG2), D32.1 (A1)
unnamed: B4.SIG2H (SIG2), D32.2 (A2)
unnamed: B4.6I (VSS), B4.6J (VSS), B4.6K (VSS), B4.6L (VSS), B4.6M (VSS), B4.6N (VSS), B4.6O (VSS), B4.6P (VSS), C58.2, C59.2, C62.2, C63.2, C66.2, C67.2, C70.2, C71.2, L14.2
unnamed: B4.6A (VSS), B4.6B (VSS), B4.6C (VSS), B4.6D (VSS), B4.6E (VSS), B4.6F (VSS), B4.6G (VSS), B4.6H (VSS), C56.2, C57.2, C60.2, C61.2, C64.2, C65.2, C68.2, C69.2, L13.2
QE: B4.SIG1A (SIG1), B4.SIG1B (SIG1), B4.SIG1C (SIG1), B4.SIG1D (SIG1); also elsewhere on the board
QF: B4.SIG1E (SIG1), B4.SIG1F (SIG1), B4.SIG1G (SIG1), B4.SIG1H (SIG1); also elsewhere on the board
QG: B4.SIG1I (SIG1), B4.SIG1J (SIG1), B4.SIG1K (SIG1), B4.SIG1L (SIG1); also elsewhere on the board
QH: B4.SIG1M (SIG1), B4.SIG1N (SIG1), B4.SIG1O (SIG1), B4.SIG1P (SIG1); also elsewhere on the board
T7: B4.5A (VDD), B4.5B (VDD), B4.5E (VDD), B4.5F (VDD), B4.5I (VDD), B4.5J (VDD), B4.5M (VDD), B4.5N (VDD); also elsewhere on the board
T8: B4.5C (VDD), B4.5D (VDD), B4.5G (VDD), B4.5H (VDD), B4.5K (VDD), B4.5L (VDD), B4.5O (VDD), B4.5P (VDD); also elsewhere on the board
VCC: B4.3A (VCC), B4.3B (VCC), B4.3C (VCC), B4.3D (VCC), B4.3E (VCC), B4.3F (VCC), B4.3G (VCC), B4.3H (VCC), B4.3I (VCC), B4.3J (VCC), B4.3K (VCC), B4.3L (VCC), B4.3M (VCC), B4.3N (VCC), B4.3O (VCC), B4.3P (VCC), C56.1, C57.1, C58.1, C59.1, C60.1, C61.1, C62.1, C63.1, C64.1, C65.1, C66.1, C67.1, C68.1, C69.1, C70.1, C71.1; also elsewhere on the board

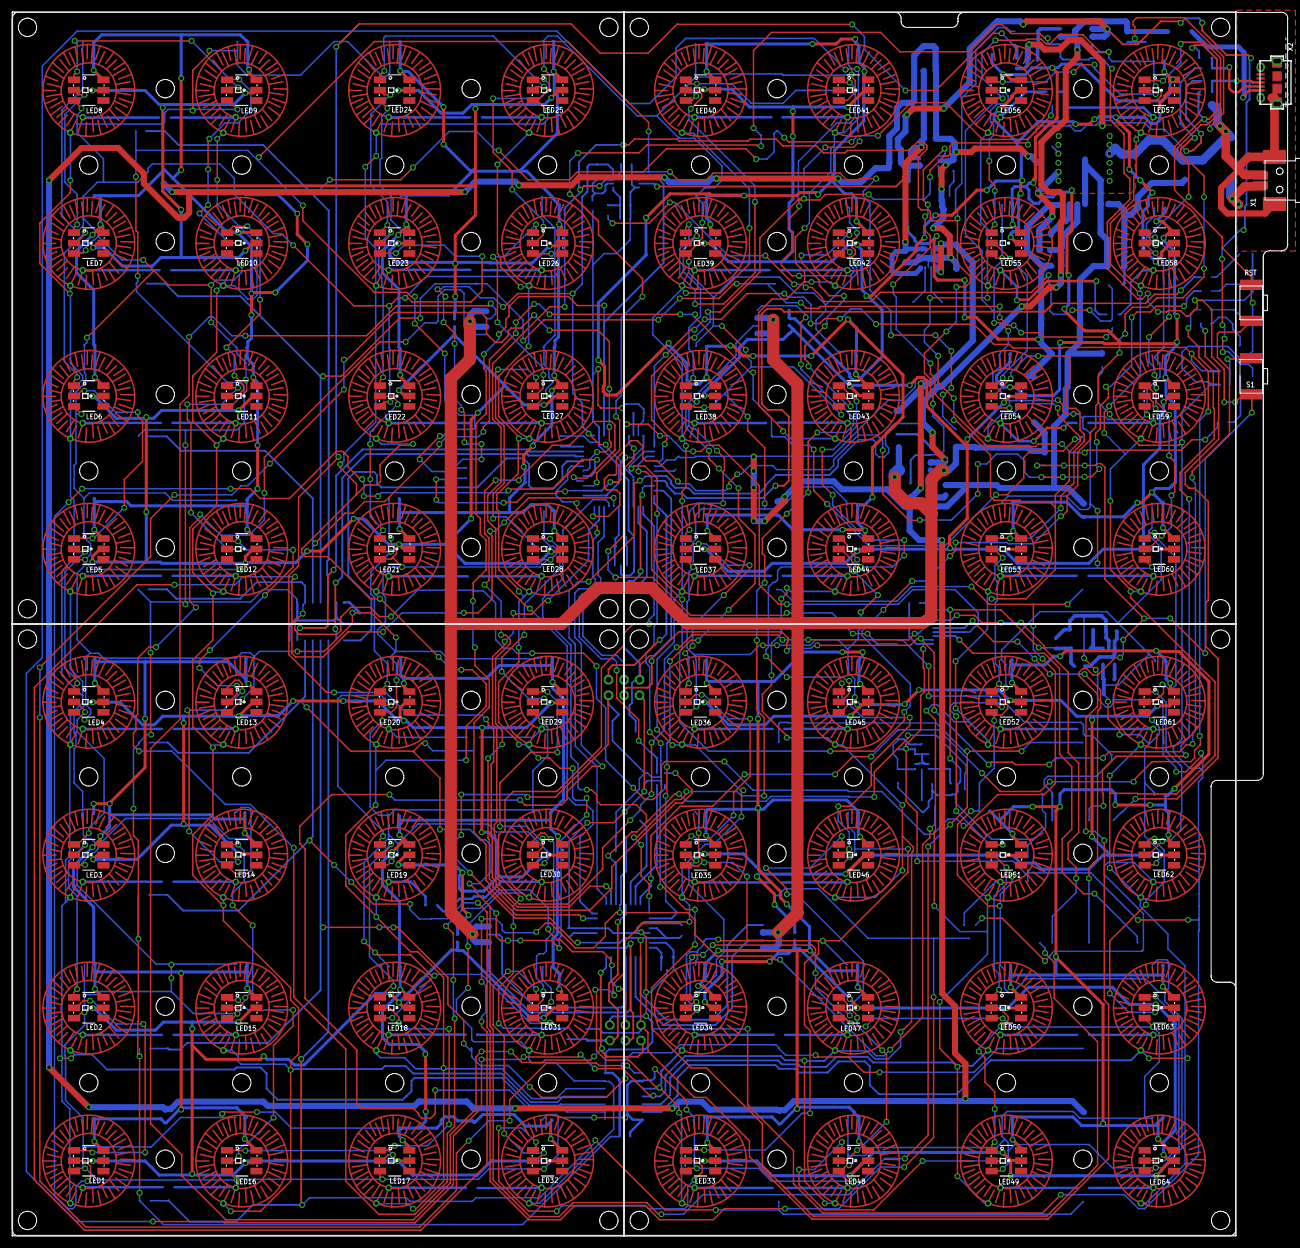
[picture p25: board Bhoreal Slimpro.brd from above]

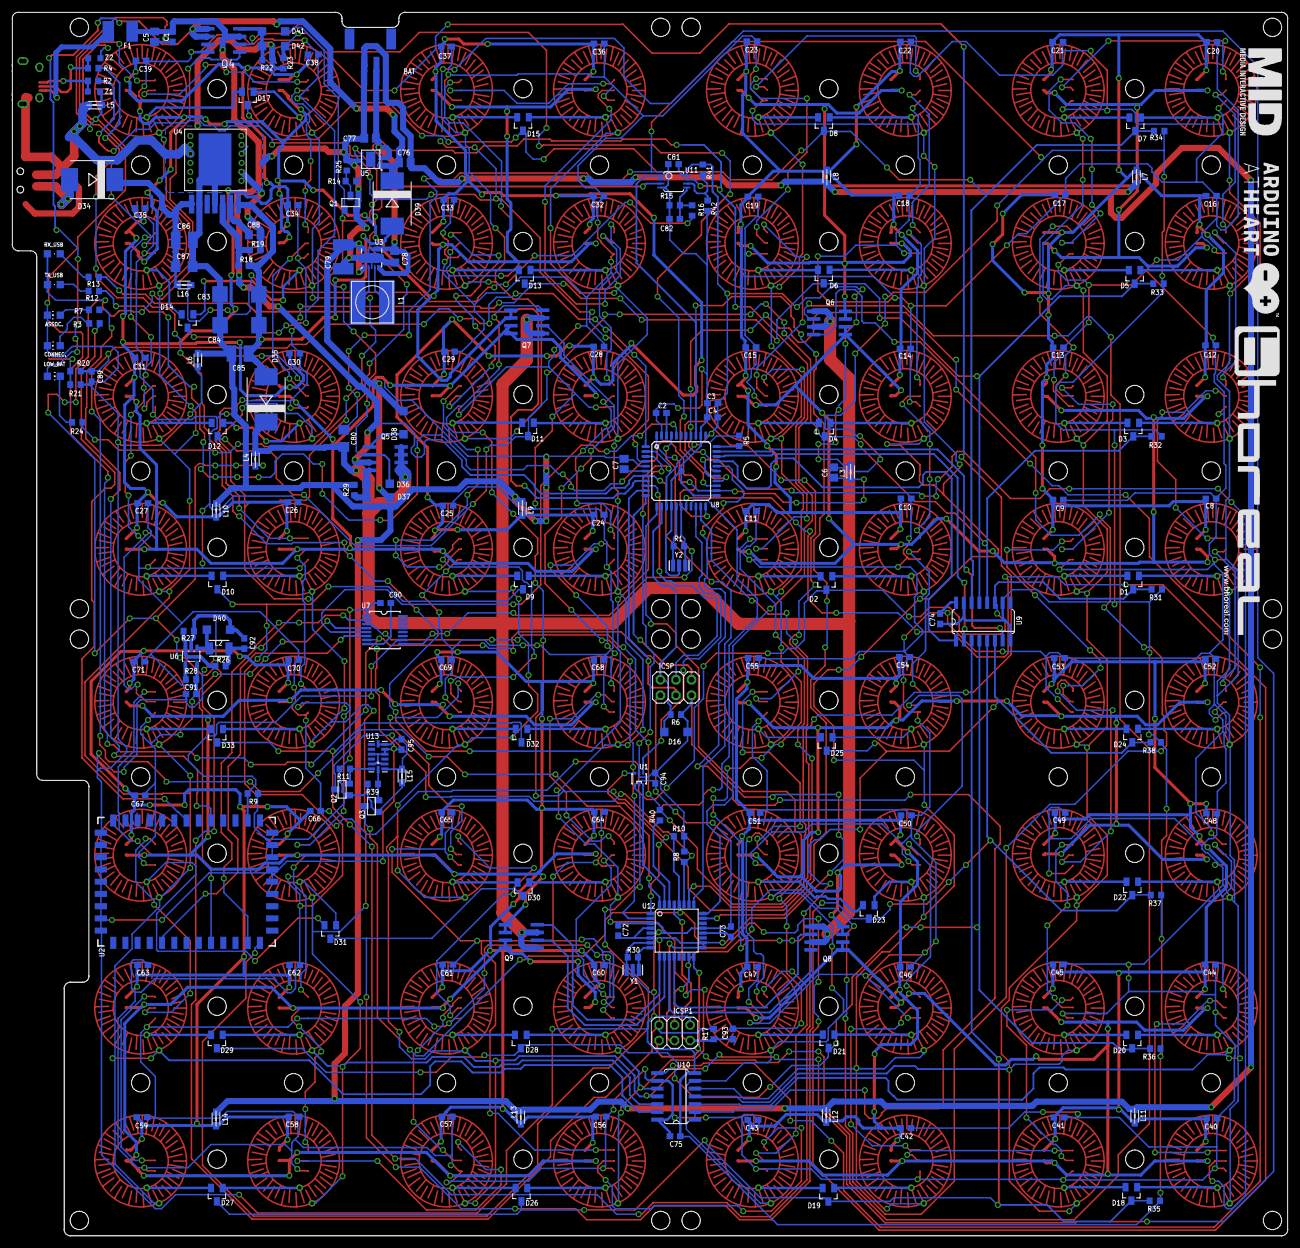
[picture p26: board Bhoreal Slimpro.brd from below]

Board: 2 copper layers, 208.5 x 200.0 mm, 238 parts (230 on the bottom side), 255 nets.
