bhoreal/bhoreal/hardware/Bhoreal Mini Slim Schematics/Bhoreal mini.brd

## EAGLE design hardware/Bhoreal Mini Slim Schematics/Bhoreal mini.brd (2017-07-10)

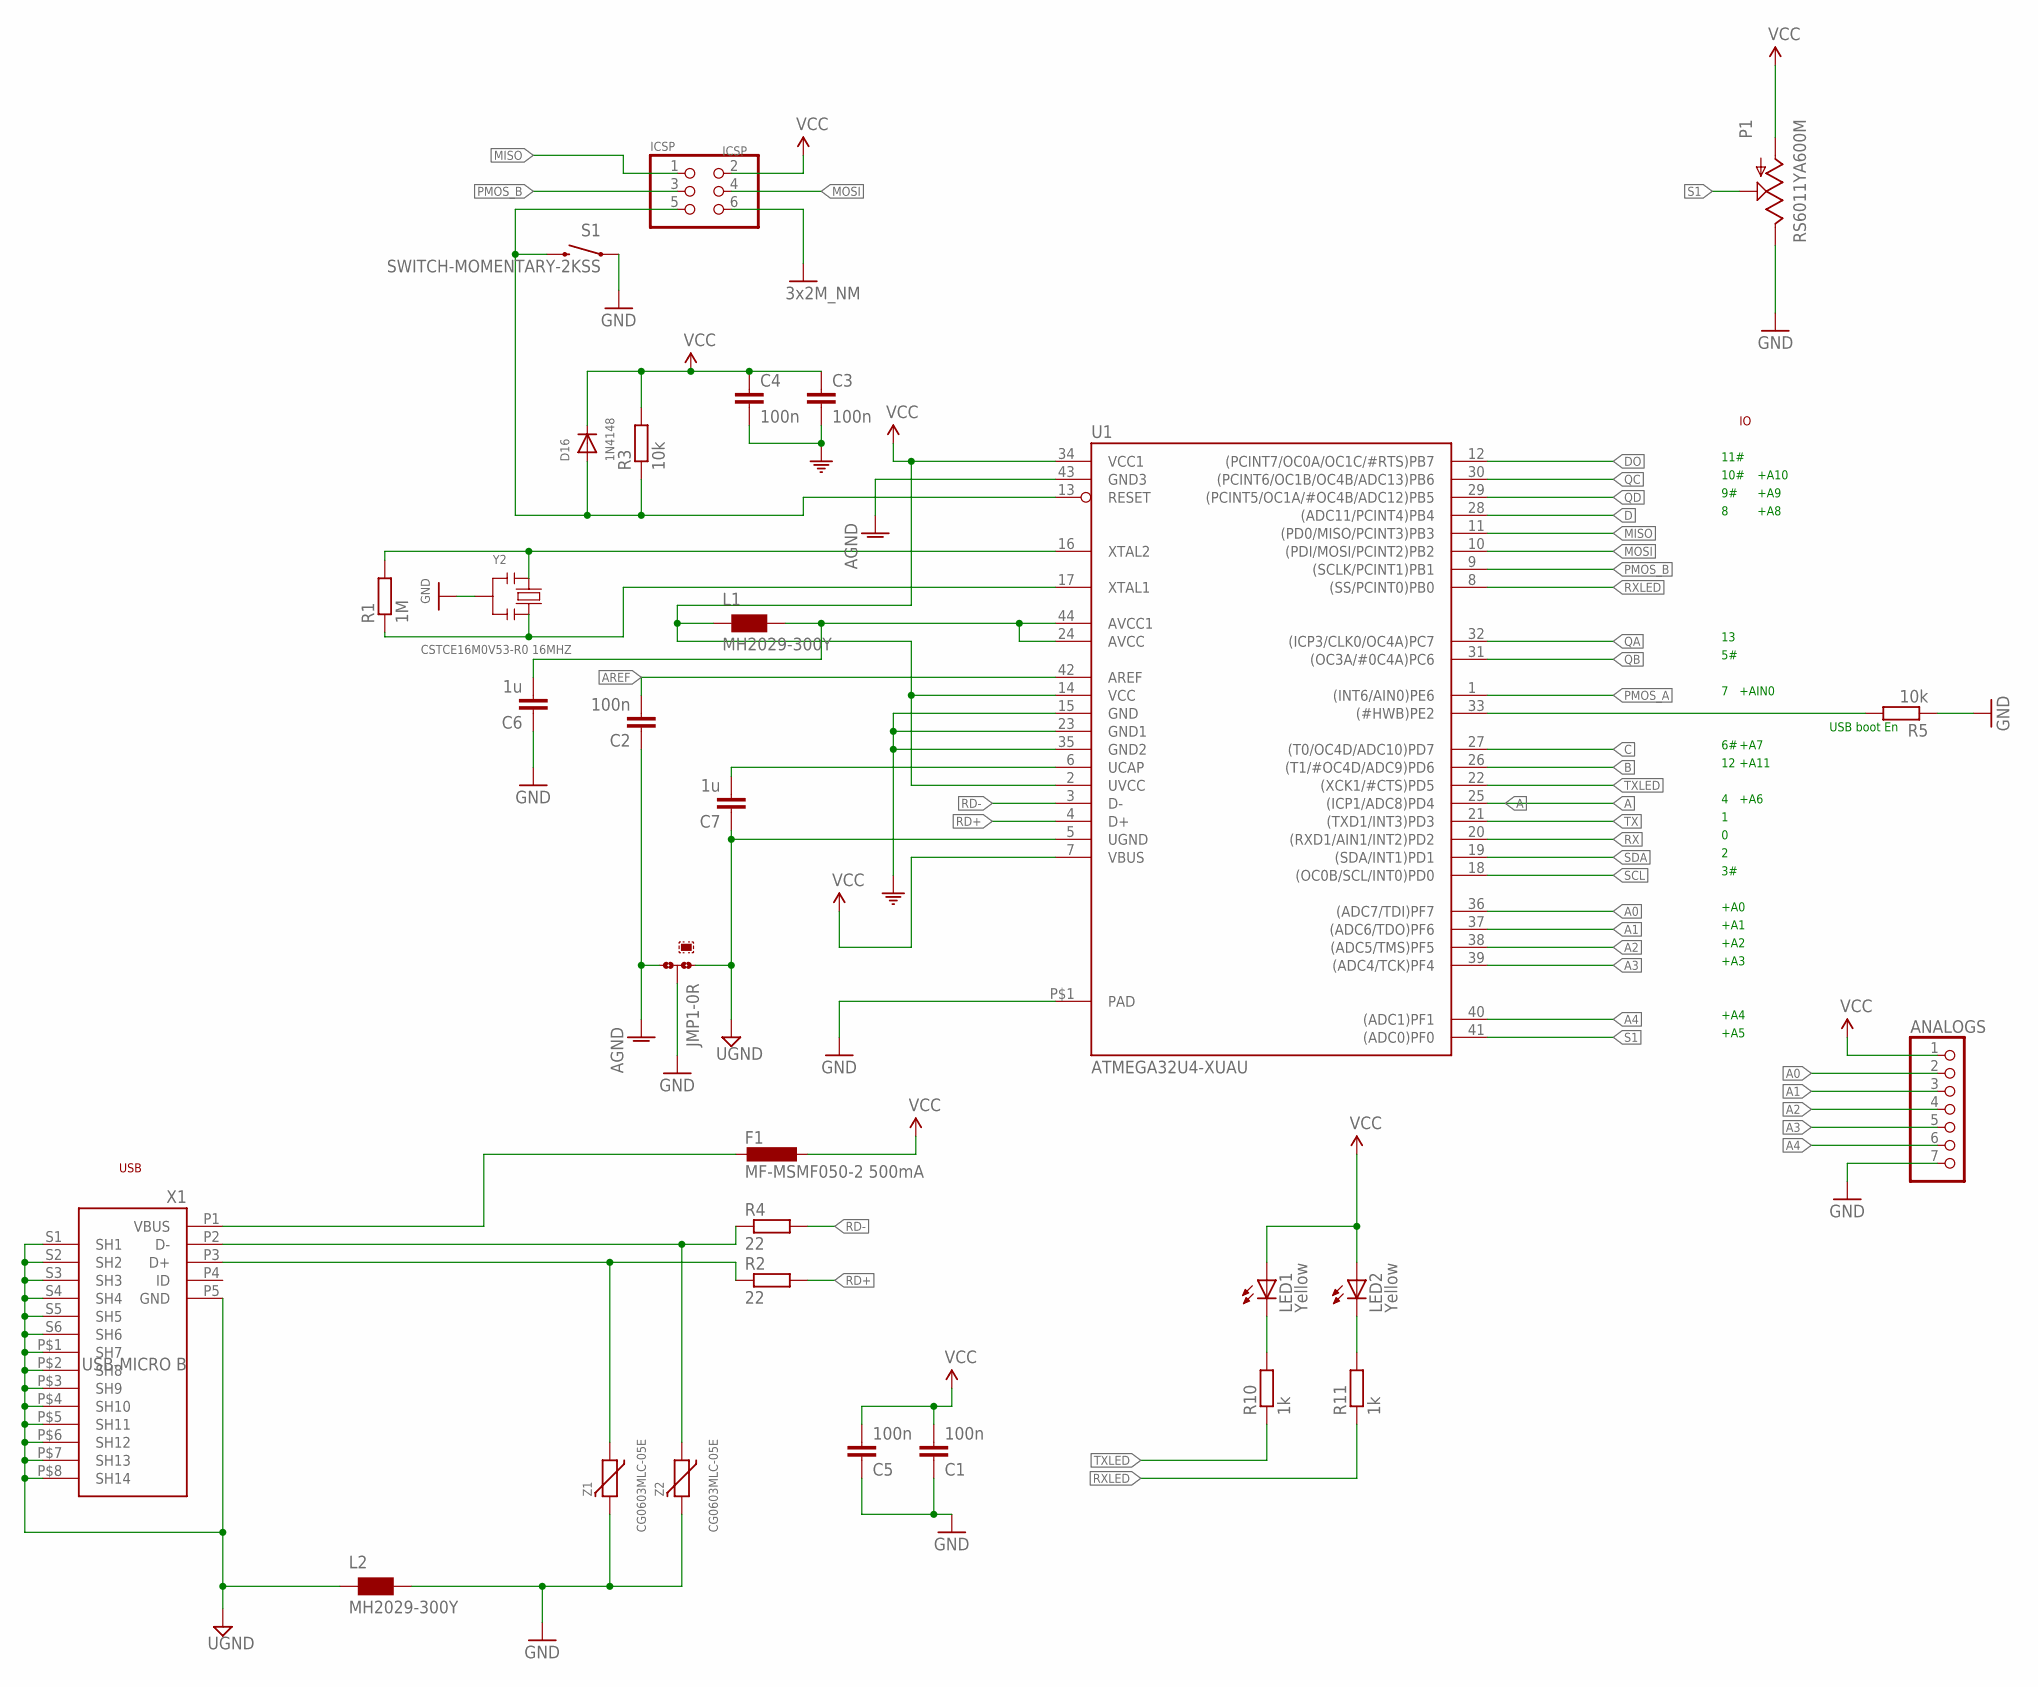
[picture p27: schematic Bhoreal mini.sch, sheet 1]

Parts:
ANALOGS: PINHD-1X7; 1X07
C1, C2, C3, C4, C5: 100n; C0603K
C6, C7: 1u; C0805
D16: 1N4148; SOD-323F
F1: MF-MSMF050-2 500mA; L1812
ICSP: ICSP; 2X03
JMP1: 0R-JUMPC; C0R-JMP
L1, L2: MH2029-300Y; 0805
LED1, LED2: Yellow; CHIPLED_0805
P1: RS6011YA600M
R1: 1M; R0603
R2, R4: 22; R0603
R3, R5: 10k; R0603
R10, R11: 1k; R0603
S1: SWITCH-MOMENTARY-2KSS; KSS241G
U1: ATMEGA32U4-XUAU; TQFP44-PAD
X1: USB-MICRO B; CON2_USB_MICRO_B_AT
Y2: CSTCE16M0V53-R0 16MHZ; RESONATOR
Z1, Z2: CG0603MLC-05E; CT/CN0603

Connections:
A: U1.25 ((ICP1/ADC8)PD4); also elsewhere on the board
A0: ANALOGS.2, U1.36 ((ADC7/TDI)PF7)
A1: ANALOGS.3, U1.37 ((ADC6/TDO)PF6)
A2: ANALOGS.4, U1.38 ((ADC5/TMS)PF5)
A3: ANALOGS.5, U1.39 ((ADC4/TCK)PF4)
A4: ANALOGS.6, U1.40 ((ADC1)PF1)
AGND: C2.1, JMP1.3, U1.43 (GND3)
AREF: C2.2, U1.42 (AREF)
AVCC: C6.2, L1.2, U1.24 (AVCC), U1.44 (AVCC1)
B: U1.26 ((T1/#OC4D/ADC9)PD6); also elsewhere on the board
C: U1.27 ((T0/OC4D/ADC10)PD7); also elsewhere on the board
D: U1.28 ((ADC11/PCINT4)PB4); also elsewhere on the board
D+: R2.1, X1.P3 (D+), Z1.1
D-: R4.1, X1.P2 (D-), Z2.1
DO: U1.12 ((PCINT7/OC0A/OC1C/#RTS)PB7); also elsewhere on the board
GND: ANALOGS.7, C1.1, C3.2, C4.2, C5.1, C6.1, ICSP.6, JMP1.2, L2.2, P1.2 (E), R5.1, S1.1, U1.15 (GND), U1.23 (GND1), U1.35 (GND2), U1.P$1 (PAD), Y2.2, Z1.2, Z2.2; also elsewhere on the board
HWB: R5.2, U1.33 ((#HWB)PE2)
MISO: ICSP.1, U1.11 ((PD0/MISO/PCINT3)PB3)
MOSI: ICSP.4, U1.10 ((PDI/MOSI/PCINT2)PB2)
unnamed: LED1.C, R10.2
unnamed: LED2.C, R11.2
PMOS_A: U1.1 ((INT6/AIN0)PE6); also elsewhere on the board
PMOS_B: ICSP.3, U1.9 ((SCLK/PCINT1)PB1); also elsewhere on the board
QA: U1.32 ((ICP3/CLK0/OC4A)PC7); also elsewhere on the board
QB: U1.31 ((OC3A/#0C4A)PC6); also elsewhere on the board
QC: U1.30 ((PCINT6/OC1B/OC4B/ADC13)PB6); also elsewhere on the board
QD: U1.29 ((PCINT5/OC1A/#OC4B/ADC12)PB5); also elsewhere on the board
RD+: R2.2, U1.4 (D+)
RD-: R4.2, U1.3 (D-)
RESET: D16.A, ICSP.5, R3.1, S1.2, U1.13 (RESET)
RX: U1.20 ((RXD1/AIN1/INT2)PD2)
RXLED: R11.1, U1.8 ((SS/PCINT0)PB0)
S1: P1.1 (S), U1.41 ((ADC0)PF0)
SCL: U1.18 ((OC0B/SCL/INT0)PD0)
SDA: U1.19 ((SDA/INT1)PD1)
TX: U1.21 ((TXD1/INT3)PD3)
TXLED: R10.1, U1.22 ((XCK1/#CTS)PD5)
UCAP: C7.2, U1.6 (UCAP)
UGND: C7.1, JMP1.1, L2.1, U1.5 (UGND), X1.P5 (GND), X1.P$1 (SH7), X1.P$2 (SH8), X1.P$3 (SH9), X1.P$4 (SH10), X1.P$5 (SH11), X1.P$6 (SH12), X1.P$7 (SH13), X1.P$8 (SH14), X1.S1 (SH1), X1.S2 (SH2), X1.S3 (SH3), X1.S4 (SH4), X1.S5 (SH5), X1.S6 (SH6)
VCC: ANALOGS.1, C1.2, C3.1, C4.1, C5.2, D16.C, F1.1, ICSP.2, L1.1, LED1.A, LED2.A, P1.3 (A), R3.2, U1.2 (UVCC), U1.7 (VBUS), U1.14 (VCC), U1.34 (VCC1); also elsewhere on the board
XTAL3: R1.2, U1.16 (XTAL2), Y2.1
XTAL4: R1.1, U1.17 (XTAL1), Y2.3
XUSB: F1.2, X1.P1 (VBUS)

Notes on the sheet:
USB boot En
USB
10#
11#
+A6
+A11
+A10
+A9
+A7
+A8
+AIN0
+A0
+A1
+A2
+A3
+A4
+A5
