bhoreal/bhoreal/hardware/Bhoreal Mini Slim Schematics/Bhoreal mini.brd

## EAGLE design hardware/Bhoreal Mini Slim Schematics/Bhoreal mini.brd (continued)

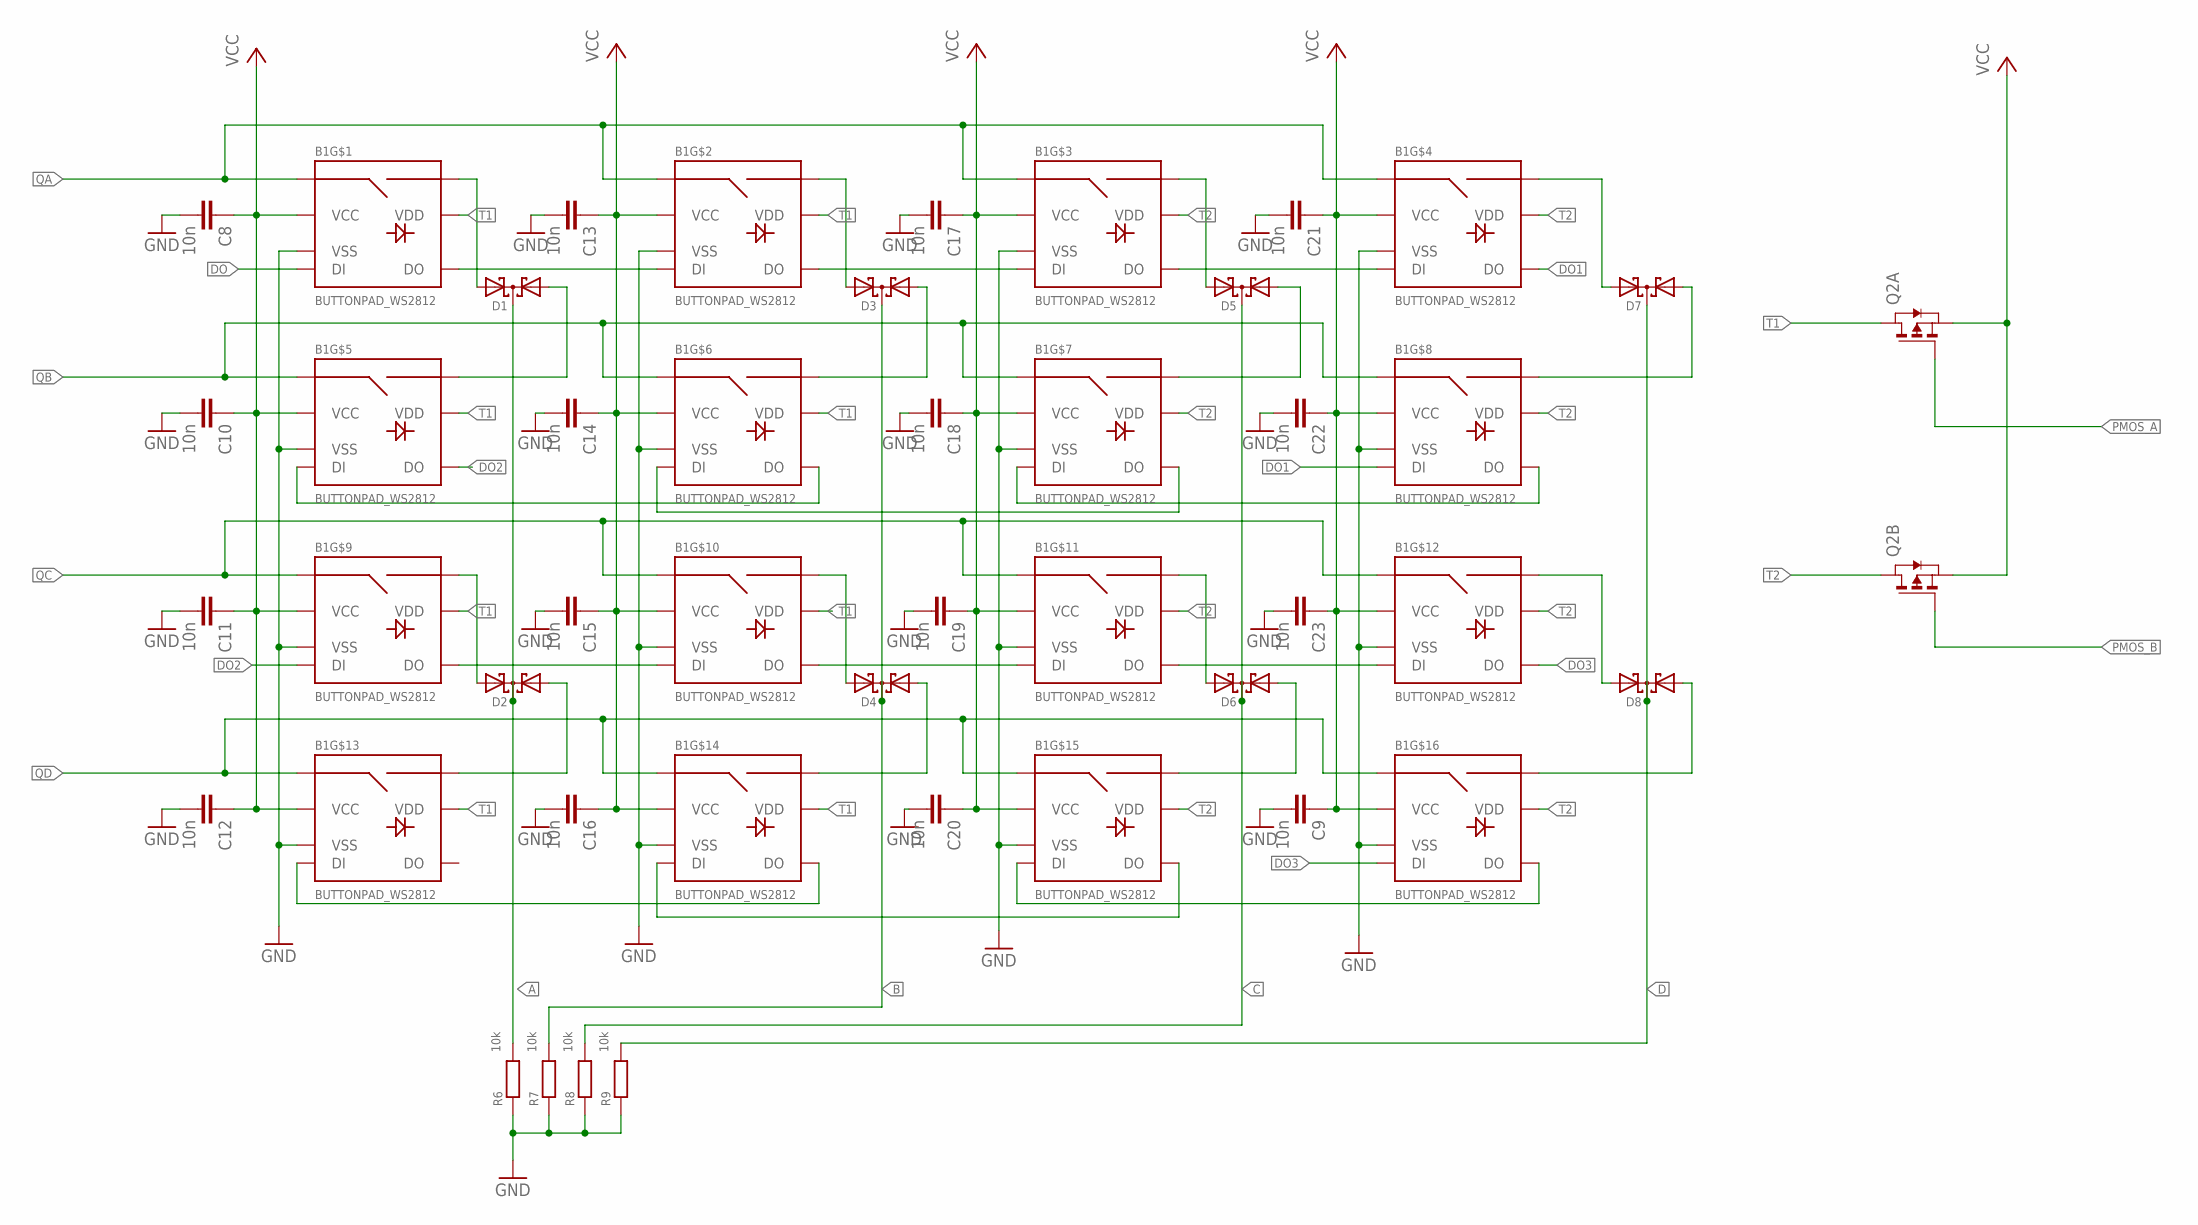
[picture p28: schematic Bhoreal mini.sch, sheet 2]

Parts:
B1: BUTTONPAD_WS2812
C8, C9, C10, C11, C12, C13, C14, C15, C16, C17, C18, C19, C20, C21, C22, C23: 10n; C0603
D1, D2, D3, D4, D5, D6, D7, D8: BAS70-05; SOT23
Q2: PMOS2SO8; SO8
R6, R7, R8, R9: 10k; R0603

Connections:
A: D1.3 (C), D2.3 (C), R6.2; also elsewhere on the board
B: D3.3 (C), D4.3 (C), R7.2; also elsewhere on the board
C: D5.3 (C), D6.3 (C), R8.2; also elsewhere on the board
D: D7.3 (C), D8.3 (C), R9.2; also elsewhere on the board
DO: B1.2A (DI); also elsewhere on the board
DO1: B1.1D (DO), B1.2H (DI)
DO2: B1.1E (DO), B1.2I (DI)
DO3: B1.1L (DO), B1.2P (DI)
GND: B1.6A (VSS), B1.6B (VSS), B1.6C (VSS), B1.6D (VSS), B1.6E (VSS), B1.6F (VSS), B1.6G (VSS), B1.6H (VSS), B1.6I (VSS), B1.6J (VSS), B1.6K (VSS), B1.6L (VSS), B1.6M (VSS), B1.6N (VSS), B1.6O (VSS), B1.6P (VSS), C8.2, C9.2, C10.2, C11.2, C12.2, C13.2, C14.2, C15.2, C16.2, C17.2, C18.2, C19.2, C20.2, C21.2, C22.2, C23.2, R6.1, R7.1, R8.1, R9.1; also elsewhere on the board
unnamed: B1.SIG2A (SIG2), D1.2 (A2)
unnamed: B1.SIG2E (SIG2), D1.1 (A1)
unnamed: B1.SIG2I (SIG2), D2.2 (A2)
unnamed: B1.SIG2M (SIG2), D2.1 (A1)
unnamed: B1.SIG2B (SIG2), D3.2 (A2)
unnamed: B1.SIG2F (SIG2), D3.1 (A1)
unnamed: B1.SIG2J (SIG2), D4.2 (A2)
unnamed: B1.SIG2N (SIG2), D4.1 (A1)
unnamed: B1.SIG2C (SIG2), D5.2 (A2)
unnamed: B1.SIG2G (SIG2), D5.1 (A1)
unnamed: B1.SIG2K (SIG2), D6.2 (A2)
unnamed: B1.SIG2O (SIG2), D6.1 (A1)
unnamed: B1.SIG2L (SIG2), D8.2 (A2)
unnamed: B1.SIG2P (SIG2), D8.1 (A1)
unnamed: B1.SIG2D (SIG2), D7.2 (A2)
unnamed: B1.SIG2H (SIG2), D7.1 (A1)
unnamed: B1.1A (DO), B1.2B (DI)
unnamed: B1.1F (DO), B1.2E (DI)
unnamed: B1.1G (DO), B1.2F (DI)
unnamed: B1.1B (DO), B1.2C (DI)
unnamed: B1.1C (DO), B1.2D (DI)
unnamed: B1.1H (DO), B1.2G (DI)
unnamed: B1.1K (DO), B1.2L (DI)
unnamed: B1.1J (DO), B1.2K (DI)
unnamed: B1.1I (DO), B1.2J (DI)
unnamed: B1.1P (DO), B1.2O (DI)
unnamed: B1.1O (DO), B1.2N (DI)
unnamed: B1.1N (DO), B1.2M (DI)
PMOS_A: Q2.2 (G); also elsewhere on the board
PMOS_B: Q2.4 (G); also elsewhere on the board
QA: B1.SIG1A (SIG1), B1.SIG1B (SIG1), B1.SIG1C (SIG1), B1.SIG1D (SIG1); also elsewhere on the board
QB: B1.SIG1E (SIG1), B1.SIG1F (SIG1), B1.SIG1G (SIG1), B1.SIG1H (SIG1); also elsewhere on the board
QC: B1.SIG1I (SIG1), B1.SIG1J (SIG1), B1.SIG1K (SIG1), B1.SIG1L (SIG1); also elsewhere on the board
QD: B1.SIG1M (SIG1), B1.SIG1N (SIG1), B1.SIG1O (SIG1), B1.SIG1P (SIG1); also elsewhere on the board
T1: B1.5A (VDD), B1.5B (VDD), B1.5E (VDD), B1.5F (VDD), B1.5I (VDD), B1.5J (VDD), B1.5M (VDD), B1.5N (VDD), Q2.7 (D), Q2.8 (D)
T2: B1.5C (VDD), B1.5D (VDD), B1.5G (VDD), B1.5H (VDD), B1.5K (VDD), B1.5L (VDD), B1.5O (VDD), B1.5P (VDD), Q2.5 (D), Q2.6 (D)
VCC: B1.3A (VCC), B1.3B (VCC), B1.3C (VCC), B1.3D (VCC), B1.3E (VCC), B1.3F (VCC), B1.3G (VCC), B1.3H (VCC), B1.3I (VCC), B1.3J (VCC), B1.3K (VCC), B1.3L (VCC), B1.3M (VCC), B1.3N (VCC), B1.3O (VCC), B1.3P (VCC), C8.1, C9.1, C10.1, C11.1, C12.1, C13.1, C14.1, C15.1, C16.1, C17.1, C18.1, C19.1, C20.1, C21.1, C22.1, C23.1, Q2.1 (S), Q2.3 (S); also elsewhere on the board

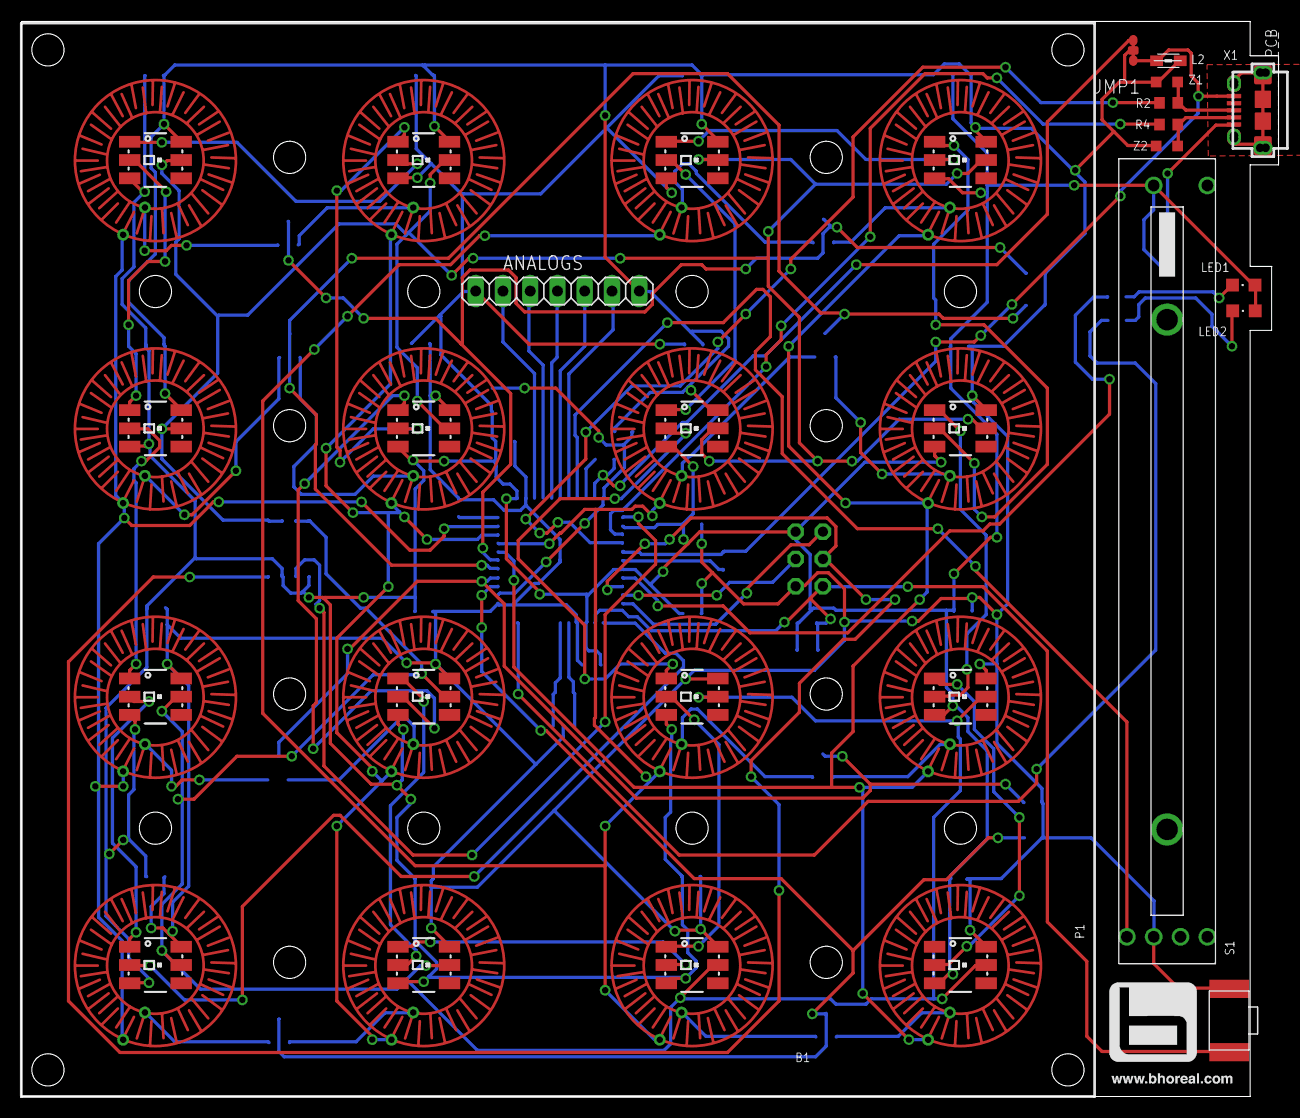
[picture p29: board Bhoreal mini.brd from above]

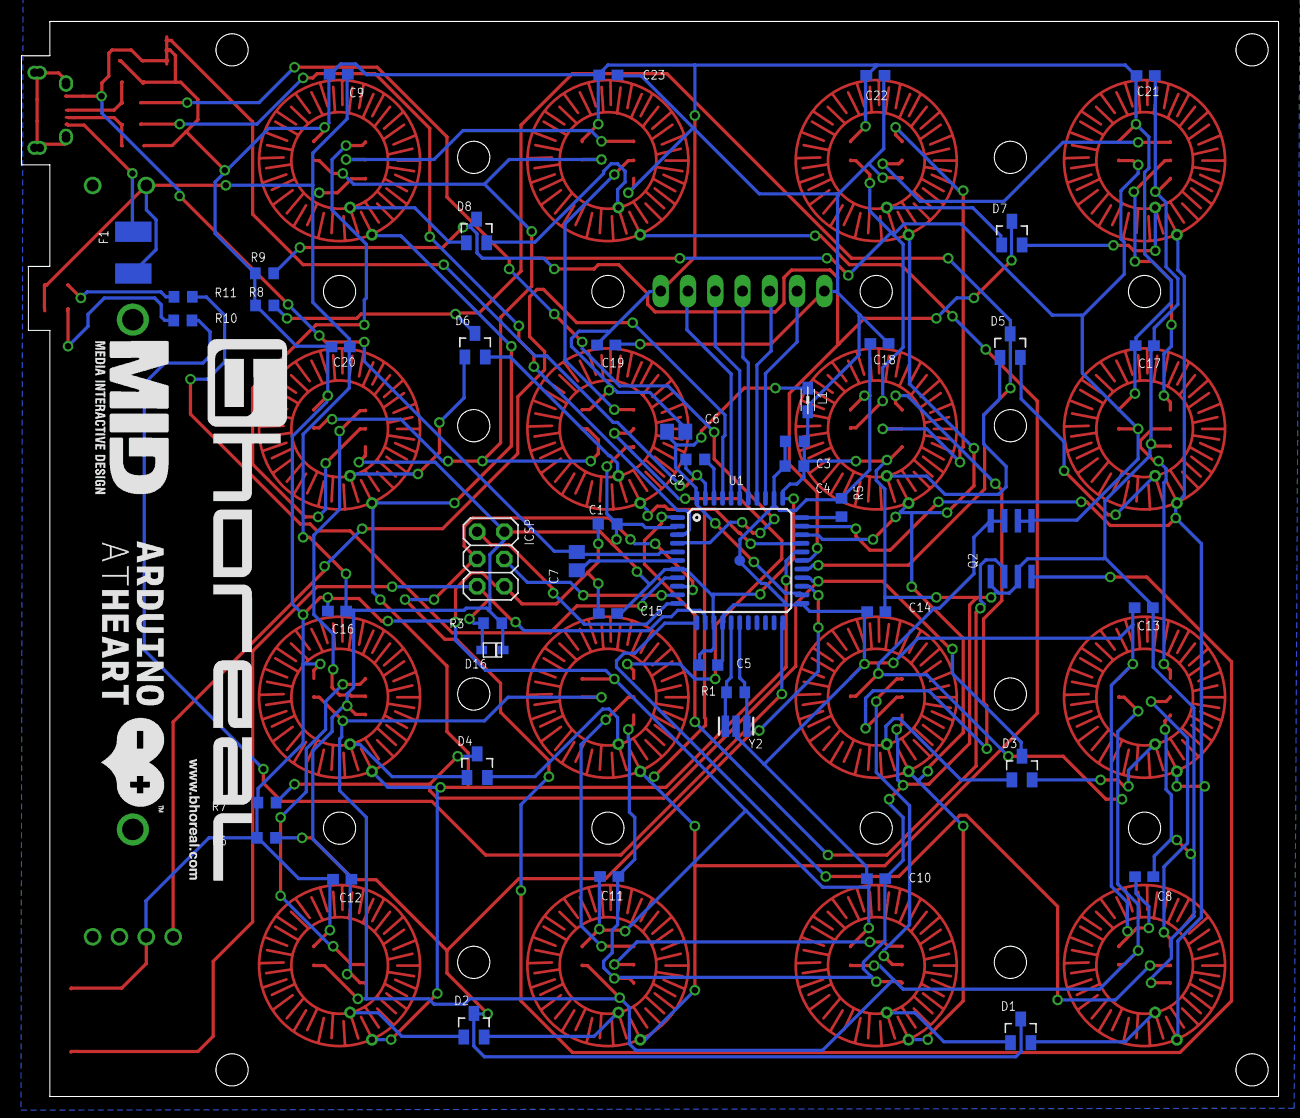
[picture p30: board Bhoreal mini.brd from below]

Board: 2 copper layers, 117.1 x 100.2 mm, 60 parts (47 on the bottom side), 72 nets.
