bhoreal/bhoreal/software/Processing/Bhoreal_MIDI_OSC_com/GUI_funcs.pde

public void cpPad0() {
  note.setChannel(1);
  note.setPitch(0);
  note.setVelocity(PAD_Color);
  myBus.sendNoteOn(note);
}
public void cpPad1() {
  note.setChannel(1);
  note.setPitch(1);
  note.setVelocity(PAD_Color);
  myBus.sendNoteOn(note);
}
public void cpPad2() {
  note.setChannel(1);
  note.setPitch(2);
  note.setVelocity(PAD_Color);
  myBus.sendNoteOn(note);
}
public void cpPad3() {
  note.setChannel(1);
  note.setPitch(3);
  note.setVelocity(PAD_Color);
  myBus.sendNoteOn(note);
}
public void cpPad4() {
  note.setChannel(1);
  note.setPitch(4);
  note.setVelocity(PAD_Color);
  myBus.sendNoteOn(note);
}
public void cpPad5() {
  note.setChannel(1);
  note.setPitch(5);
  note.setVelocity(PAD_Color);
  myBus.sendNoteOn(note);
}
public void cpPad6() {
  note.setChannel(1);
  note.setPitch(6);
  note.setVelocity(PAD_Color);
  myBus.sendNoteOn(note);
}
public void cpPad7() {
  note.setChannel(1);
  note.setPitch(7);
  note.setVelocity(PAD_Color);
  myBus.sendNoteOn(note);
}
public void cpPad8() {
  note.setChannel(1);
  note.setPitch(8);
  note.setVelocity(PAD_Color);
  myBus.sendNoteOn(note);
}
public void cpPad9() {
  note.setChannel(1);
  note.setPitch(9);
  note.setVelocity(PAD_Color);
  myBus.sendNoteOn(note);
}
public void cpPad10() {
  note.setChannel(1);
  note.setPitch(10);
  note.setVelocity(PAD_Color);
  myBus.sendNoteOn(note);
}
public void cpPad11() {
  note.setChannel(1);
  note.setPitch(11);
  note.setVelocity(PAD_Color);
  myBus.sendNoteOn(note);
}
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
    padXY[1] = 3;
    break;
  case 12: 
    padXY[0] = 0;
    padXY[1] = 3;
    break;
  case 13: 
    padXY[0] = 1;
    padXY[1] = 3;
    break;
  case 14: 
    padXY[0] = 2;
    padXY[1] = 3;
    break;
  case 15: 
    padXY[0] = 3;
    padXY[1] = 3;
    break;
  }
  return padXY;
}
