bhoreal/bhoreal/(commit log)

2017-06-12 Windows7 Bhoreal Driver
    The required driver to connect Windows with Bhoreal.
2017-06-28 Bhoreal LED test
    A patch from MAX where you can select a Bhoreal pad and change its color
